evolutek/carte-alim/V5/Carte Alim V5-Power Tree.png

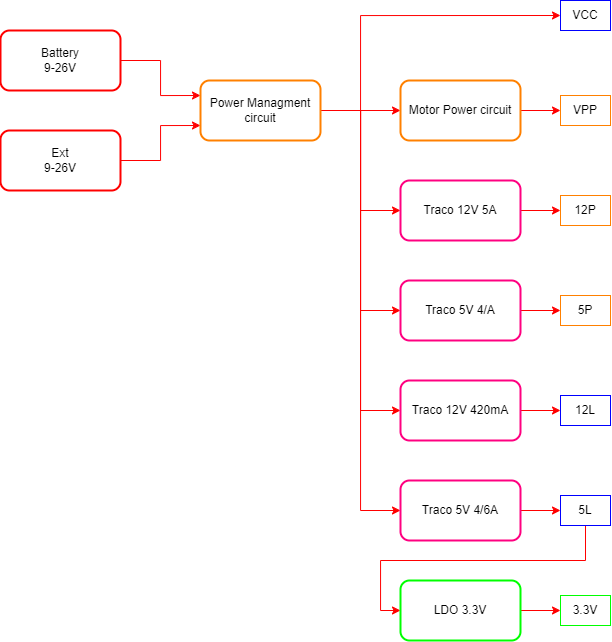
V5/Carte Alim V5-Power Tree.png
