evolutek/carte-alim/V5/Mapping STM32.png

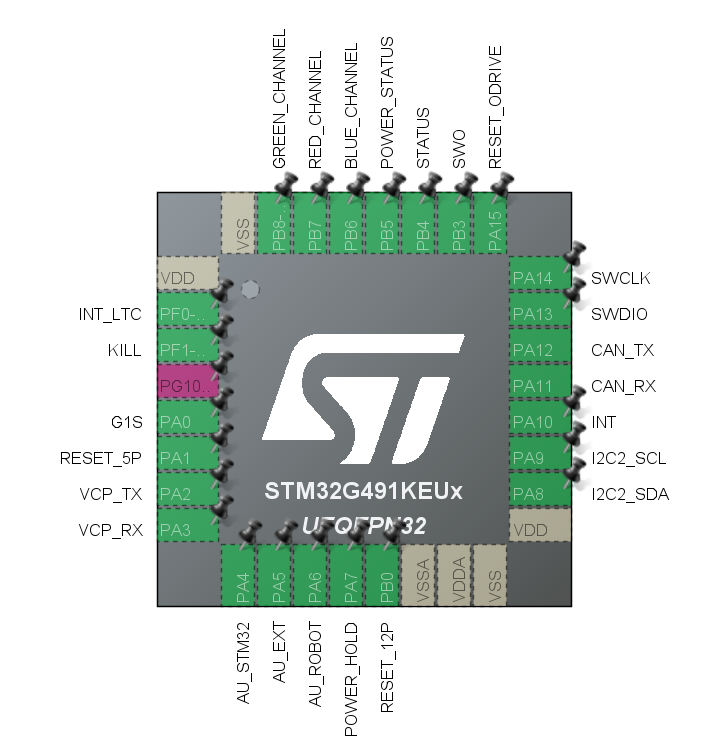
V5/Mapping STM32.png
