evolutek/carte-alim/Carte Dock LP-E10/Output/carte-dock-lp-e10.step

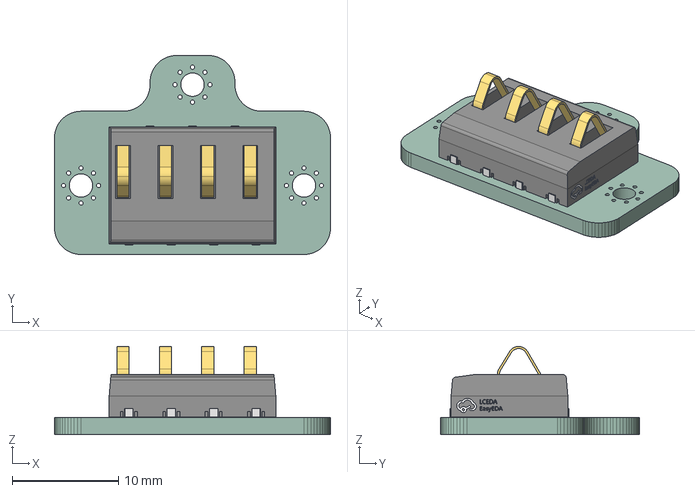
[picture p3: CAD file, 2025-04-11]
Carte Dock LP-E10/Output/carte-dock-lp-e10.step
26.0 x 18.8 x 8.30 mm
carte-dock-lp-e10 PCB
