evolutek/carte-alim/Carte Rack Batterie Vertical V1/Output/Carte Rack Batterie Vertical V1.step

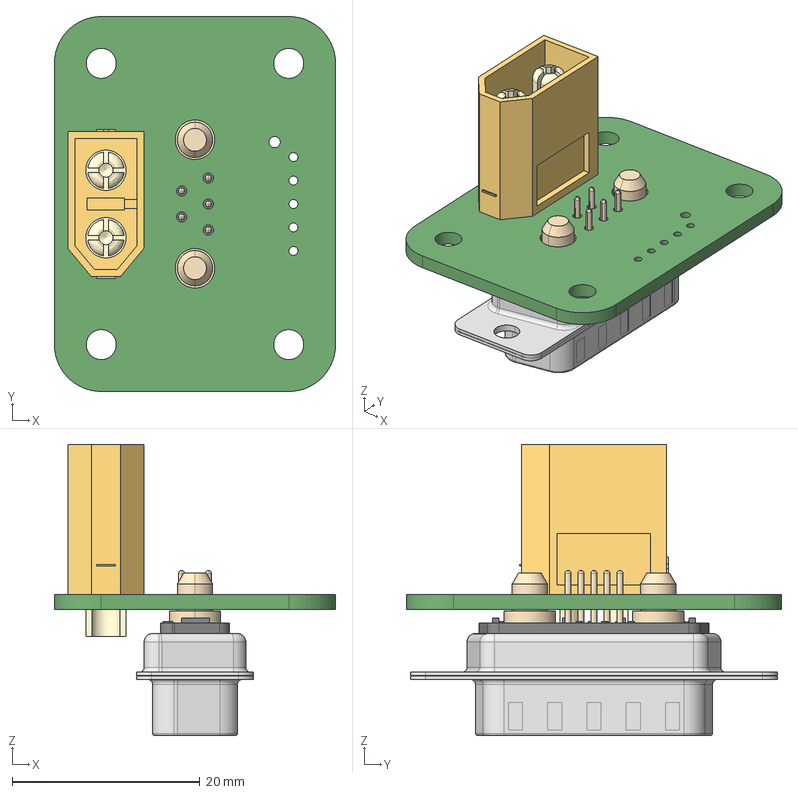
[picture p4: CAD file, 2021-10-24]
Carte Rack Batterie Vertical V1/Output/Carte Rack Batterie Vertical V1.step
30.0 x 40.0 x 31.1 mm
