evolutek/carte-alim/Hub puissance V1.0/Hub puissance V1.0.step

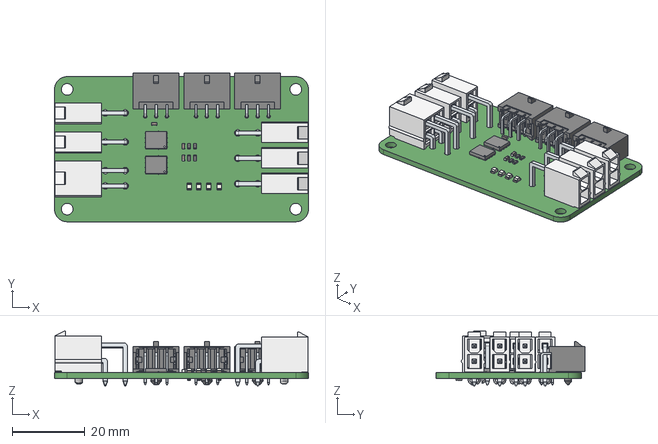
[picture p5: CAD file, 2021-01-19]
Hub puissance V1.0/Hub puissance V1.0.step
70.0 x 41.0 x 15.2 mm
