evolutek/carte-alim/Micro carte alim V1/Output/Schematics.pdf

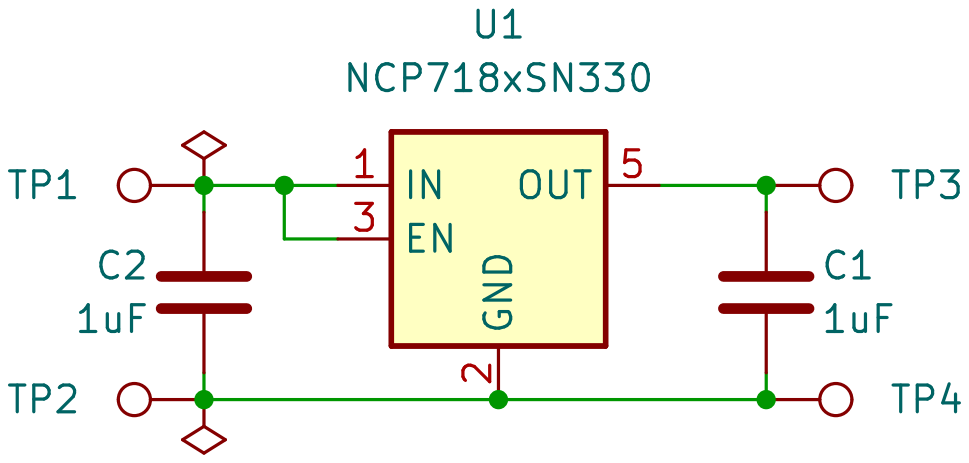
[picture p6: page 1]
