evolutek/carte-alim/Mini carte AU V1/Output/Schematics.pdf

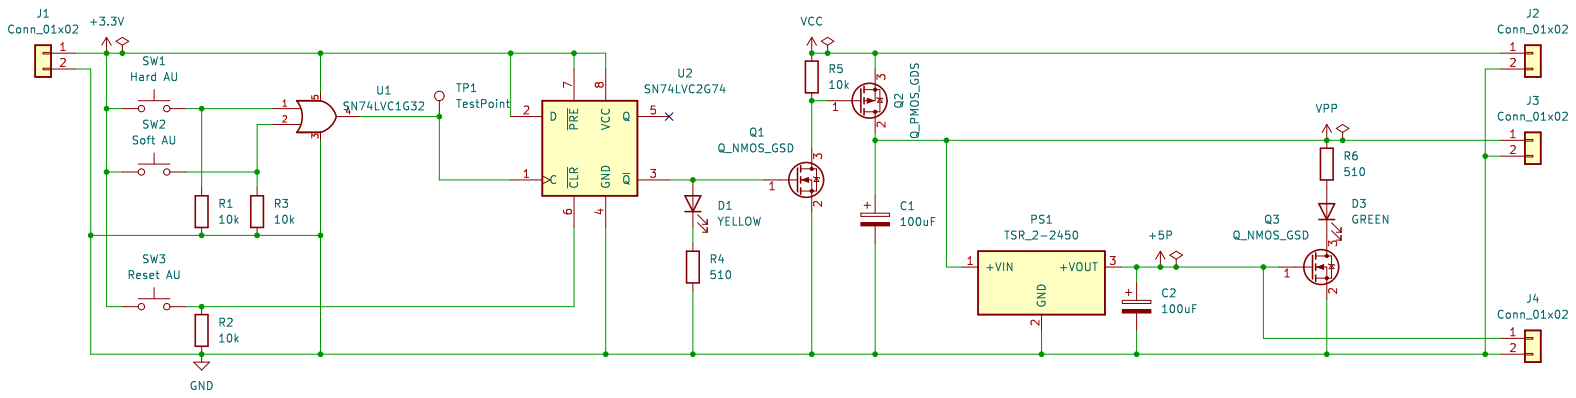
[picture p7: page 1]
