evolutek/carte-alim/Carte Dock LP-E10/Output/Schematics.pdf

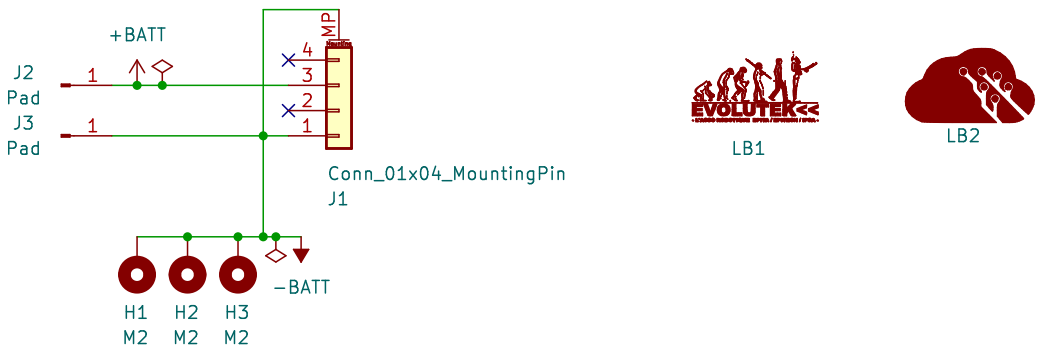
[picture p8: page 1]
