evolutek/carte-alim/PCB V2/Output/Schematics.pdf

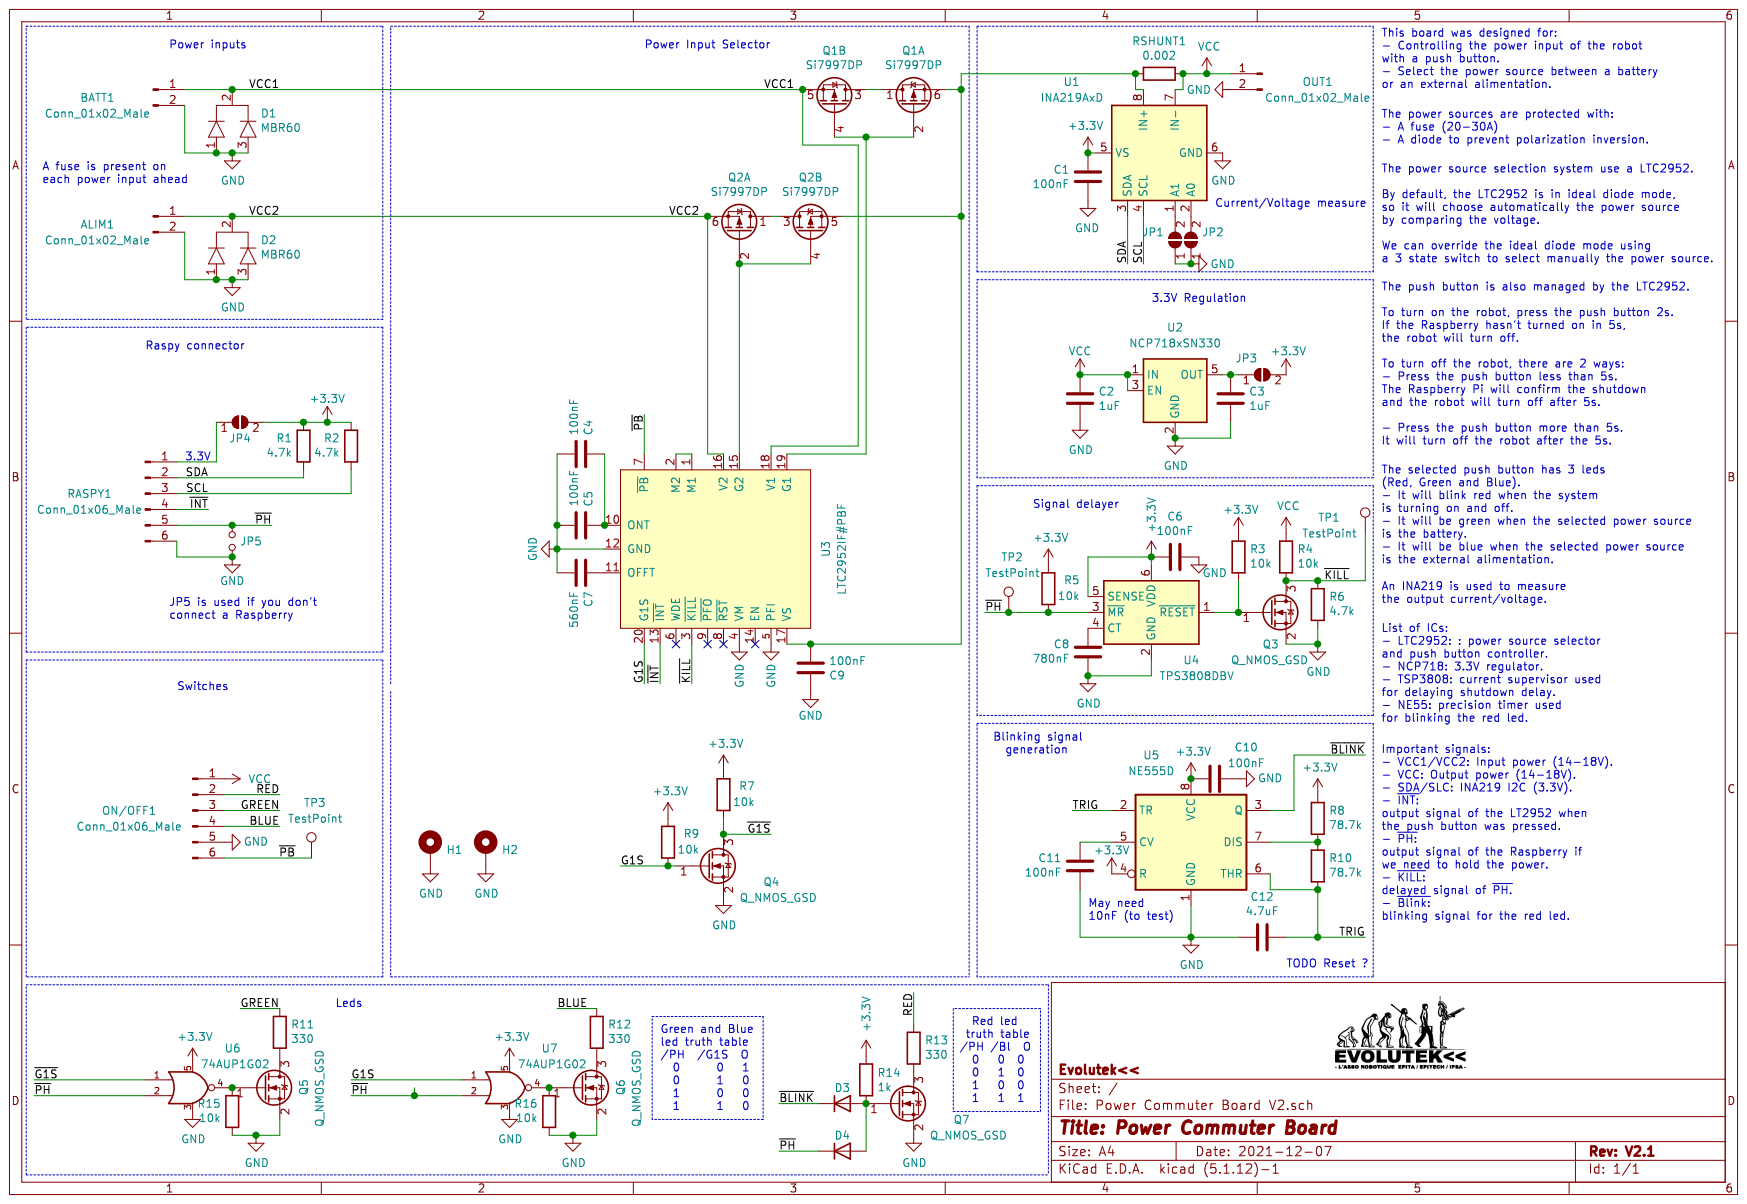
[picture p9: page 1]
