evolutek/carte-alim/Carte Rack Batterie Vertical V1/Output/Schematics.pdf

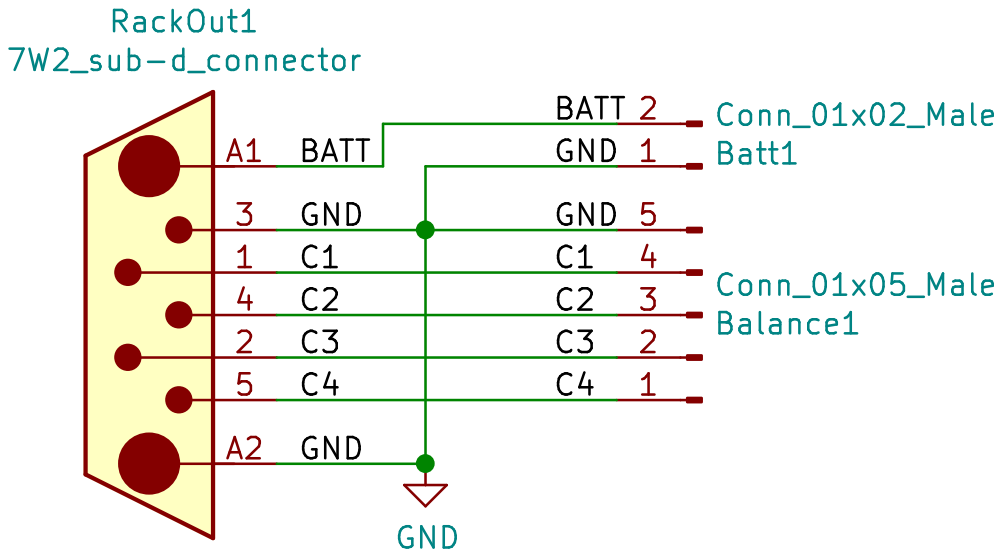
[picture p10: page 1]
