evolutek/carte-alim/Carte Rack Batterie Horizontal V1/Output/Schematics.pdf

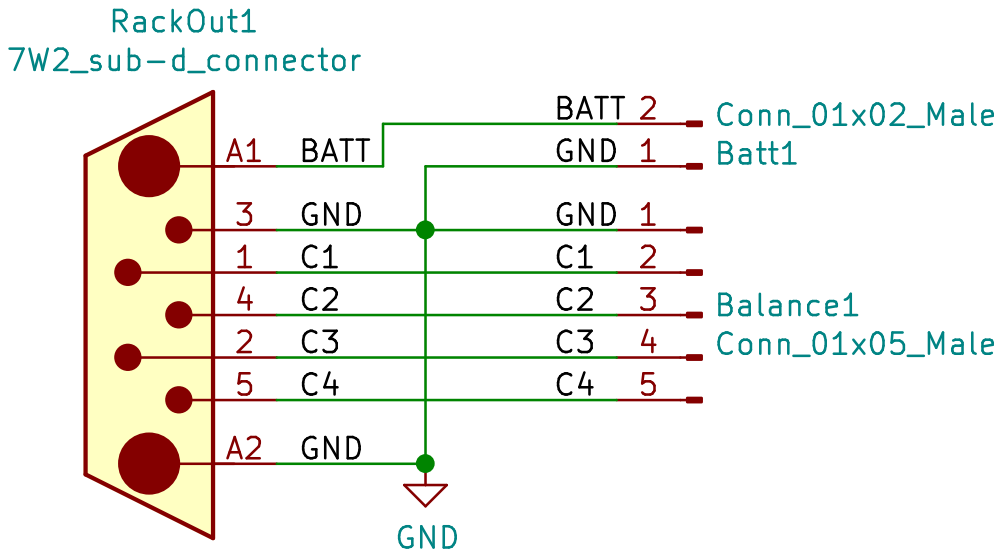
[picture p11: page 1]
