evolutek/carte-alim/Mini carte AU V1/Output/Board-Front.pdf

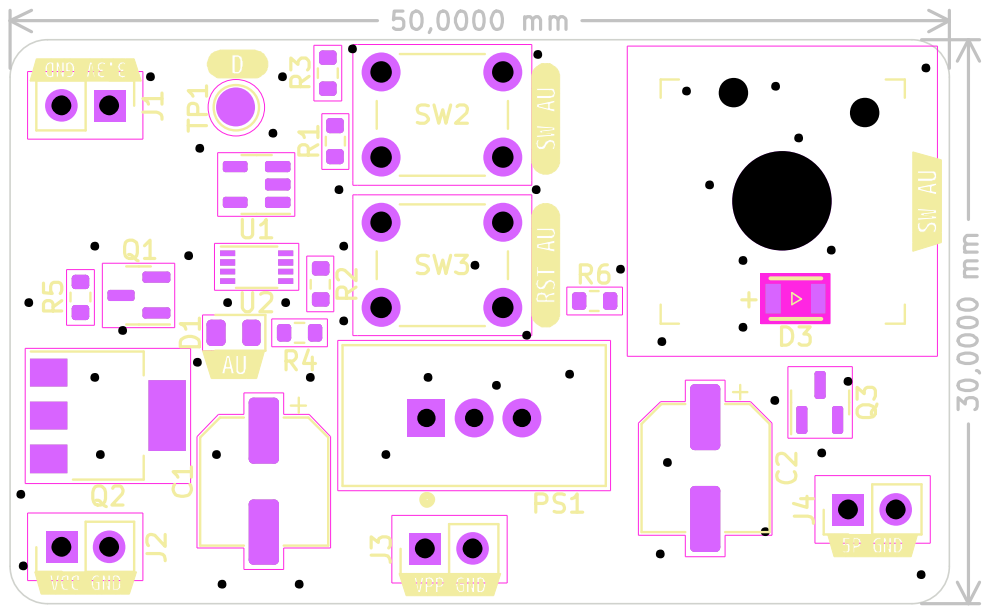
[picture p12: page 1]
