evolutek/carte-alim/Carte Dock LP-E10/Output/Board-Back.pdf

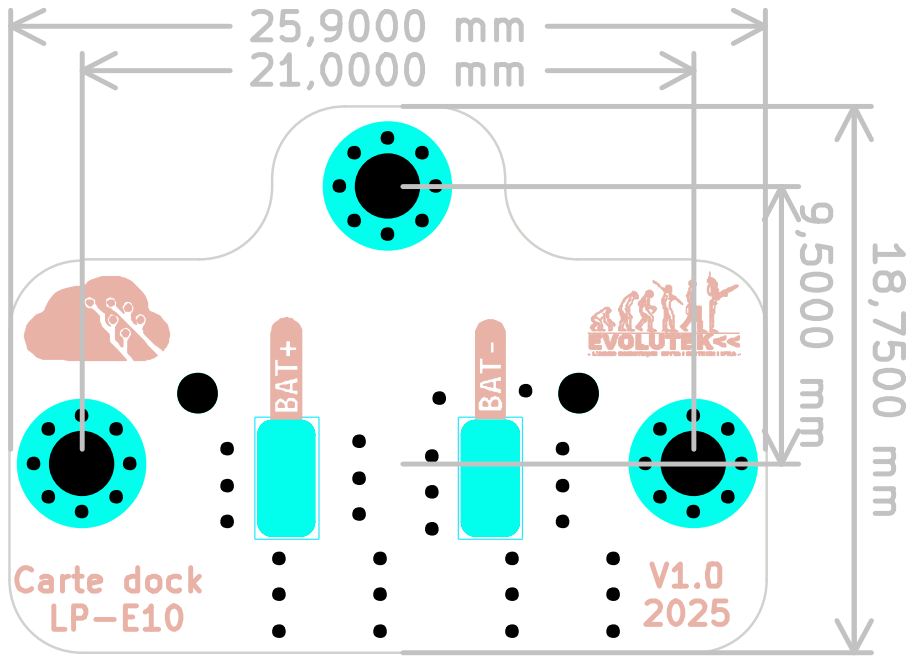
[picture p13: page 1]
