evolutek/carte-alim/Carte Dock LP-E10/Output/Board-Front.pdf

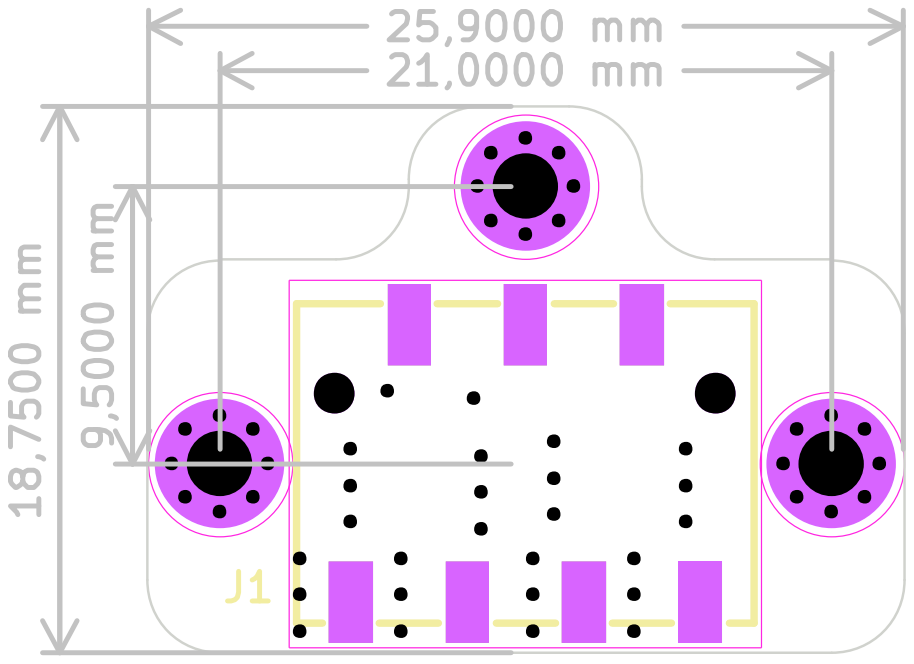
[picture p14: page 1]
