evolutek/carte-alim/PCB V1/Schematics.pdf

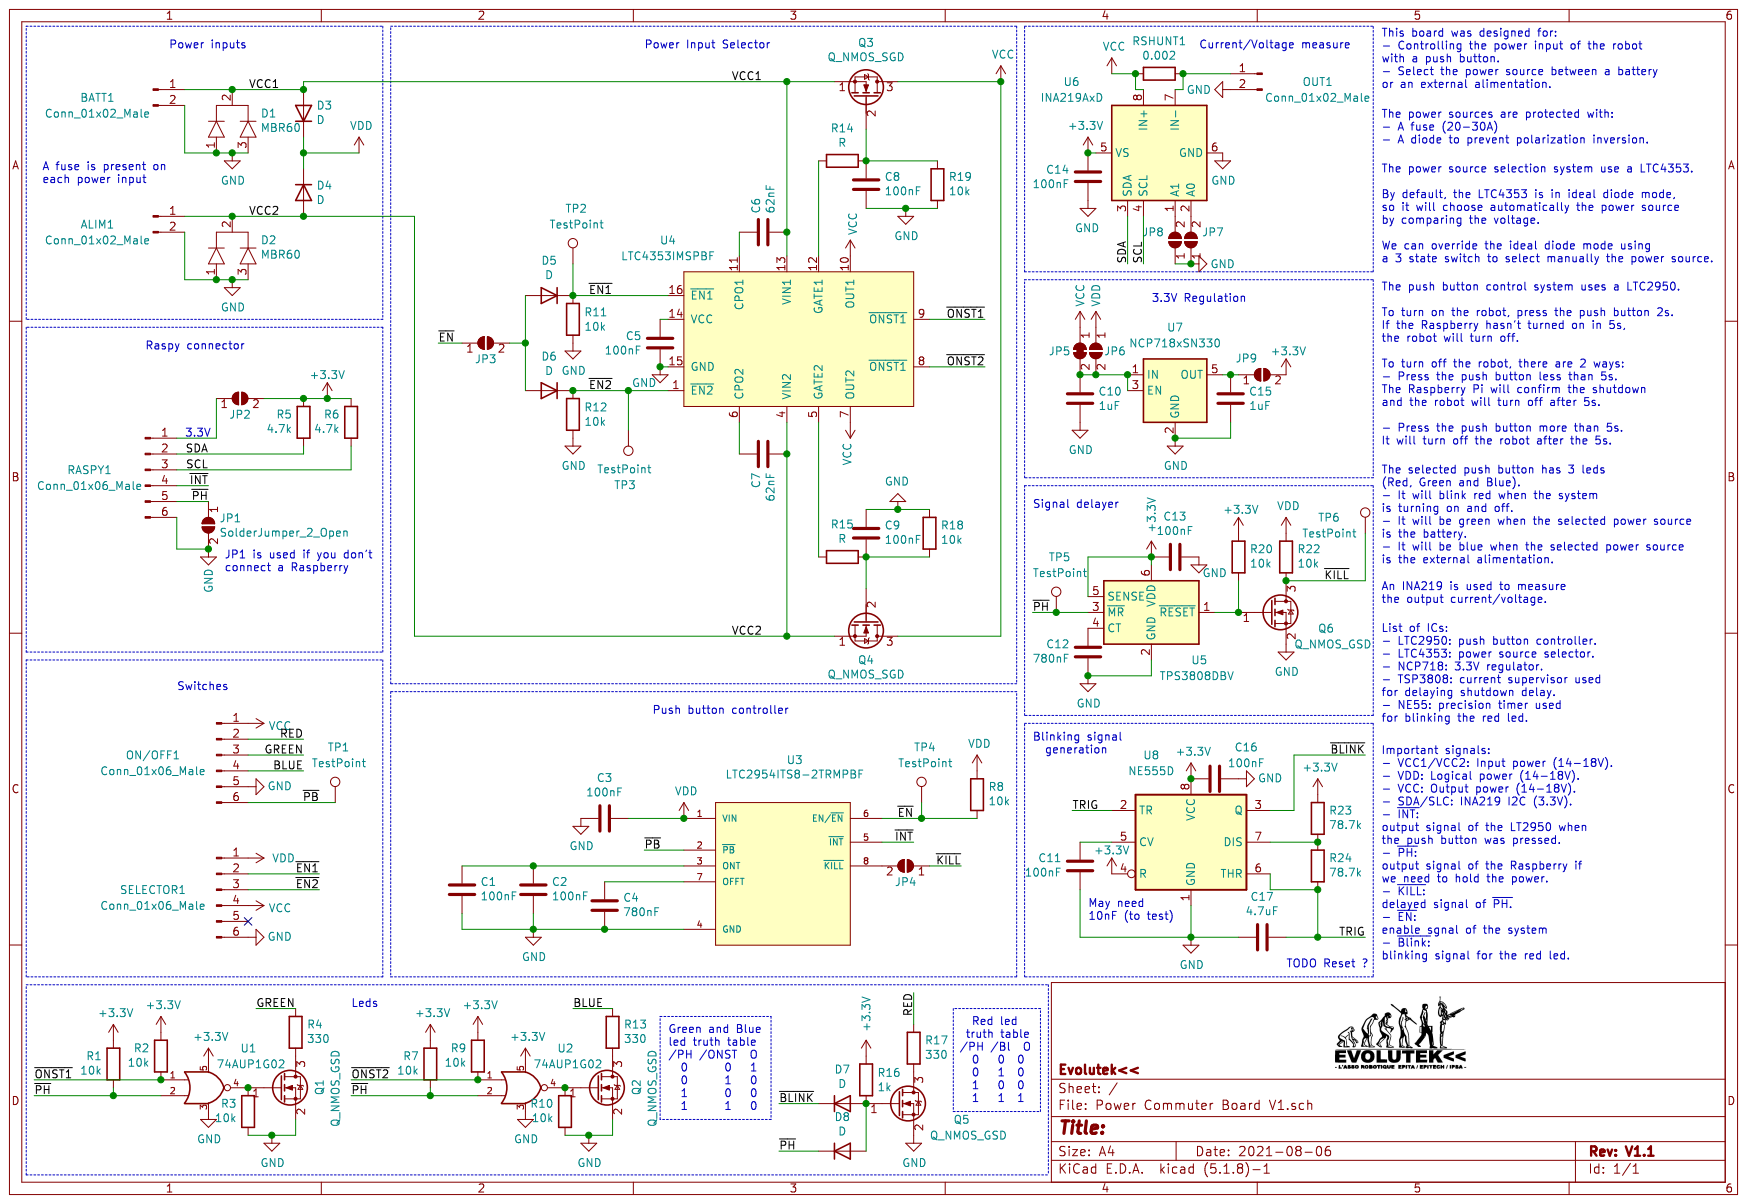
[picture p15: page 1]
