evolutek/carte-alim/Hub puissance V1/Schematics.pdf

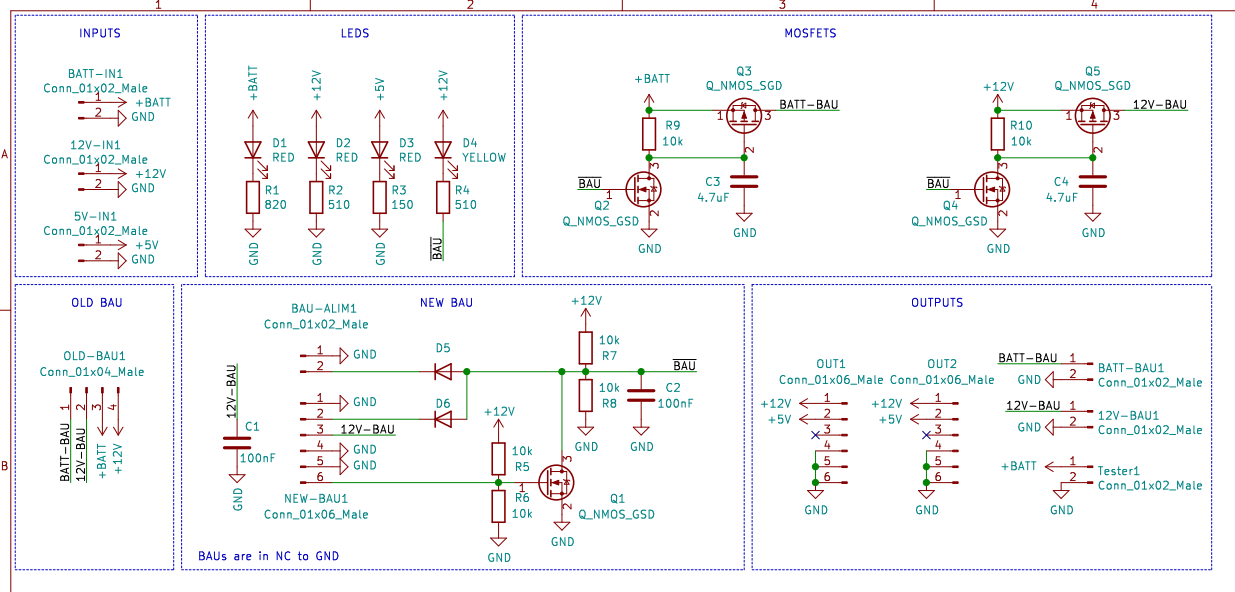
[picture p16: page 1]
