evolutek/carte-alim/USB C montage panneau/Output/Board-Back.pdf

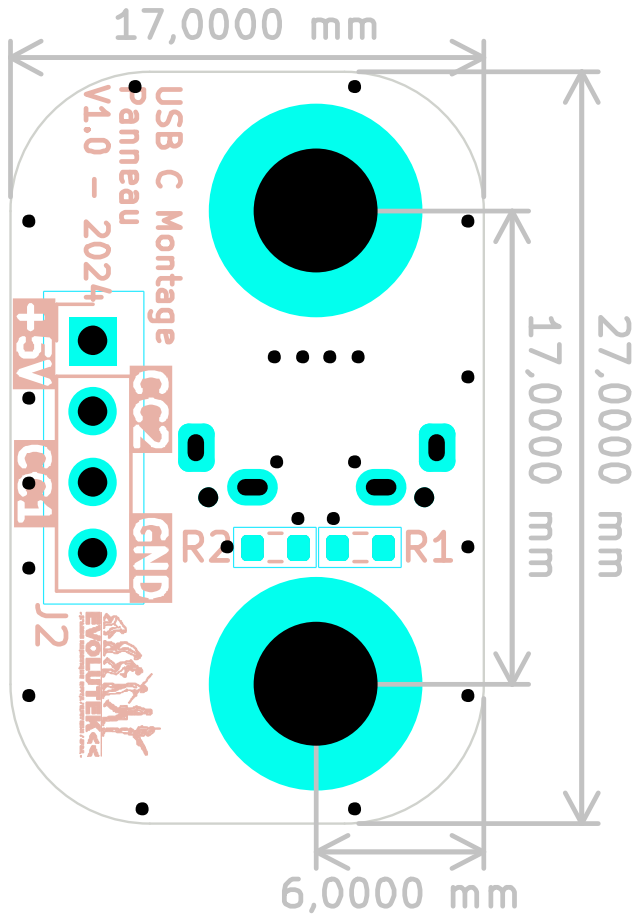
[picture p24: page 1]
