evolutek/carte-alim/USB C montage panneau/Output/Board-Front.pdf

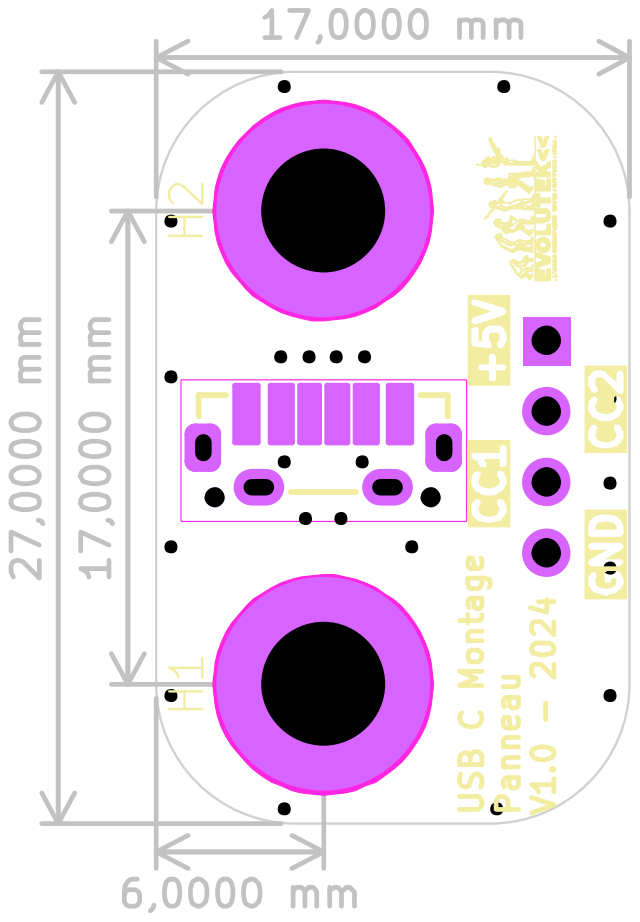
[picture p25: page 1]
