evolutek/carte-alim/USB C montage panneau/Output/Schematics.pdf

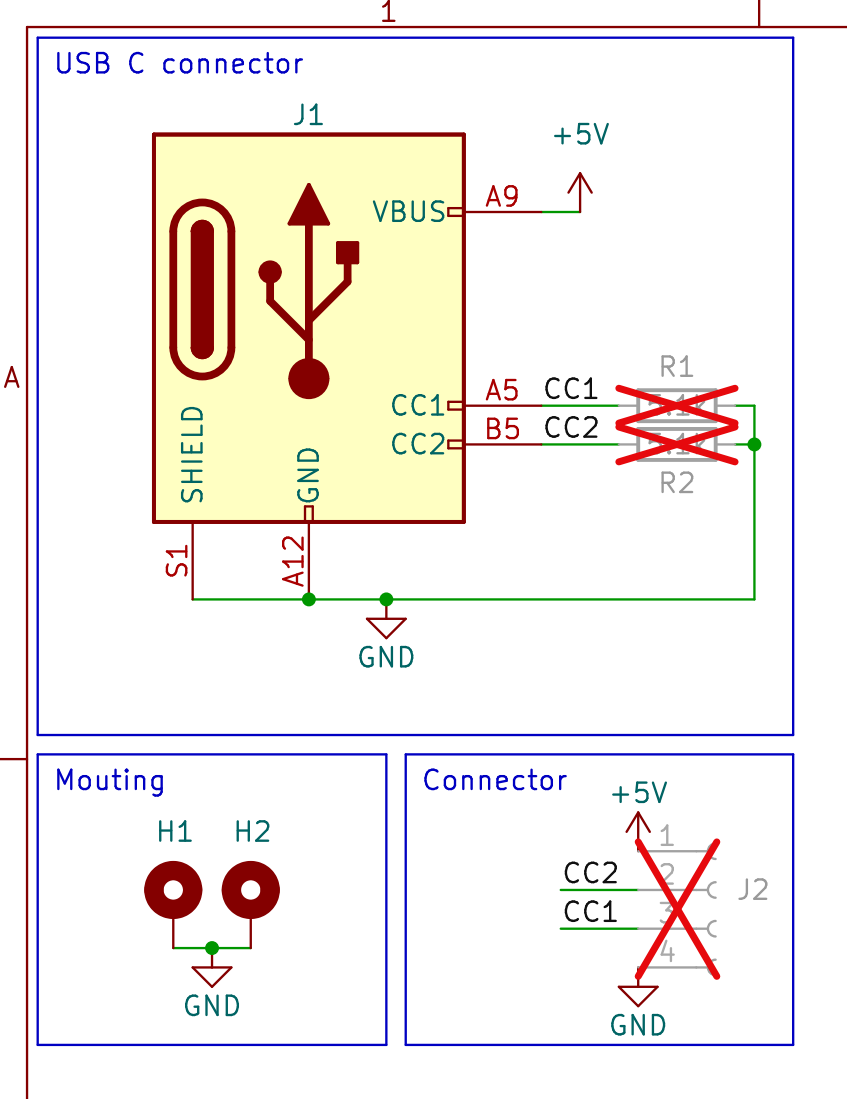
[picture p26: page 1]
