evolutek/carte-alim/Mini carte alim V2/Output/Schematics.pdf

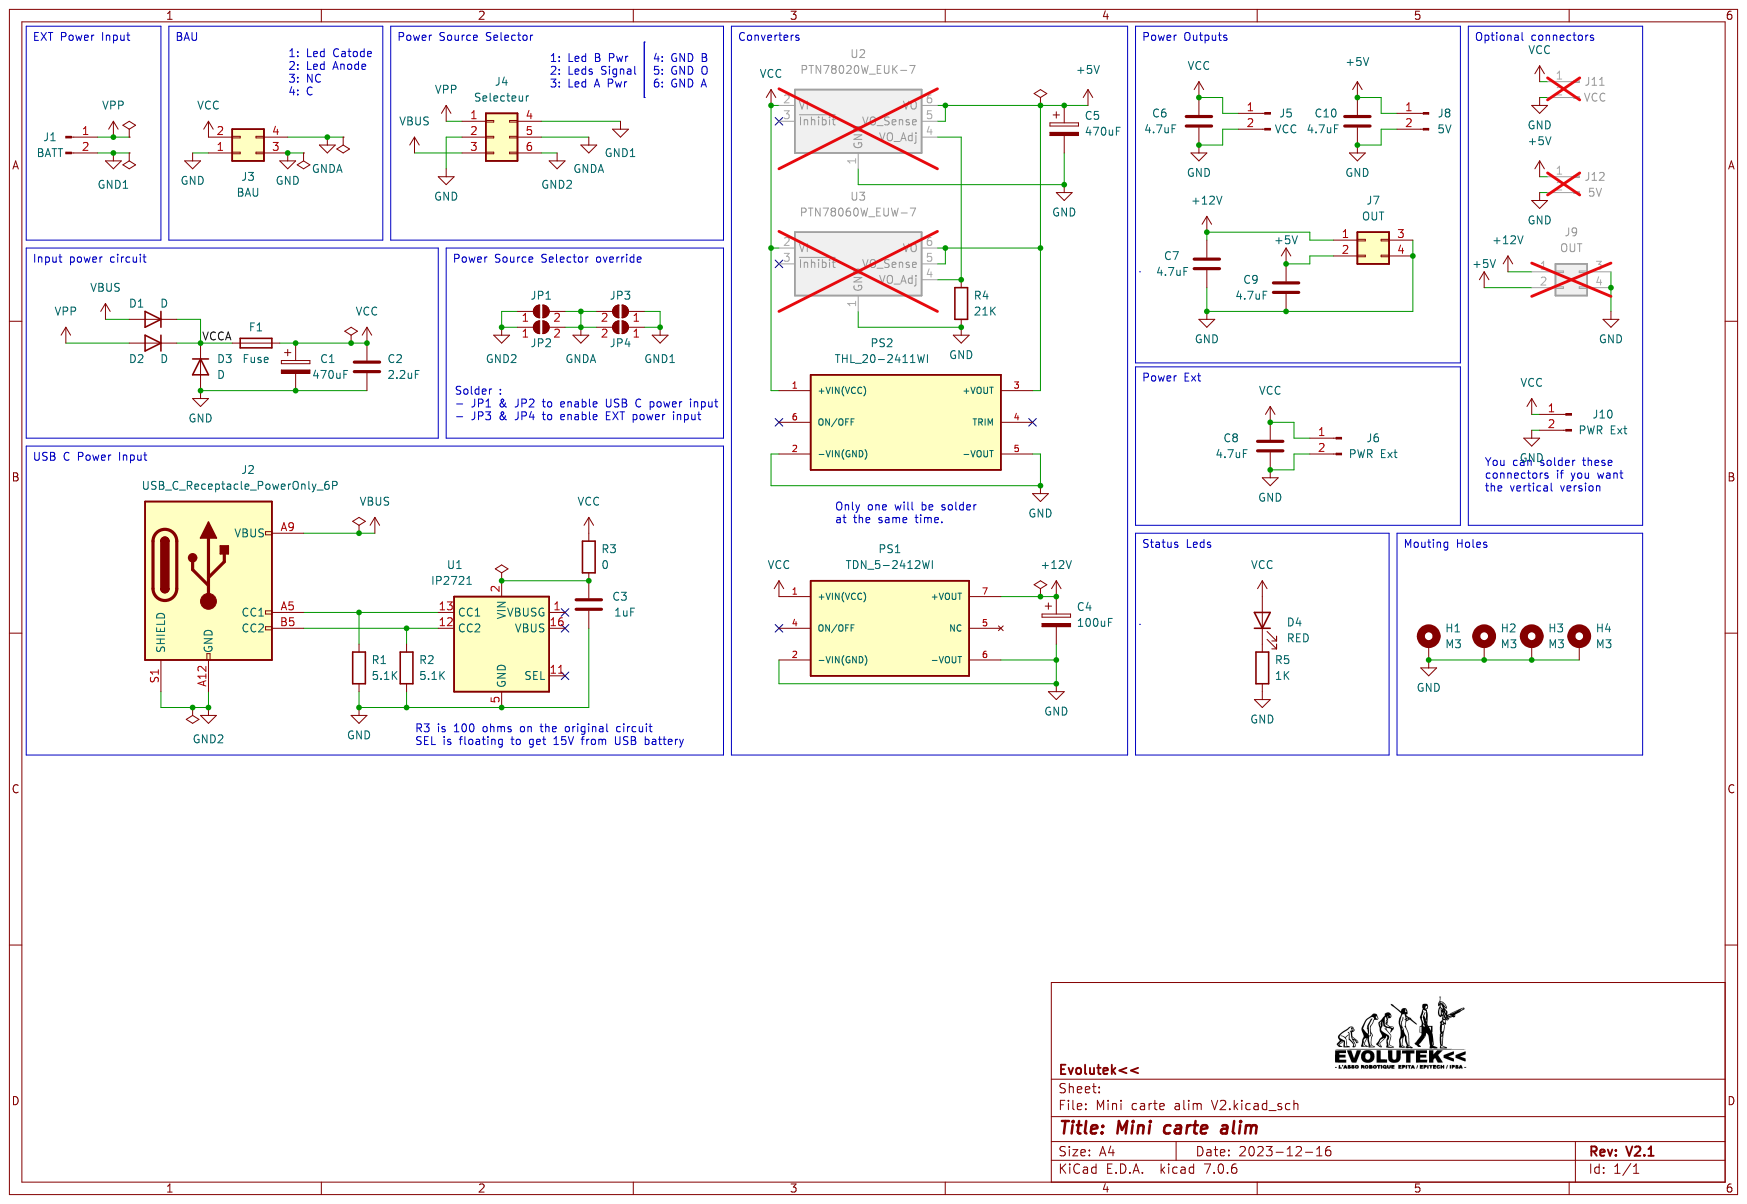
[picture p27: page 1]
