evolutek/carte-alim/Mini carte alim V1/Output/Schematics.pdf

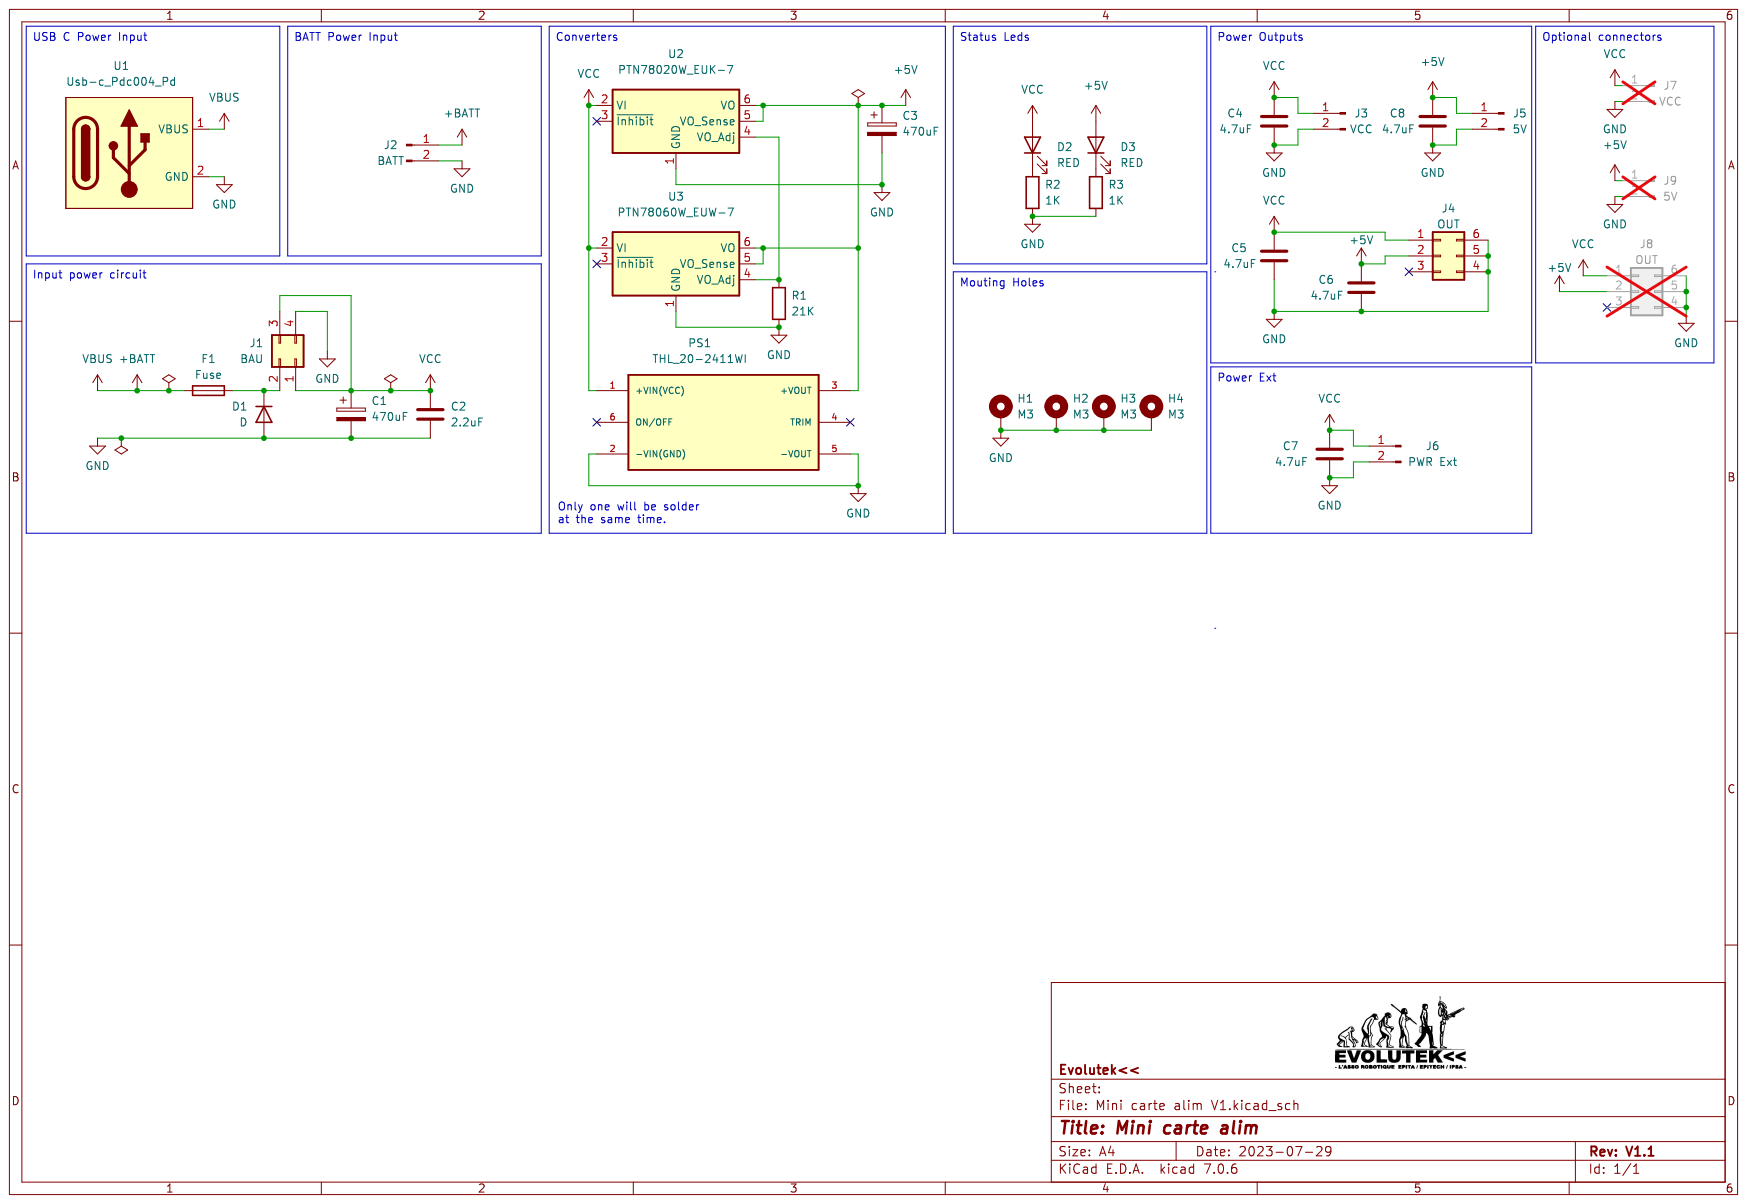
[picture p28: page 1]
