evolutek/carte-alim/Carte Boitier BAU/Output/Schematics.pdf

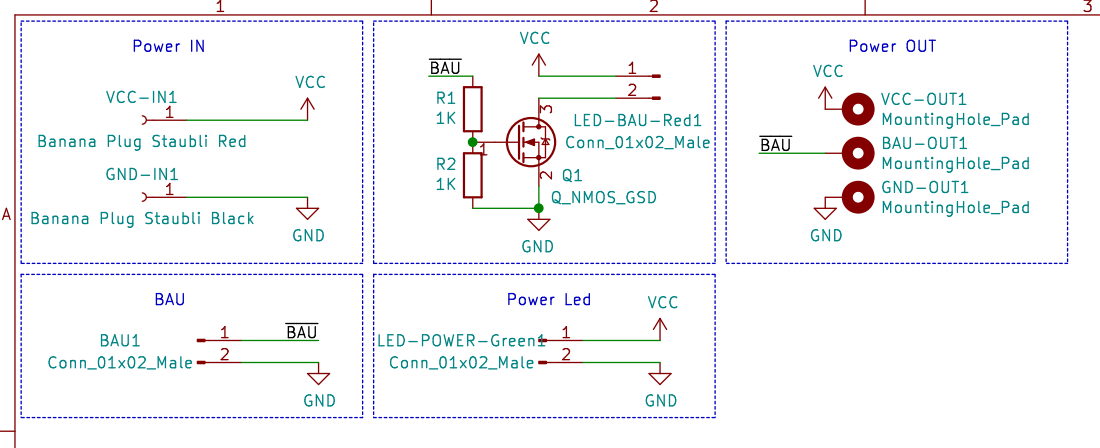
[picture p29: page 1]
