evolutek/carte-alim/V4/Output/Schematics.pdf

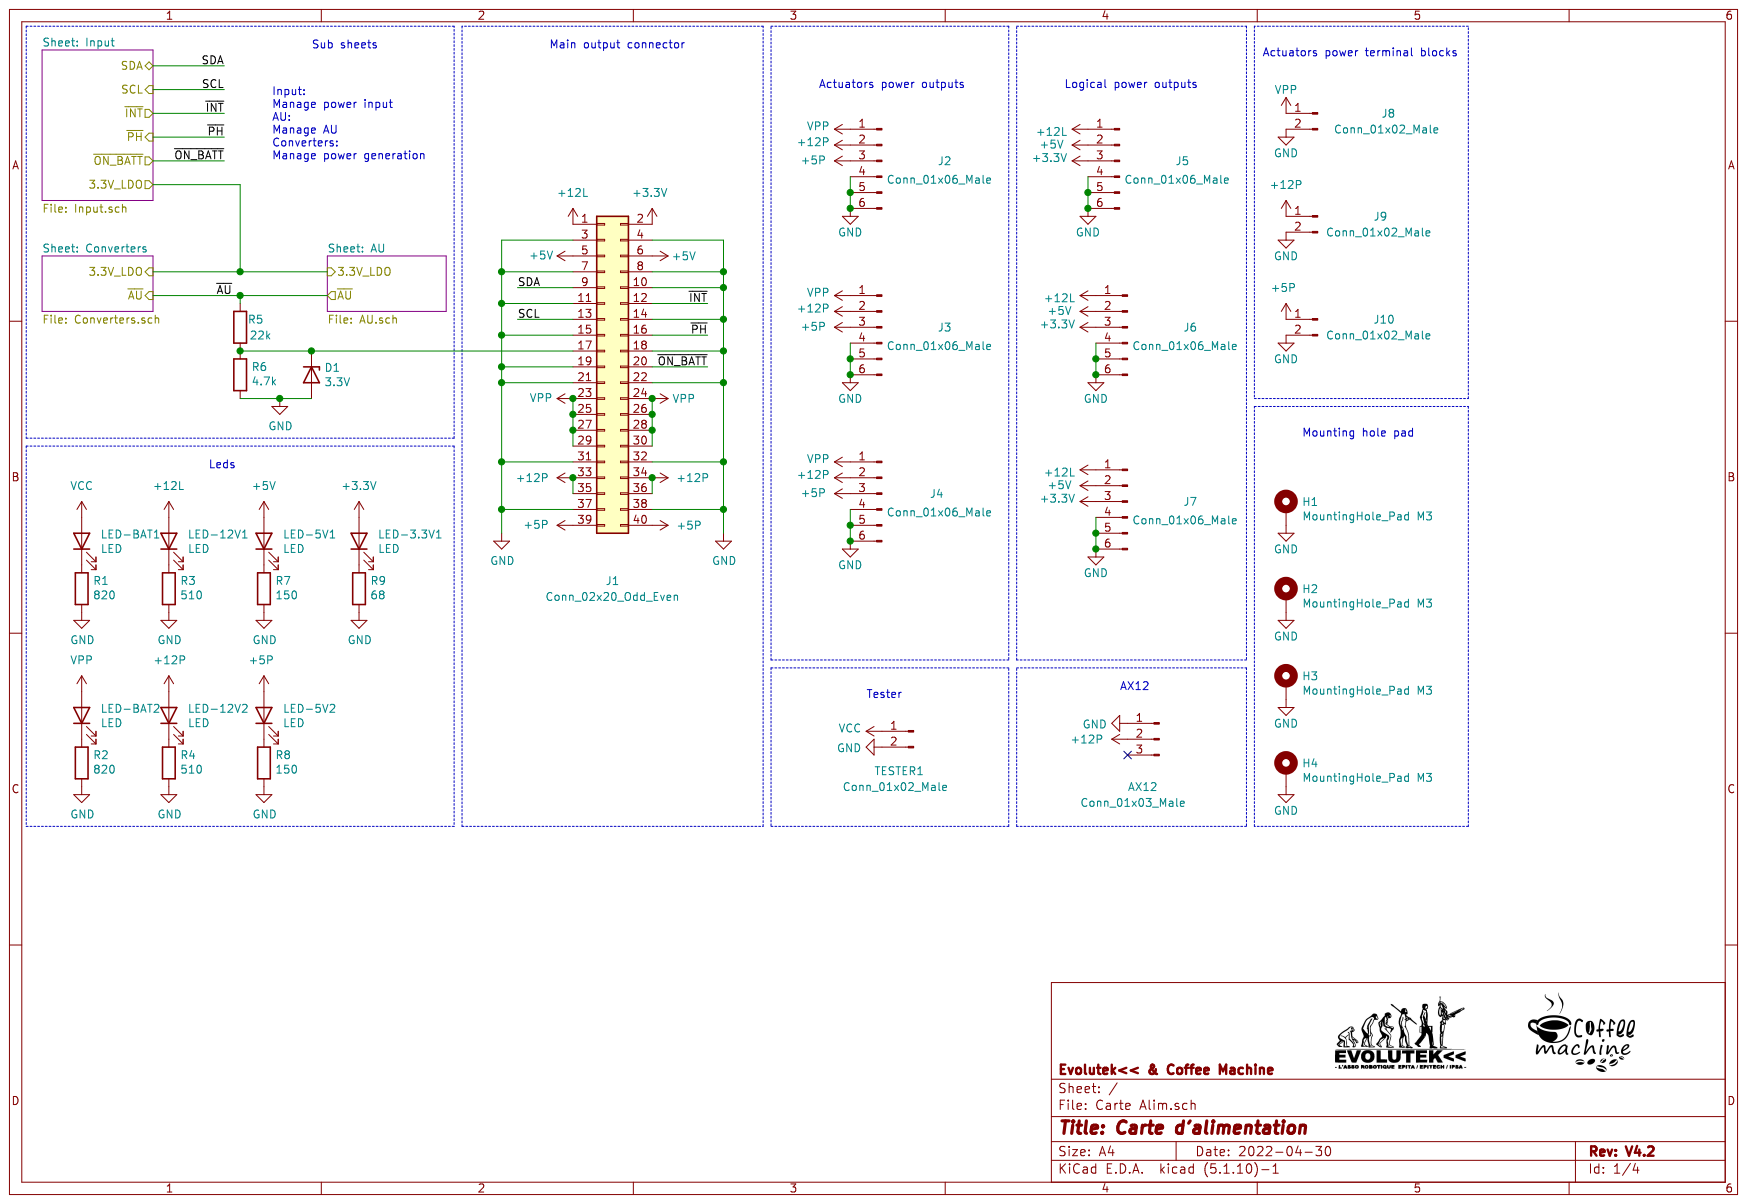
[picture p30: page 1]

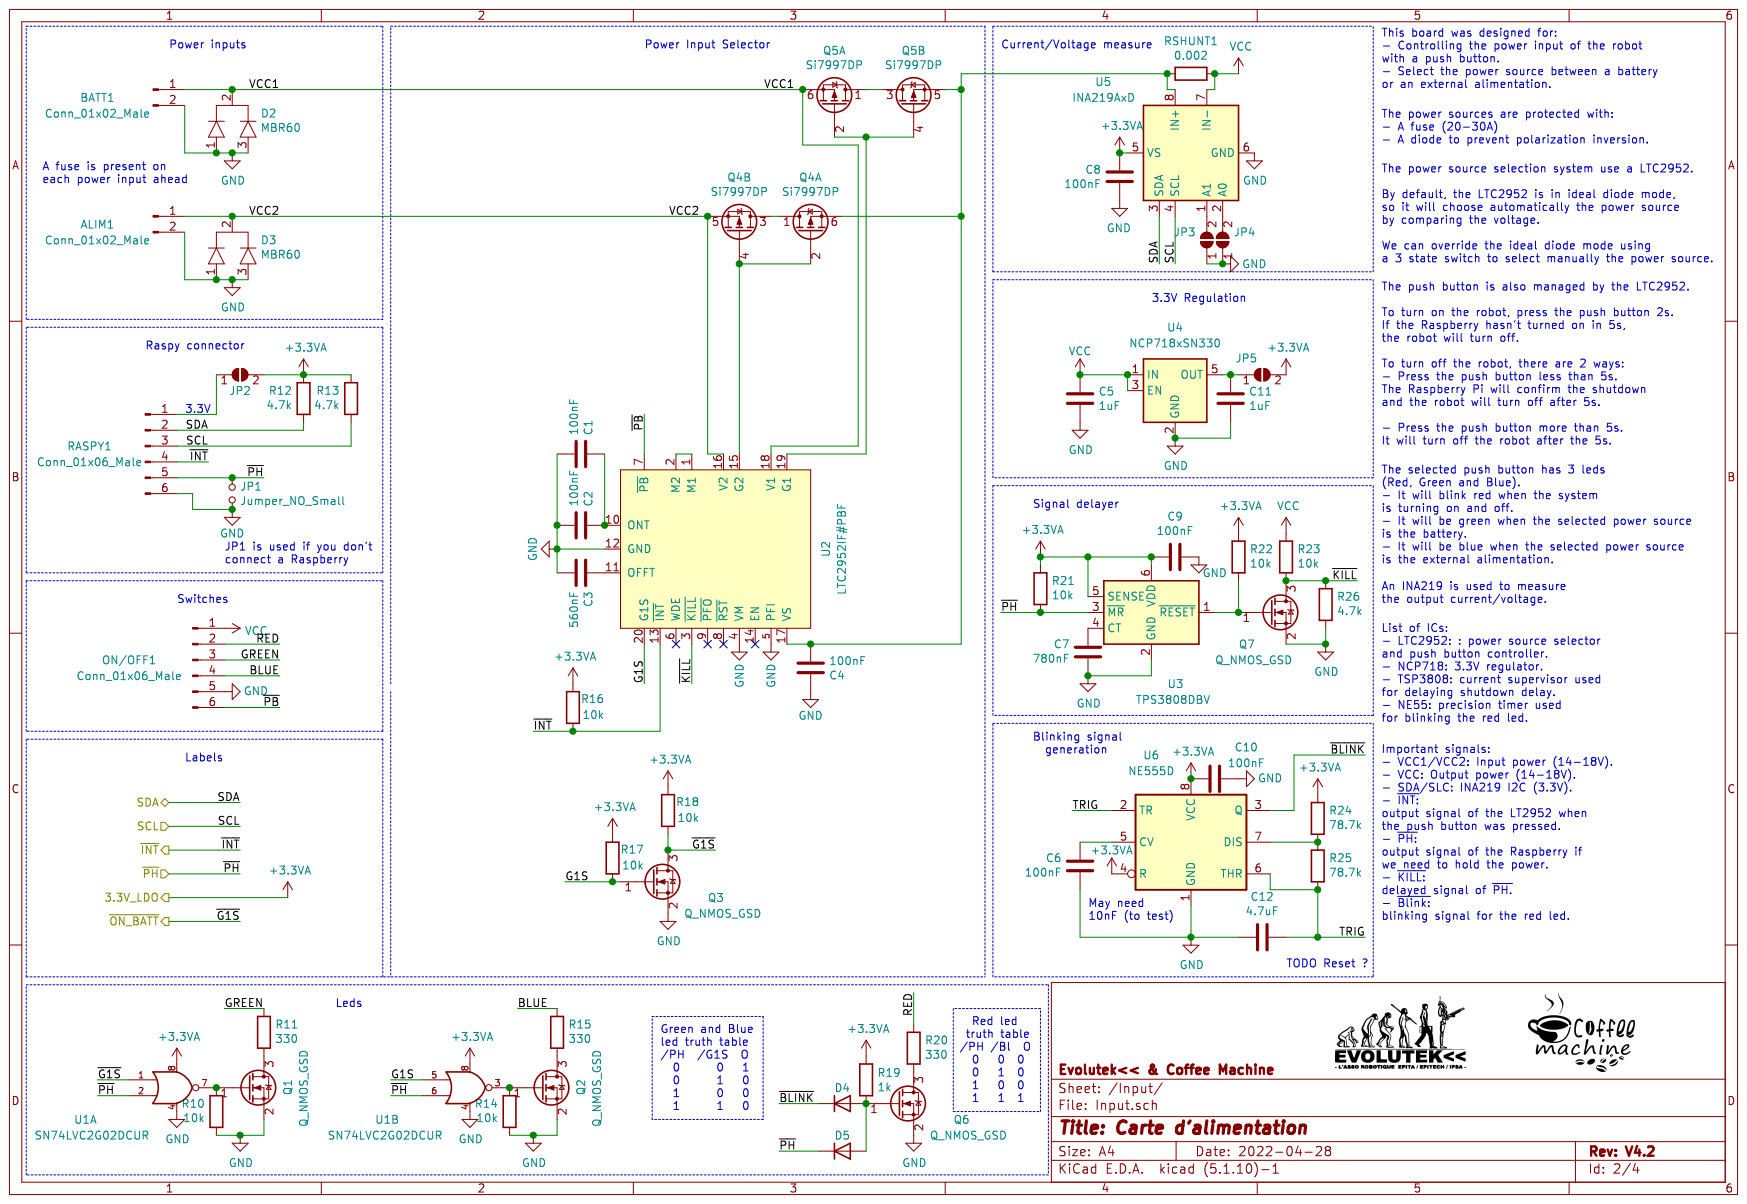
[picture p31: page 2]

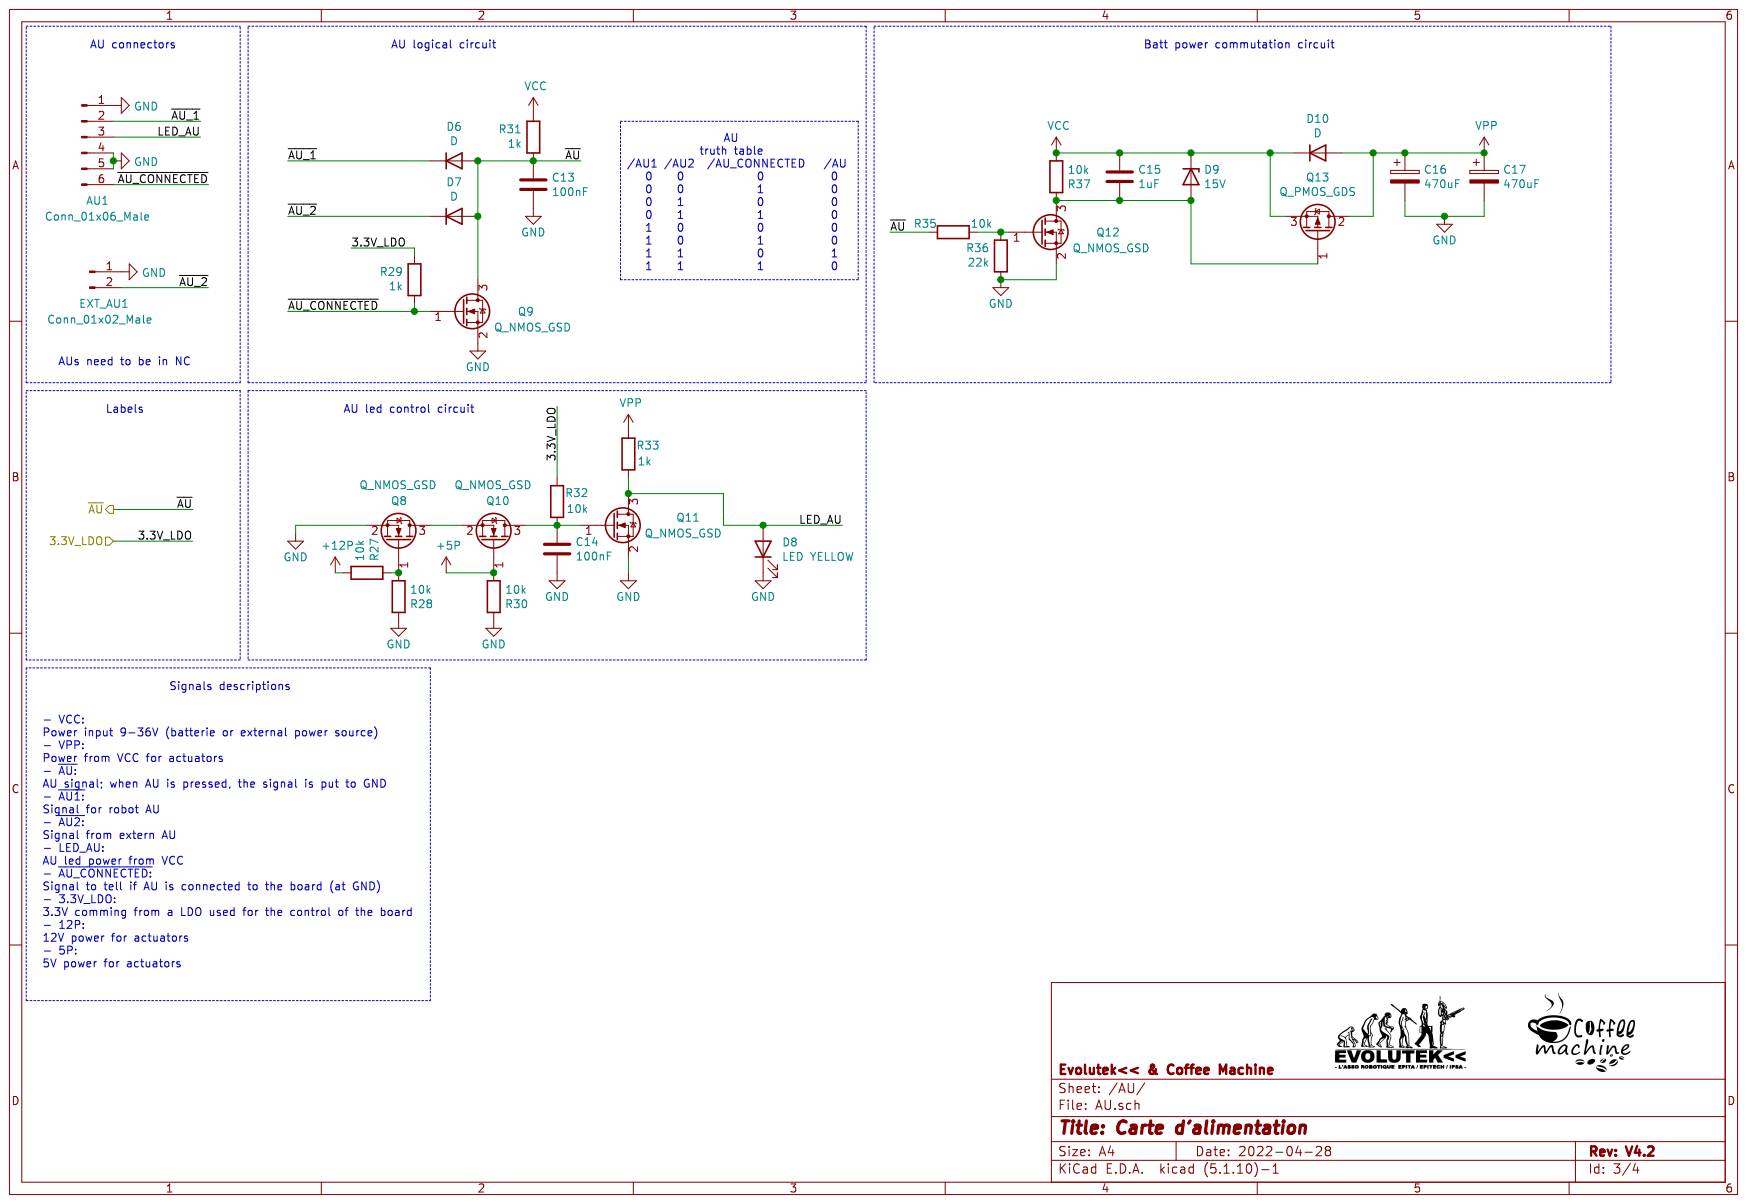
[picture p32: page 3]

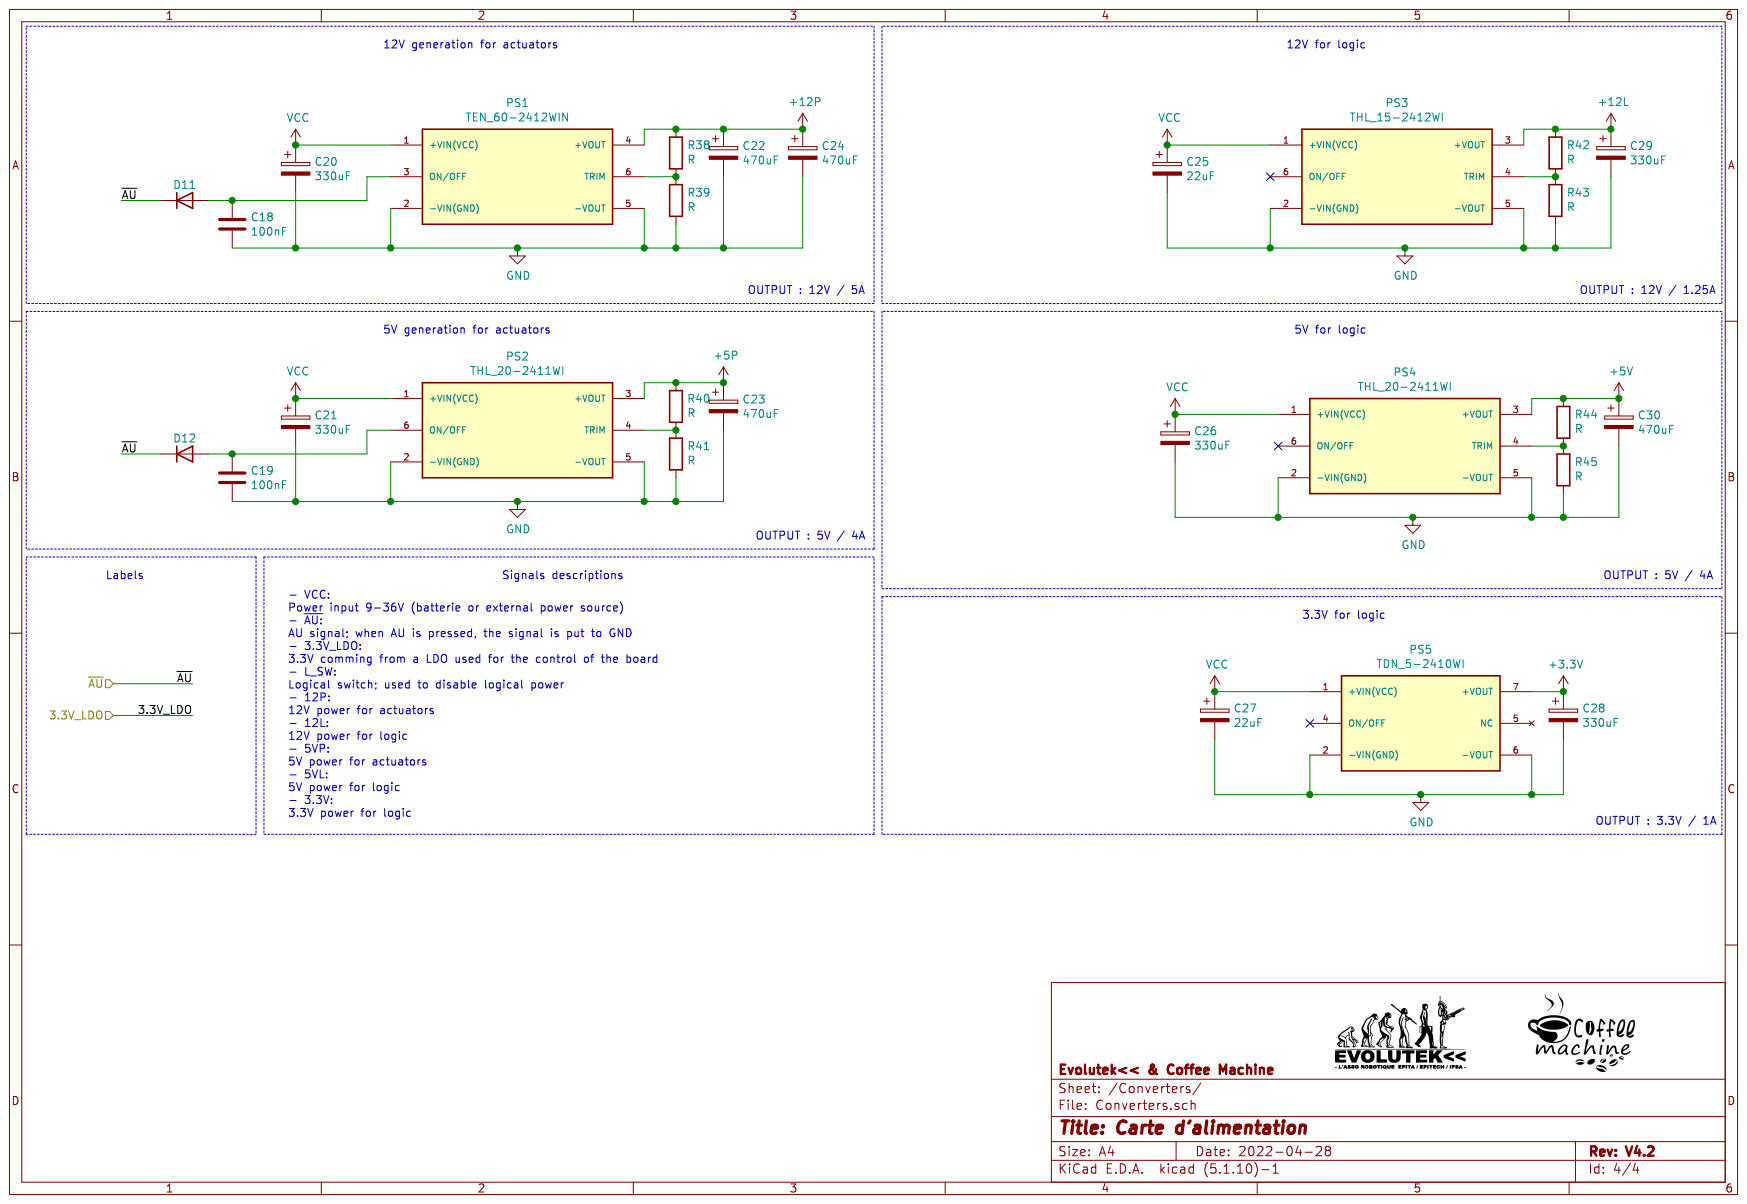
[picture p33: page 4]
