evolutek/carte-alim/V3/EvoPowerMain.pdf

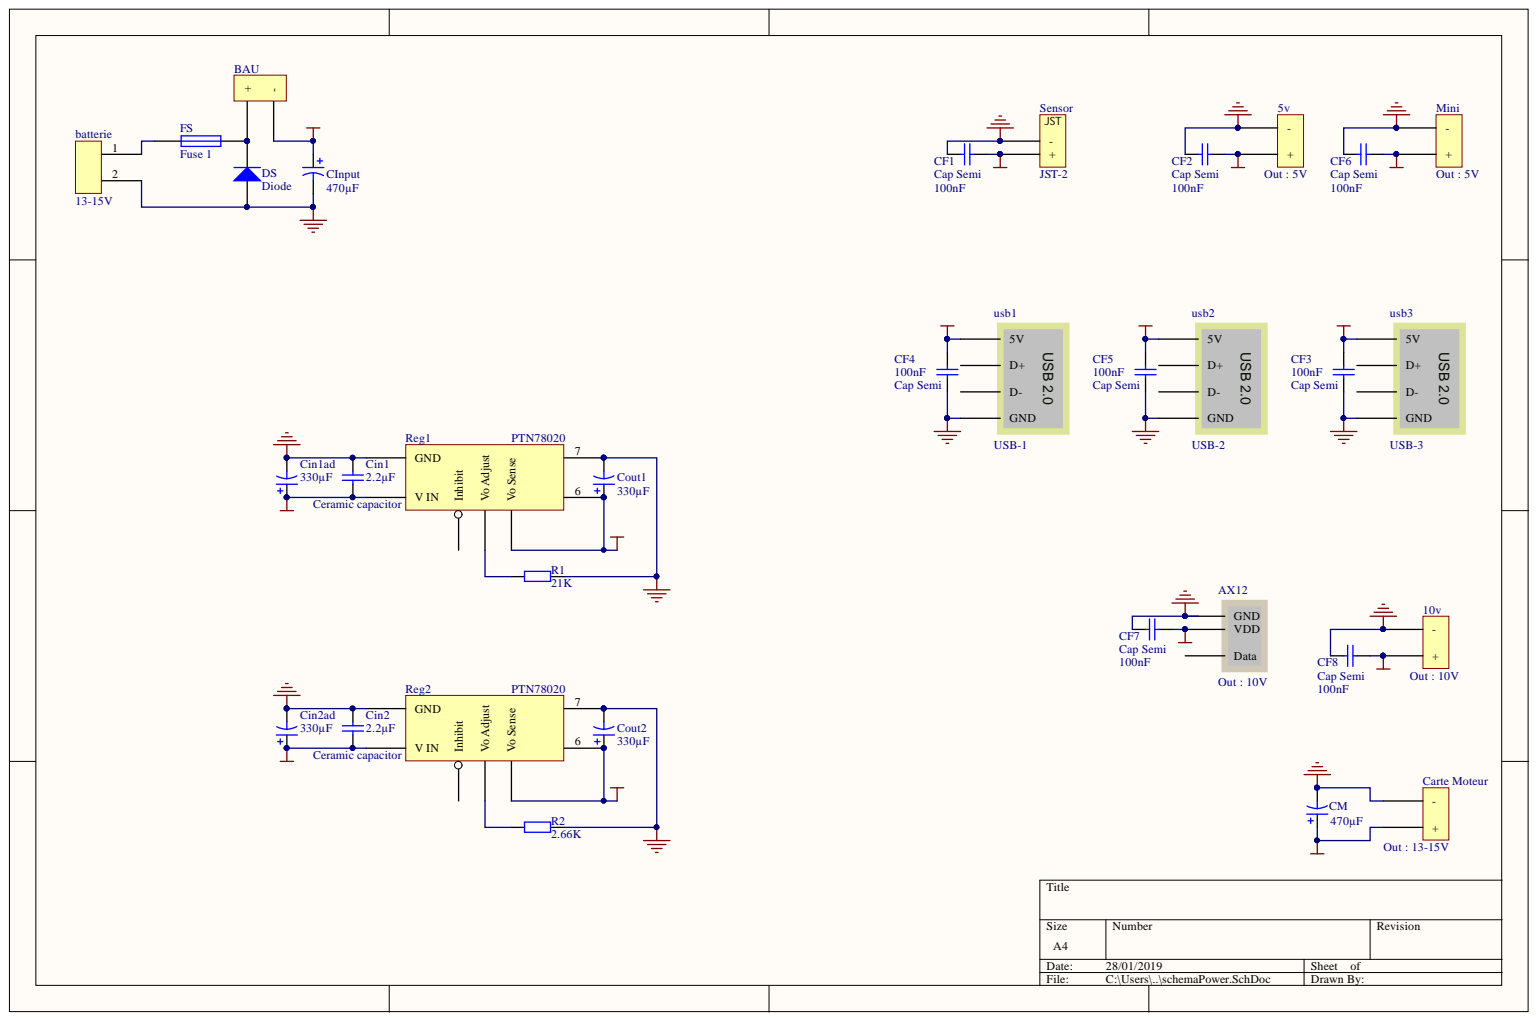
[picture p34: page 1]

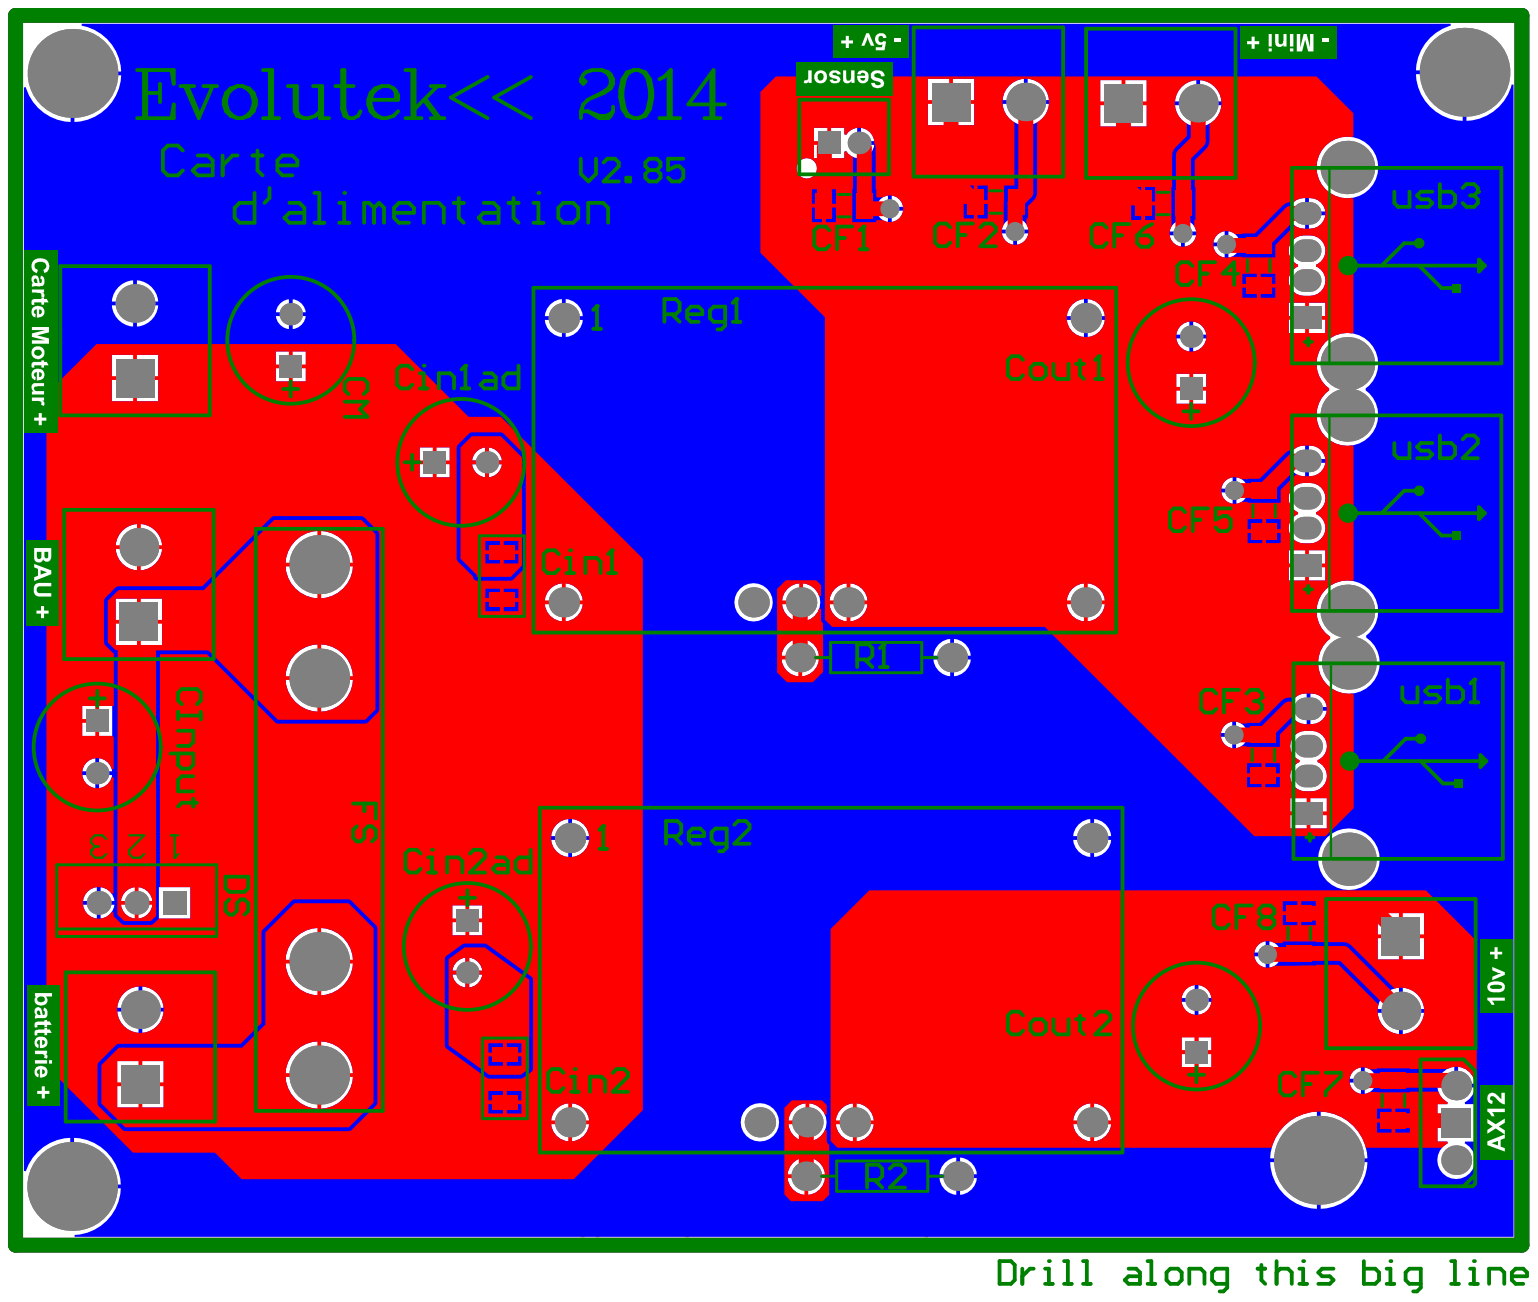
[picture p35: page 2]
