evolutek/carte-alim/V3/schemaPower.pdf

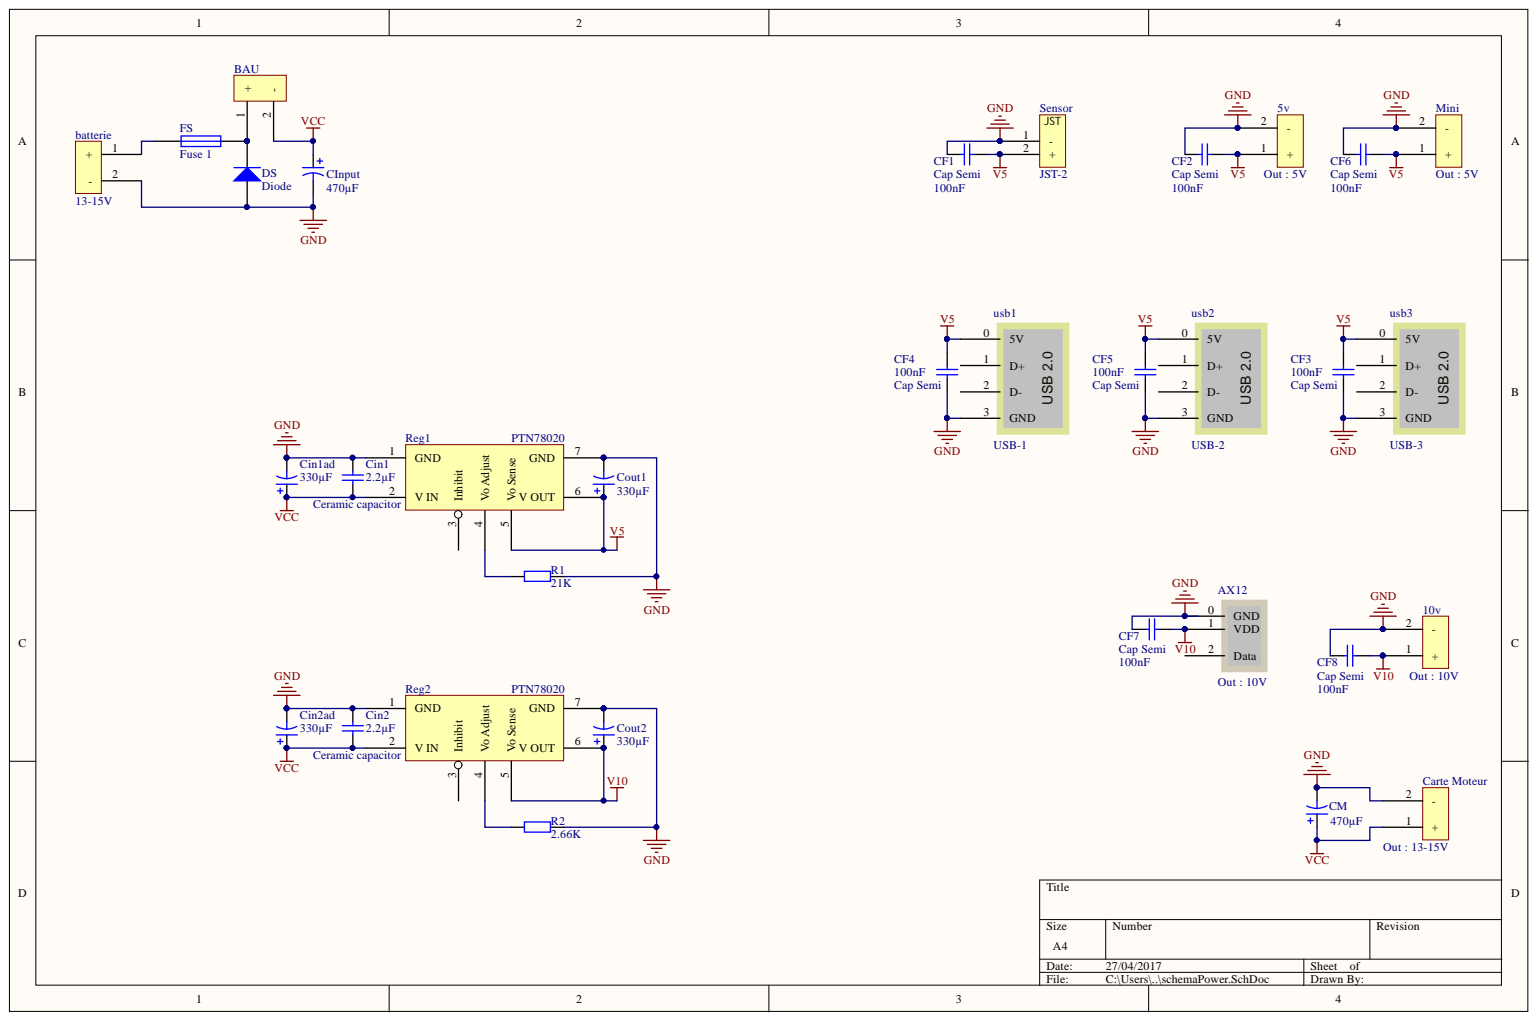
[picture p36: page 1]
