evolutek/carte-alim/V5/Output-Evolutek/Board-Back.pdf

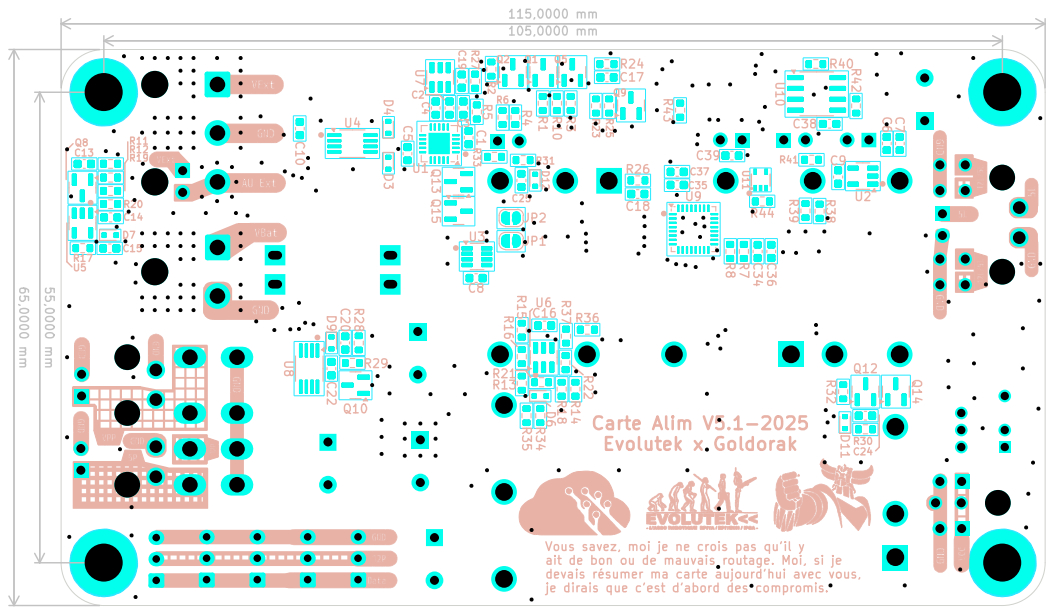
[picture p37: page 1]
