evolutek/carte-alim/V5/Output-Evolutek/Board-Front.pdf

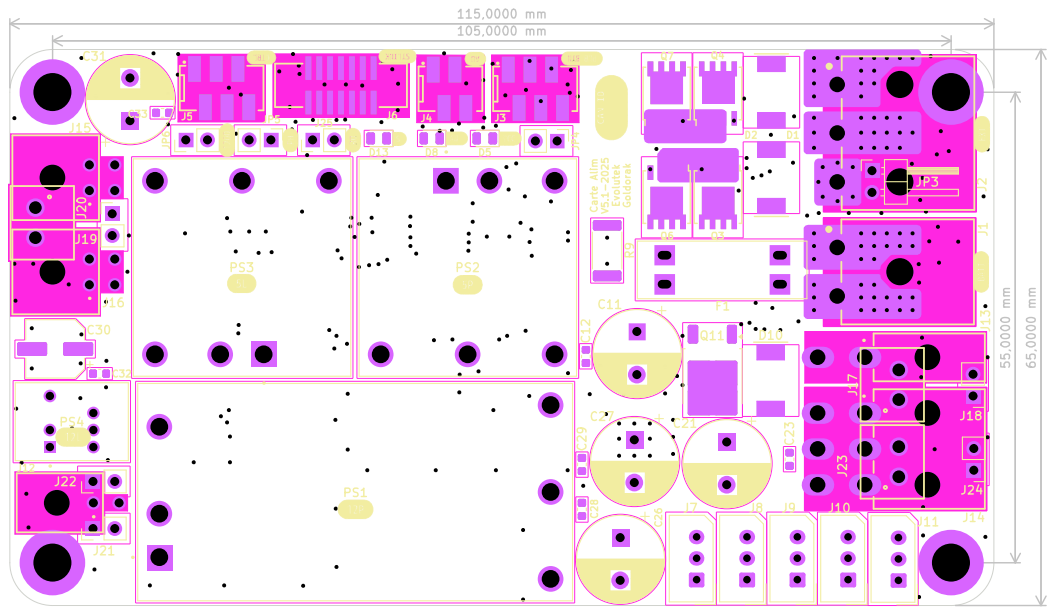
[picture p38: page 1]
