evolutek/carte-alim/Mini carte alim V2/Output/Board-Back.pdf

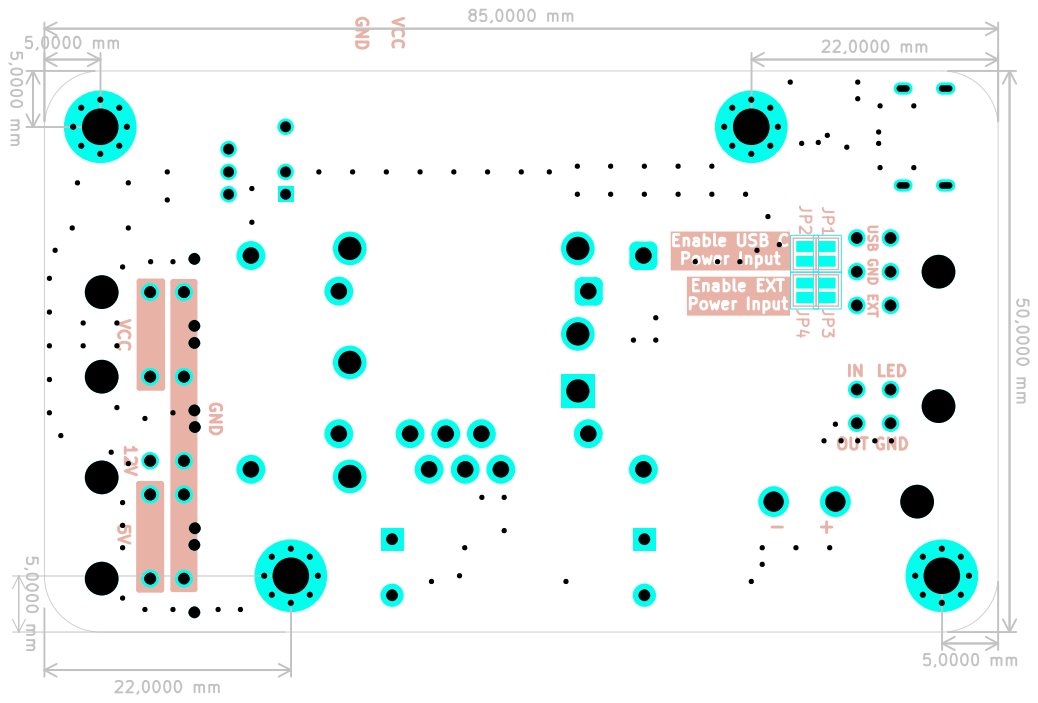
[picture p39: page 1]
