evolutek/carte-alim/Mini carte alim V2/Output/Board-Front.pdf

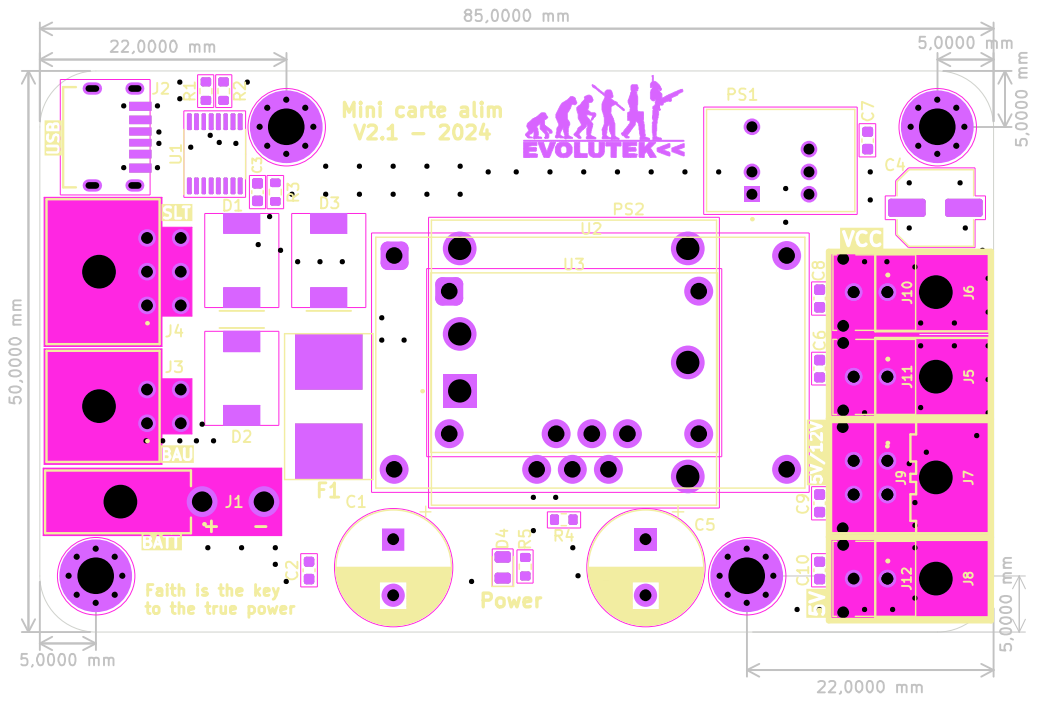
[picture p40: page 1]
