evolutek/carte-alim/Mini carte alim V1/Output/Board-Back.pdf

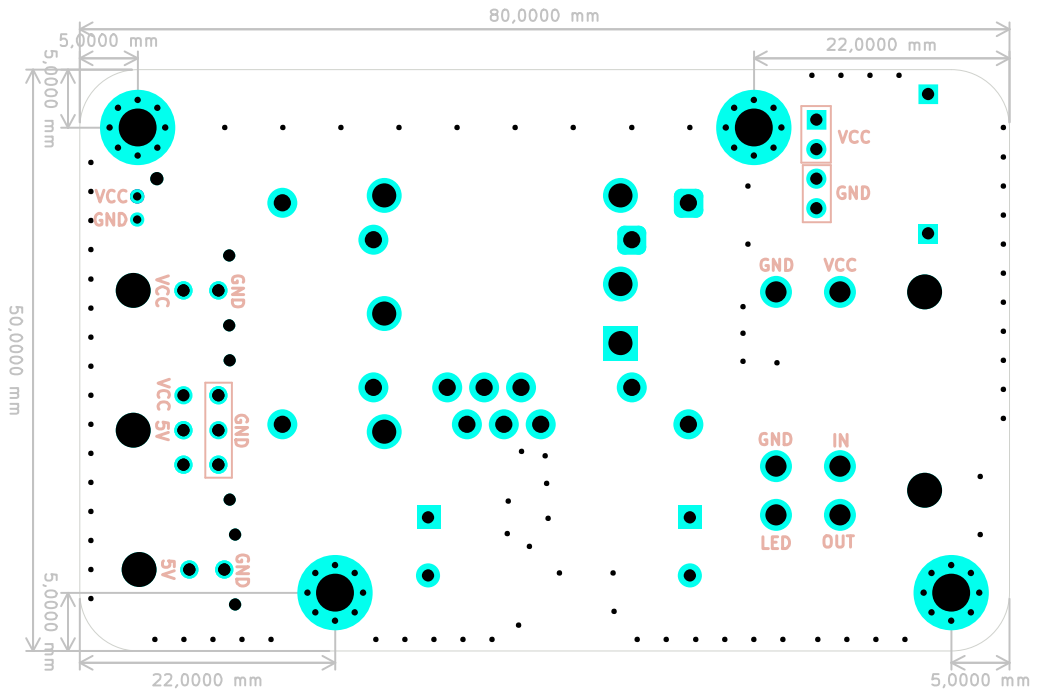
[picture p41: page 1]
