evolutek/carte-alim/Mini carte alim V1/Output/Board-Front.pdf

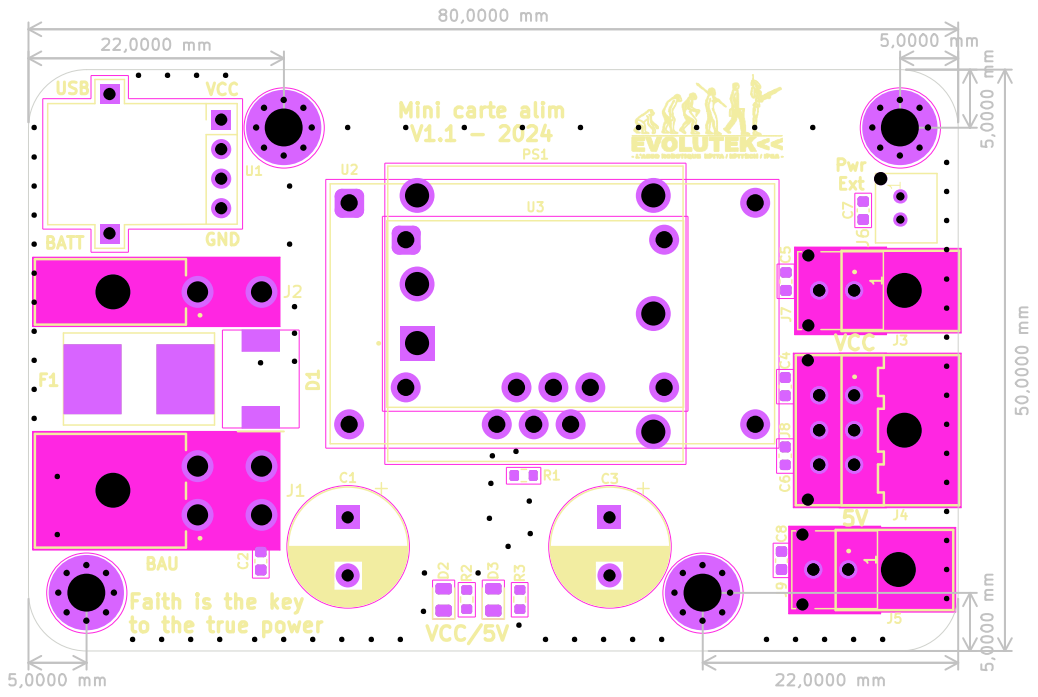
[picture p42: page 1]
