evolutek/carte-alim/Carte Boitier BAU/Output/Board-Back.pdf

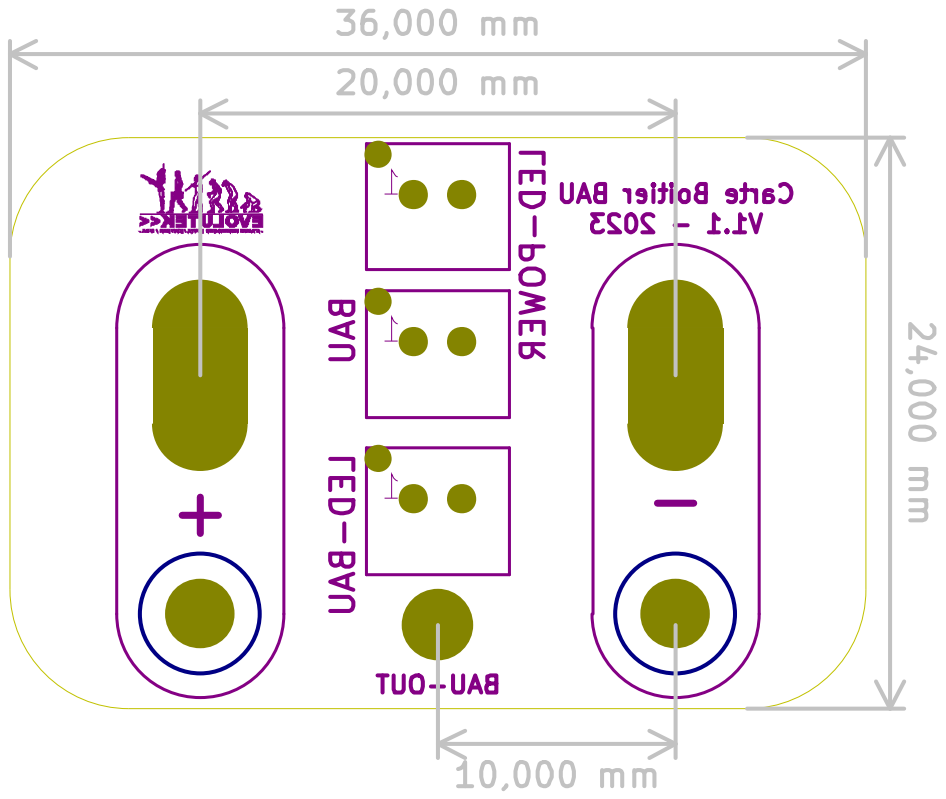
[picture p43: page 1]
