evolutek/carte-alim/Carte Boitier BAU/Output/Board-Front.pdf

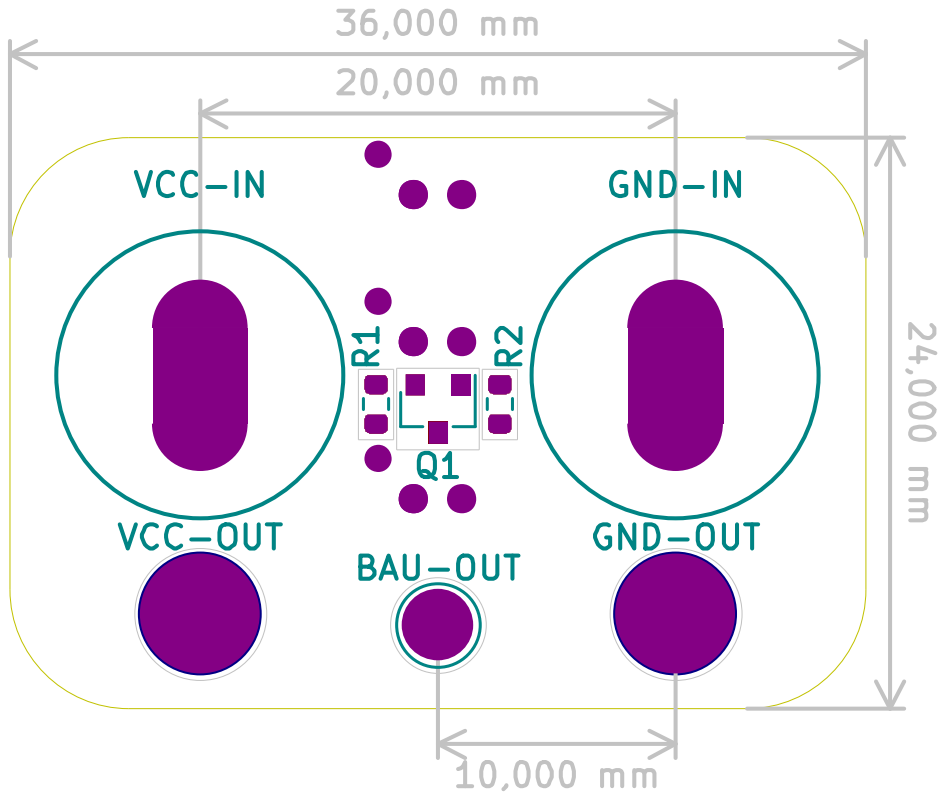
[picture p44: page 1]
