evolutek/carte-alim/V4/Output/Board-Back.pdf

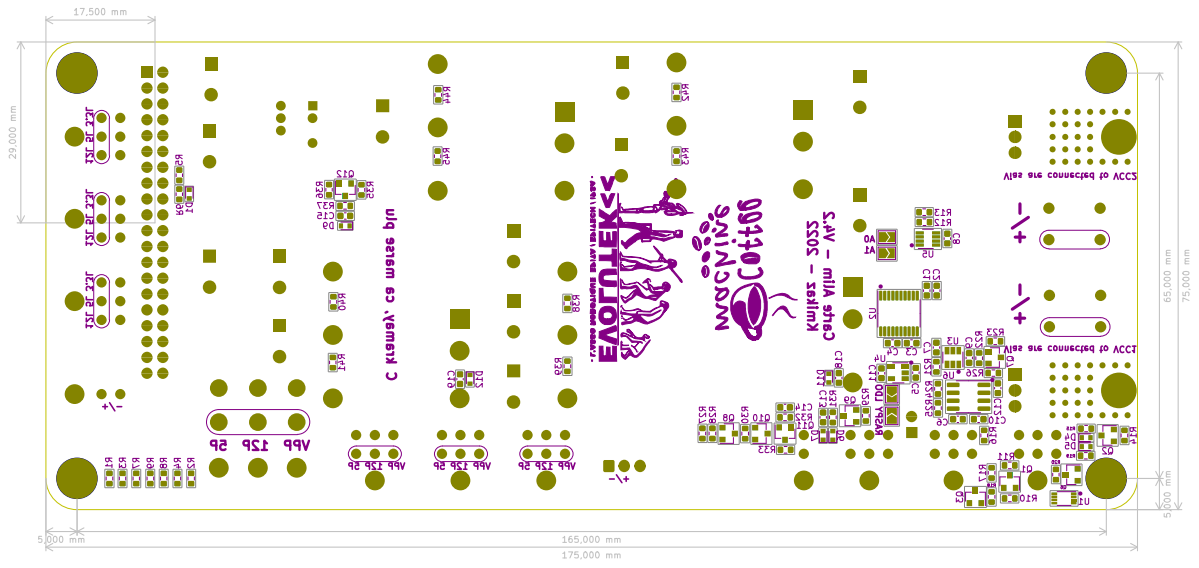
[picture p45: page 1]
