evolutek/carte-alim/V4/Output/Board-Front.pdf

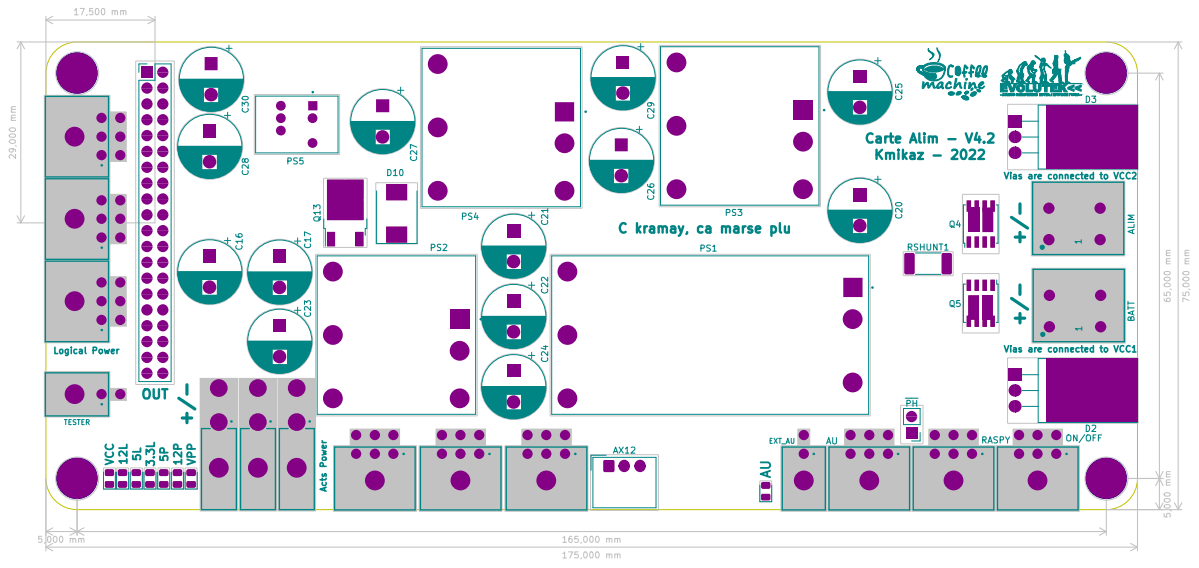
[picture p46: page 1]
