evolutek/carte-alim/(list of files, drawings)

Other design files:
V3/Board.PcbDoc
V3/EvoFootprints.PcbLib
V3/EvoPowerMain.PrjPCB
V3/EvoSchematic.SchLib
V3/RegPowerFootprint.PcbLib
V3/schemaPower.SchDoc
