evolutek/carte-alim/Micro carte alim V1/Micro Carte Alim V1.kicad_pcb

## KiCad design Micro carte alim V1/Micro Carte Alim V1.kicad_pcb (2025-05-21)

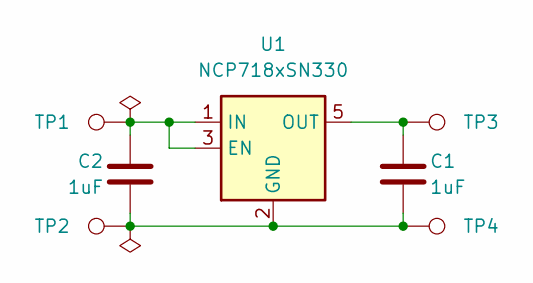
[picture p47: schematic Micro Carte Alim V1.kicad_sch, Micro Carte ALim]

Parts:
C1, C2: 1uF; C_0603_1608Metric
TP1, TP2, TP3, TP4: TestPoint; TestPoint_Keystone_5019_Minature
U1: NCP718xSN330; SOT-23-5

Connections:
unnamed: C2.1, TP1.1, U1.1 (IN), U1.3 (EN)
unnamed: C1.2, C2.2, TP2.1, TP4.1, U1.2 (GND)
unnamed: C1.1, TP3.1, U1.5 (OUT)

Board: 2 copper layers, 7 parts (4 on the bottom side), 3 nets, no tracks yet.
