evolutek/carte-alim/Mini carte AU V1/min-carte-au.kicad_pcb

## KiCad design Mini carte AU V1/min-carte-au.kicad_pcb (2025-04-14)

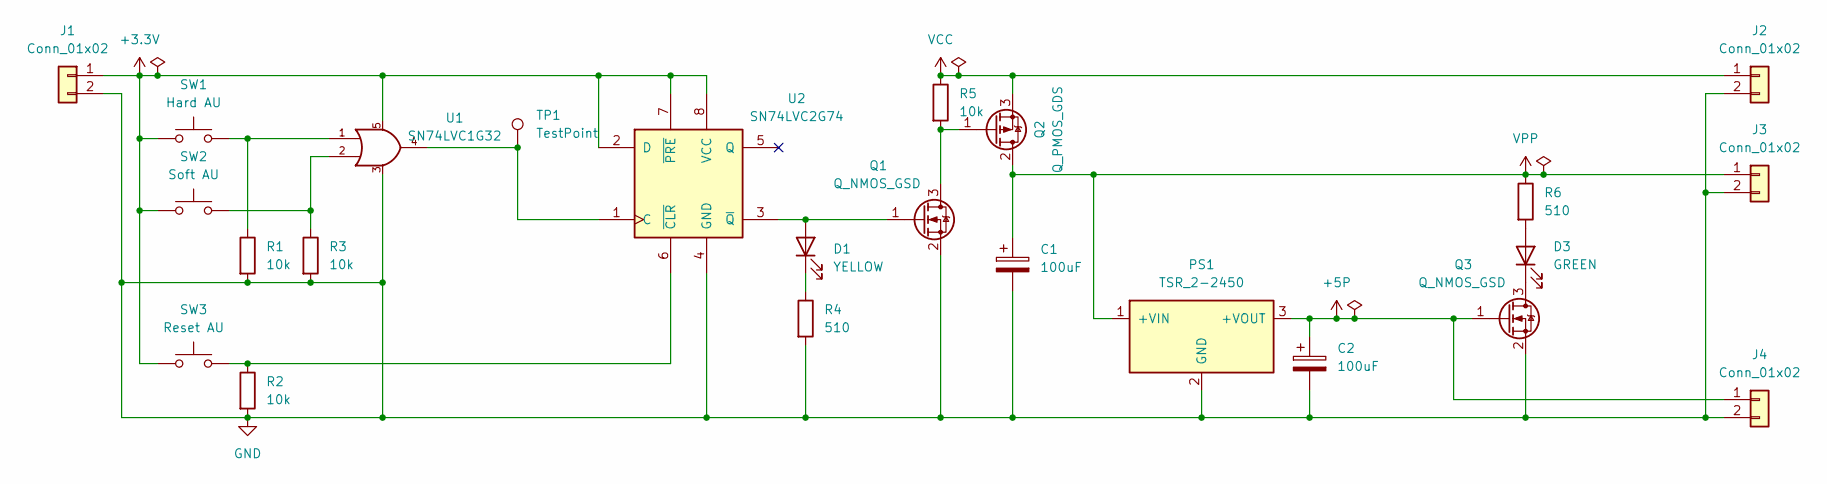
[picture p48: schematic min-carte-au.kicad_sch, Mini Carte AU]

Parts:
C1, C2: 100uF; CP_Elec_6.3x7.7
D1: YELLOW; LED_0805_2012Metric
D3: GREEN; WL-SMTW_3020
J1, J2, J3, J4: Conn_01x02; PinHeader_1x02_P2.54mm_Vertical
PS1: TSR_2-2450
Q1, Q3: Q_NMOS_GSD; SOT-23
Q2: Q_PMOS_GDS; SOT-223-3_TabPin2
R1, R2, R3, R5: 10k; R_0603_1608Metric
R4, R6: 510; R_0603_1608Metric
SW1: Hard AU; SW_Gateron_LowProfile_THT
SW2: Soft AU; SW_PUSH_6mm
SW3: Reset AU; SW_PUSH_6mm
TP1: TestPoint; TestPoint_Pad_D2.0mm
U1: SN74LVC1G32; SOT-23-5
U2: SN74LVC2G74; VSSOP-8_2.3x2mm_P0.5mm

Connections:
+3.3V: J1.1, SW1.1, SW2.1, SW3.1, U1.5 (VCC), U2.2 (D), U2.7 (~PRE), U2.8 (VCC)
+5P: C2.1, J4.1, PS1.3 (+VOUT), Q3.1 (G)
GND: C1.2, C2.2, J1.2, J2.2, J3.2, J4.2, PS1.2 (GND), Q1.2 (S), Q3.2 (S), R1.2, R2.2, R3.2, R4.2, U1.3 (GND), U2.4 (GND)
unnamed: D1.2 (A), Q1.1 (G), U2.3 (~Q)
unnamed: D1.1 (K), R4.1
unnamed: D3.2 (A), R6.2
unnamed: D3.1 (K), Q3.3 (D)
unnamed: Q1.3 (D), Q2.1 (G), R5.2
unnamed: R1.1, SW1.2, U1.1 (A)
unnamed: R3.1, SW2.2, U1.2 (B)
unnamed: TP1.1, U1.4 (S), U2.1 (C)
unnamed: R2.1, SW3.2, U2.6 (~CLR)
VCC: J2.1, Q2.3 (S), R5.1
VPP: C1.1, J3.1, PS1.1 (+VIN), Q2.2 (D), R6.1

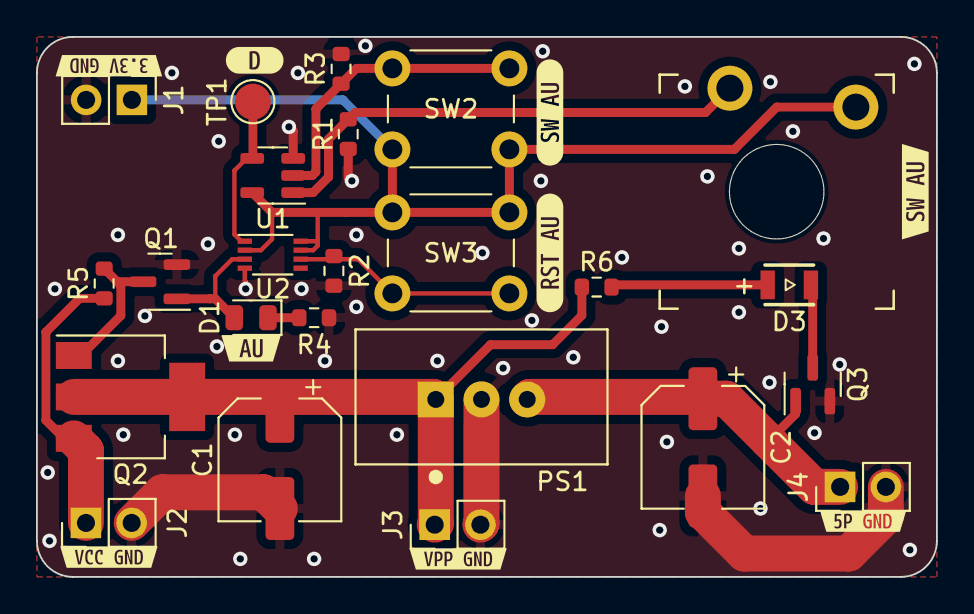
[picture p49: board min-carte-au.kicad_pcb from above]

Board: 2 copper layers, 50.0 x 30.0 mm, 33 parts (0 on the bottom side), 14 nets.

Other parts of the board:
kibuzzard-67BF20D4: G***; kibuzzard-67BF20D4
kibuzzard-67BF20EF: G***; kibuzzard-67BF20EF
kibuzzard-67BF21E9: G***; kibuzzard-67BF21E9
kibuzzard-67BF210C: G***; kibuzzard-67BF210C
kibuzzard-67BF216A: G***; kibuzzard-67BF216A
kibuzzard-67BF225B: G***; kibuzzard-67BF225B
kibuzzard-67BF2193: G***; kibuzzard-67BF2193
kibuzzard-67C03801: G***; kibuzzard-67C03801
kibuzzard-67FD2C7C: G***; kibuzzard-67FD2C7C
