evolutek/carte-alim/Carte Dock LP-E10/carte-dock-lp-e10.kicad_pcb

## KiCad design Carte Dock LP-E10/carte-dock-lp-e10.kicad_pcb (2025-04-11)

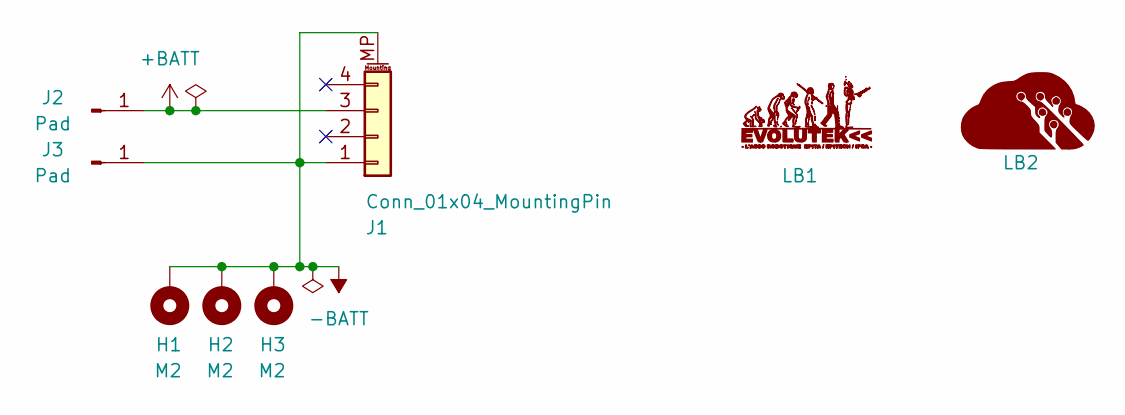
[picture p50: schematic carte-dock-lp-e10.kicad_sch, Carte dock LP-E10]

Parts:
H1, H2, H3: M2; MountingHole_2.2mm_M2_Pad_Via
J1: Conn_01x04_MountingPin; 18K314305
J2, J3: Pad; Pad 4x2mm
LB1: LOGO; logo-evo-micro
LB2: LOGO; Logo Aisler Micro

Connections:
+BATT: J1.3, J2.1
-BATT: H1.1, H2.1, H3.1, J1.1, J1.MP (MountPin), J3.1

Board: 2 copper layers, 10 parts (6 on the bottom side), 2 nets, no tracks yet.

Other parts of the board:
kibuzzard-67C63C0E: G***; kibuzzard-67C63C0E
kibuzzard-67C63C1C: G***; kibuzzard-67C63C1C
