evolutek/carte-alim/V5/Carte Alim.kicad_pcb

## KiCad design V5/Carte Alim.kicad_pcb (2025-04-11)

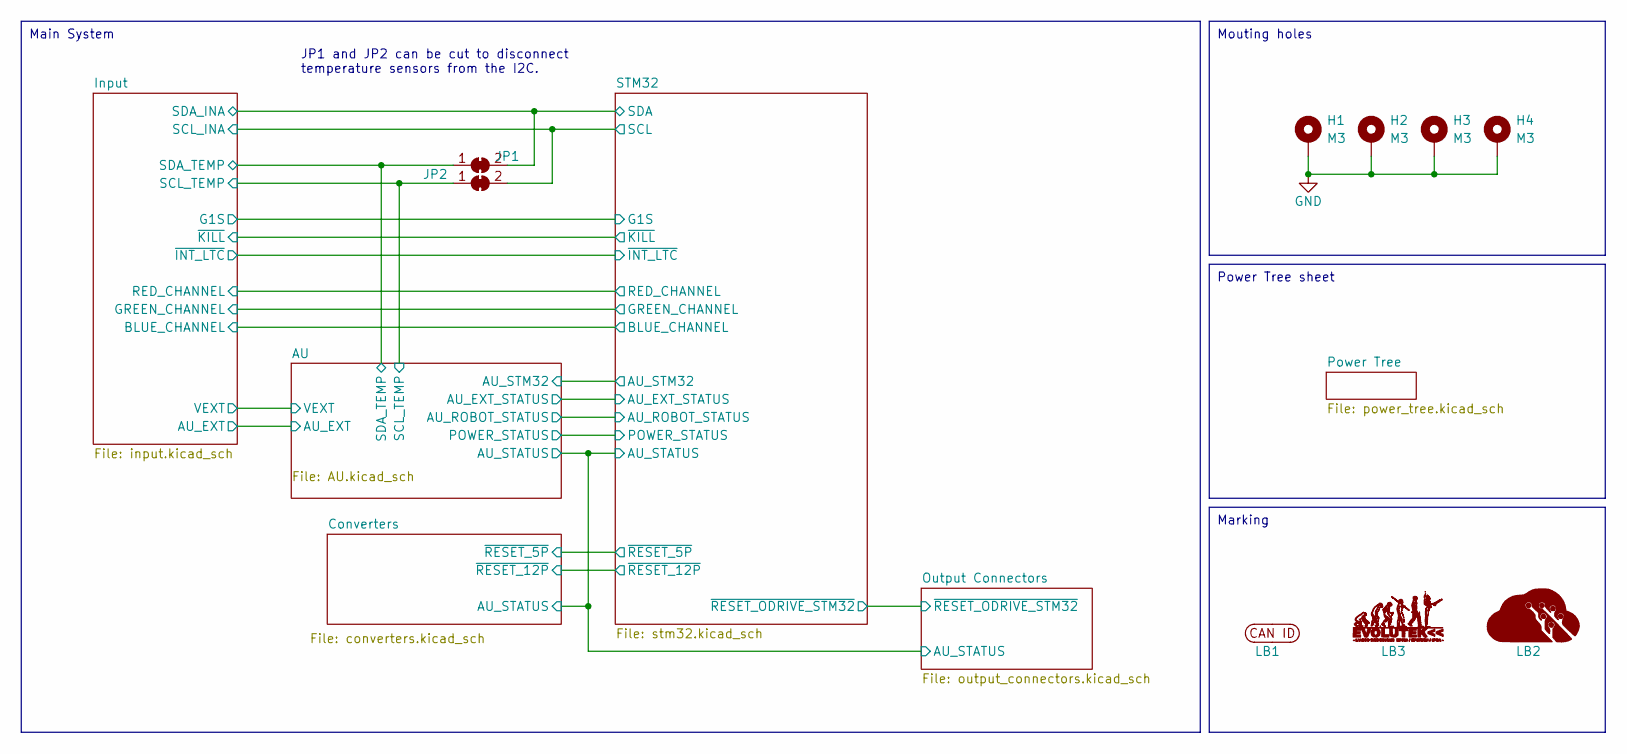
[picture p51: schematic Carte Alim.kicad_sch]

Parts:
H1, H2, H3, H4: M3; WA-SMSI_9774110360
JP1, JP2: SolderJumper_2_Bridged; SolderJumper-2_P1.3mm_Bridged_RoundedPad1.0x1.5mm
LB1: CAN ID Label 2
LB2: LOGO; Logo Aisler Min
LB3: LOGO; logo-evo-min

Connections:
/AU/SCL_TEMP: JP2.1 (A); also elsewhere on the board
/AU/SDA_TEMP: JP1.1 (A); also elsewhere on the board
/Input/SCL_INA: JP2.2 (B); also elsewhere on the board
/Input/SDA_INA: JP1.2 (B); also elsewhere on the board
GND: H1.1, H2.1, H3.1, H4.1; also elsewhere on the board

Notes on the sheet:
Power Tree sheet
Marking
Mouting holes
Main System
JP1 and JP2 can be cut to disconnect temperature sensors from the I2C.

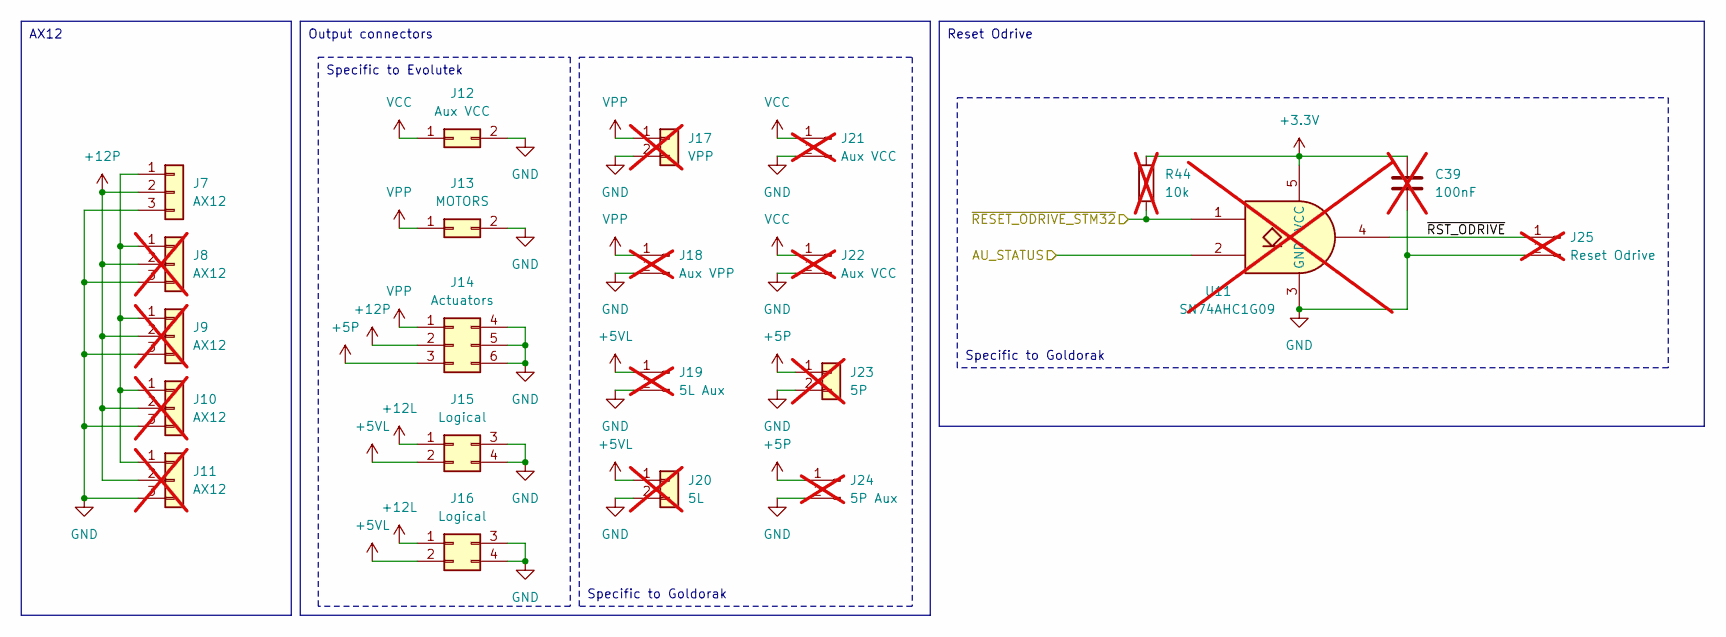
[picture p52: schematic output_connectors.kicad_sch, Carte Alim]

Parts:
C39: 100nF; C_0603_1608Metric; not fitted
J7: AX12; 22-03-5035
J8, J9, J10, J11: AX12; 22-03-5035; not fitted
J12: Aux VCC; 66200221022
J13: MOTORS; 649002227222-with-larger-pads
J14: Actuators; 649006227222-with-larger-pads
J15, J16: Logical; 66200421022
J17: VPP; 691321100002; not fitted
J18: Aux VPP; PinHeader_1x02_P2.54mm_Vertical; not fitted
J19: 5L Aux; PinHeader_1x02_P2.54mm_Vertical; not fitted
J20: 5L; 691321100002; not fitted
J21, J22: Aux VCC; PinHeader_1x02_P2.54mm_Vertical; not fitted
J23: 5P; 691321100002; not fitted
J24: 5P Aux; PinHeader_1x02_P2.54mm_Vertical; not fitted
J25: Reset Odrive; PinHeader_1x02_P2.54mm_Vertical; not fitted
R44: 10k; R_0603_1608Metric; not fitted
U11: SN74AHC1G09; SC70-5; not fitted

Connections:
+3.3V: C39.1, R44.1, U11.5 (VCC); also elsewhere on the board
+5P: J14.3, J23.1, J24.1; also elsewhere on the board
+5VL: J15.2, J16.2, J19.1, J20.1; also elsewhere on the board
+12L: J15.1, J16.1; also elsewhere on the board
+12P: J7.2, J8.2, J9.2, J10.2, J11.2, J14.2; also elsewhere on the board
/AU/AU_STATUS: U11.2; also elsewhere on the board
/Output Connectors/~RESET_ODRIVE_STM32: R44.2, U11.1; also elsewhere on the board
/Output Connectors/~RST_ODRIVE: J25.1, U11.4
GND: C39.2, J7.3, J8.3, J9.3, J10.3, J11.3, J12.2, J13.2, J14.4, J14.5, J14.6, J15.3, J15.4, J16.3, J16.4, J17.2, J18.2, J19.2, J20.2, J21.2, J22.2, J23.2, J24.2, J25.2, U11.3 (GND); also elsewhere on the board
unnamed: J7.1, J8.1, J9.1, J10.1, J11.1
VCC: J12.1, J21.1, J22.1; also elsewhere on the board
VPP: J13.1, J14.1, J17.1, J18.1; also elsewhere on the board

Notes on the sheet:
AX12
Specific to Evolutek
Output connectors
Specific to Goldorak
Reset Odrive

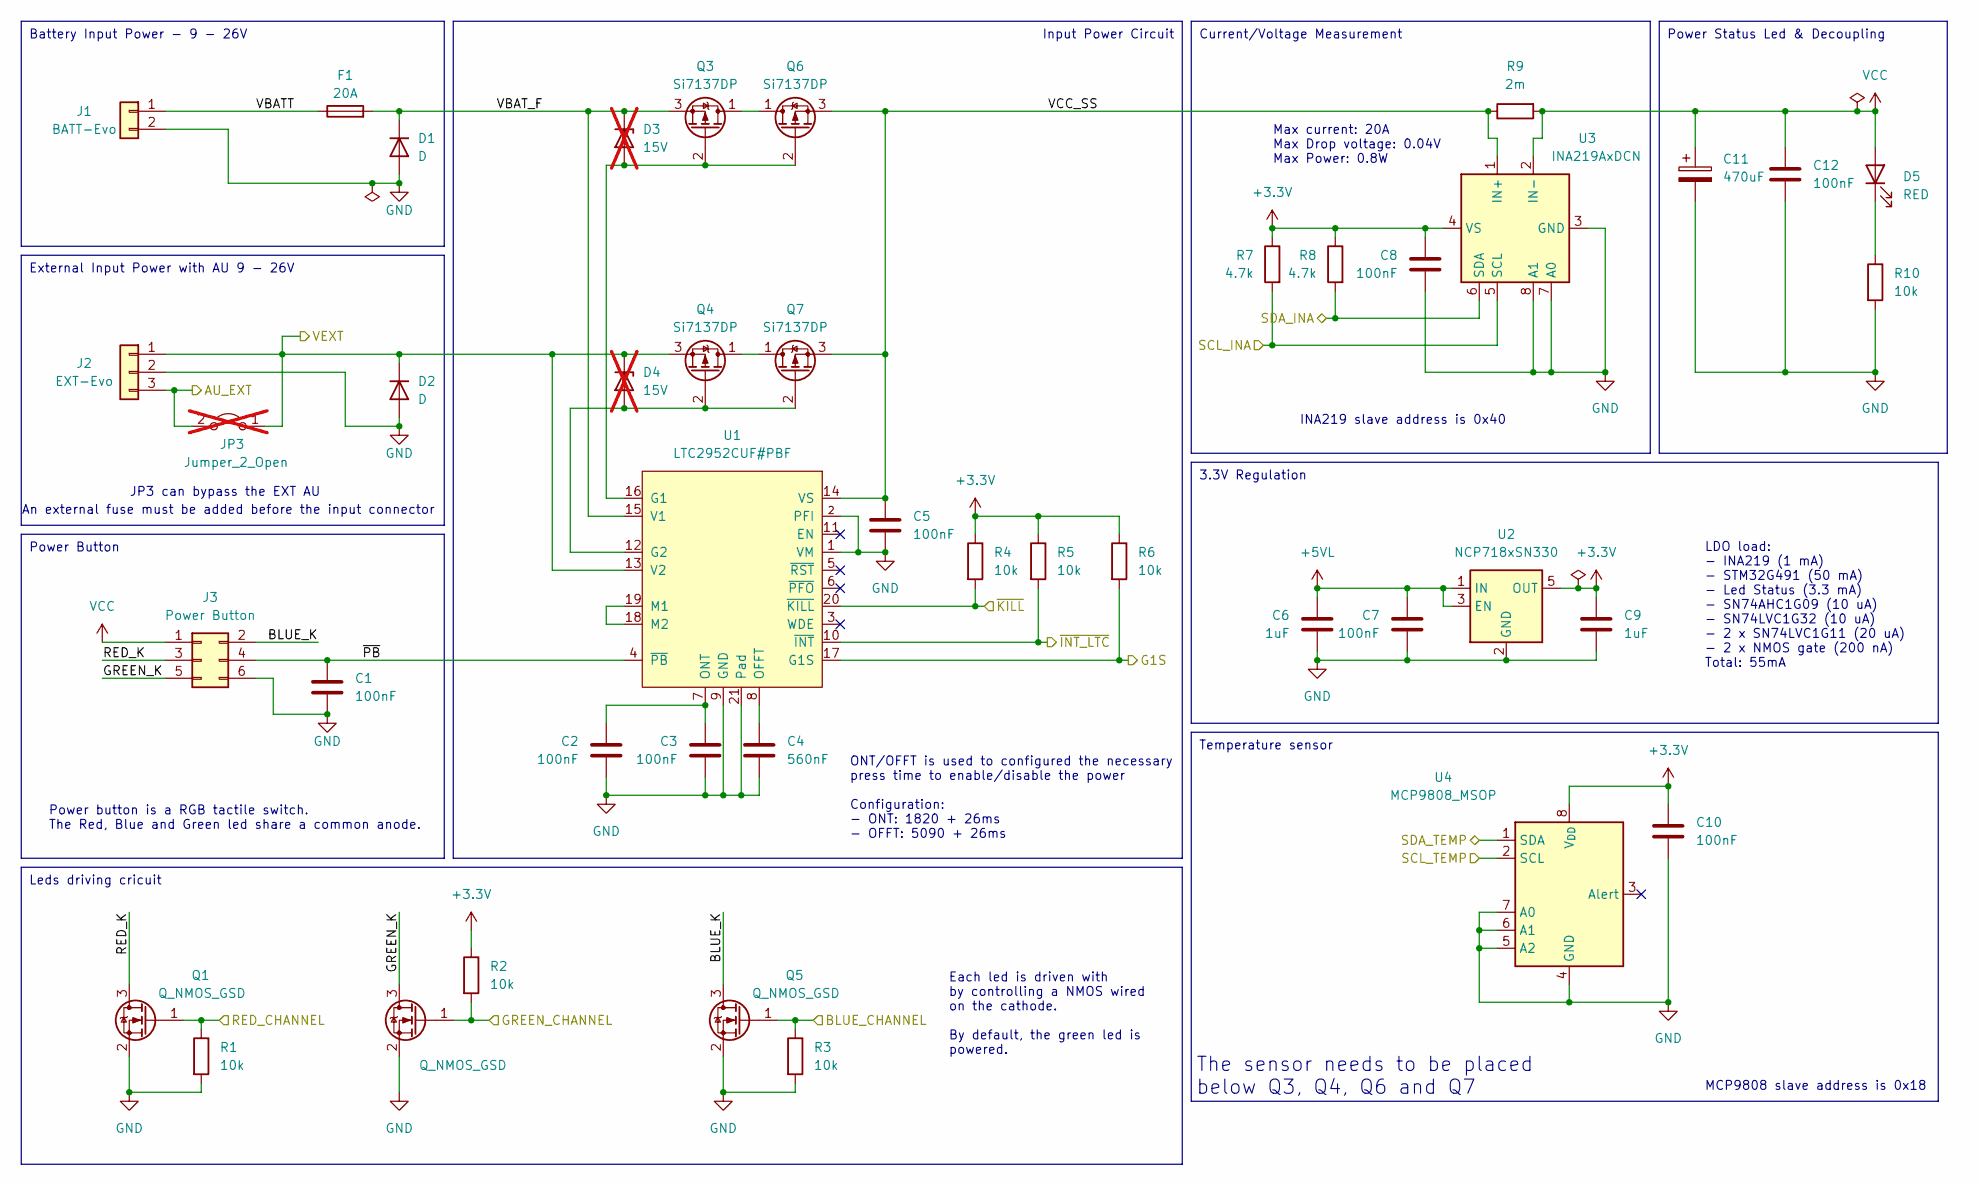
[picture p53: schematic input.kicad_sch, Carte Alim]

Parts:
C1, C2, C3, C5, C7, C8, C10, C12: 100nF; C_0603_1608Metric
C4: 560nF; C_0603_1608Metric
C6, C9: 1uF; C_0603_1608Metric
C11: 470uF; CP_Radial_D10.0mm_P5.00mm
D1, D2: D; DO-214AB
D3, D4: 15V; D_SOD-523; not fitted
D5: RED; LED_0805_2012Metric
F1: 20A; FUSE_3557-2
J1: BATT-Evo; 657002140101
J2: EXT-Evo; 657003140101
J3: Power Button; 690367280676
JP3: Jumper_2_Open; PinHeader_1x02_P2.54mm_Horizontal; not fitted
Q1, Q2, Q5: Q_NMOS_GSD; SOT-23
Q3, Q4, Q6, Q7: Si7137DP; PowerPak-SO8_5.15x6.15mm_Pitch1.27mm
R1, R2, R3, R4, R5, R6, R10: 10k; R_0603_1608Metric
R7, R8: 4.7k; R_0603_1608Metric
R9: 2m; R_2512_6332Metric
U1: LTC2952CUF#PBF; QFN-20-1EP_4x4mm_P0.5mm_EP2.5x2.5mm
U2: NCP718xSN330; SOT-23-5
U3: INA219AxDCN; SOT-23-8
U4: MCP9808_MSOP; MSOP-8_3x3mm_P0.65mm

Connections:
+3.3V: C8.1, C9.1, C10.1, R2.1, R4.1, R5.1, R6.1, R7.1, R8.1, U2.5 (OUT), U3.4 (VS), U4.8 (V_{DD}); also elsewhere on the board
+5VL: C6.1, C7.1, U2.1 (IN), U2.3 (EN); also elsewhere on the board
/AU/AU_EXT: J2.3, JP3.2 (B); also elsewhere on the board
/AU/SCL_TEMP: U4.2 (SCL); also elsewhere on the board
/AU/SDA_TEMP: U4.1 (SDA); also elsewhere on the board
/AU/VEXT: D2.1 (K), D4.1 (K), J2.1, JP3.1 (A), Q4.3 (S), U1.13 (V2); also elsewhere on the board
/Input/BLUE_CHANNEL: Q5.1 (G), R3.1; also elsewhere on the board
/Input/BLUE_K: J3.2, Q5.3 (D)
/Input/G1S: R6.2, U1.17 (G1S); also elsewhere on the board
/Input/GREEN_CHANNEL: Q2.1 (G), R2.2; also elsewhere on the board
/Input/GREEN_K: J3.5, Q2.3 (D)
/Input/RED_CHANNEL: Q1.1 (G), R1.1; also elsewhere on the board
/Input/RED_K: J3.3, Q1.3 (D)
/Input/SCL_INA: R7.2, U3.5 (SCL); also elsewhere on the board
/Input/SDA_INA: R8.2, U3.6 (SDA); also elsewhere on the board
/Input/VBATT: F1.1, J1.1
/Input/VBAT_F: D1.1 (K), D3.1 (K), F1.2, Q3.3 (S), U1.15 (V1)
/Input/VCC_SS: C5.1, Q6.3 (S), Q7.3 (S), R9.1, U1.14 (VS), U3.1 (IN+)
/Input/~INT_LTC: R5.2, U1.10 (~INT); also elsewhere on the board
/Input/~KILL: R4.2, U1.20 (~KILL); also elsewhere on the board
/Input/~PB: C1.1, J3.4, U1.4 (~PB)
GND: C1.2, C2.2, C3.2, C4.2, C5.2, C6.2, C7.2, C8.2, C9.2, C10.2, C11.2, C12.2, D1.2 (A), D2.2 (A), J1.2, J2.2, J3.6, Q1.2 (S), Q2.2 (S), Q5.2 (S), R1.2, R3.2, R10.2, U1.1 (VM), U1.2 (PFI), U1.9 (GND), U1.21 (Pad), U2.2 (GND), U3.3 (GND), U3.7 (A0), U3.8 (A1), U4.4 (GND), U4.5 (A2), U4.6 (A1), U4.7 (A0); also elsewhere on the board
unnamed: D3.2 (A), Q3.2 (G), Q6.2 (G), U1.16 (G1)
unnamed: D4.2 (A), Q4.2 (G), Q7.2 (G), U1.12 (G2)
unnamed: D5.1 (K), R10.1
unnamed: Q3.1 (D), Q6.1 (D)
unnamed: Q4.1 (D), Q7.1 (D)
unnamed: U1.18 (M2), U1.19 (M1)
unnamed: C4.1, U1.8 (OFFT)
unnamed: C2.1, C3.1, U1.7 (ONT)
VCC: C11.1, C12.1, D5.2 (A), J3.1, R9.2, U3.2 (IN-); also elsewhere on the board

Notes on the sheet:
Temperature sensor
Power Button
Current/Voltage Measurement
External Input Power with AU 9 - 26V
Input Power Circuit
3.3V Regulation
Power Status Led & Decoupling
Battery Input Power - 9 - 26V
Leds driving cricuit
An external fuse must be added before the input connector
INA219 slave address is 0x40
The sensor needs to be placed below Q3, Q4, Q6 and Q7
Each led is driven with by controlling a NMOS wired on the cathode. By default, the green led is powered.
JP3 can bypass the EXT AU
ONT/OFFT is used to configured the necessary press time to enable/disable the power Configuration: - ONT: 1820 + 26ms - OFFT: 5090 + 26ms
Power button is a RGB tactile switch. The Red, Blue and Green led share a common anode.
MCP9808 slave address is 0x18
Max current: 20A Max Drop voltage: 0.04V Max Power: 0.8W
LDO load: - INA219 (1 mA) - STM32G491 (50 mA) - Led Status (3.3 mA) - SN74AHC1G09 (10 uA) - SN74LVC1G32 (10 uA) - 2 x SN74LVC1G11 (20 uA) - 2 x NMOS gate (200 nA) Total: 55mA

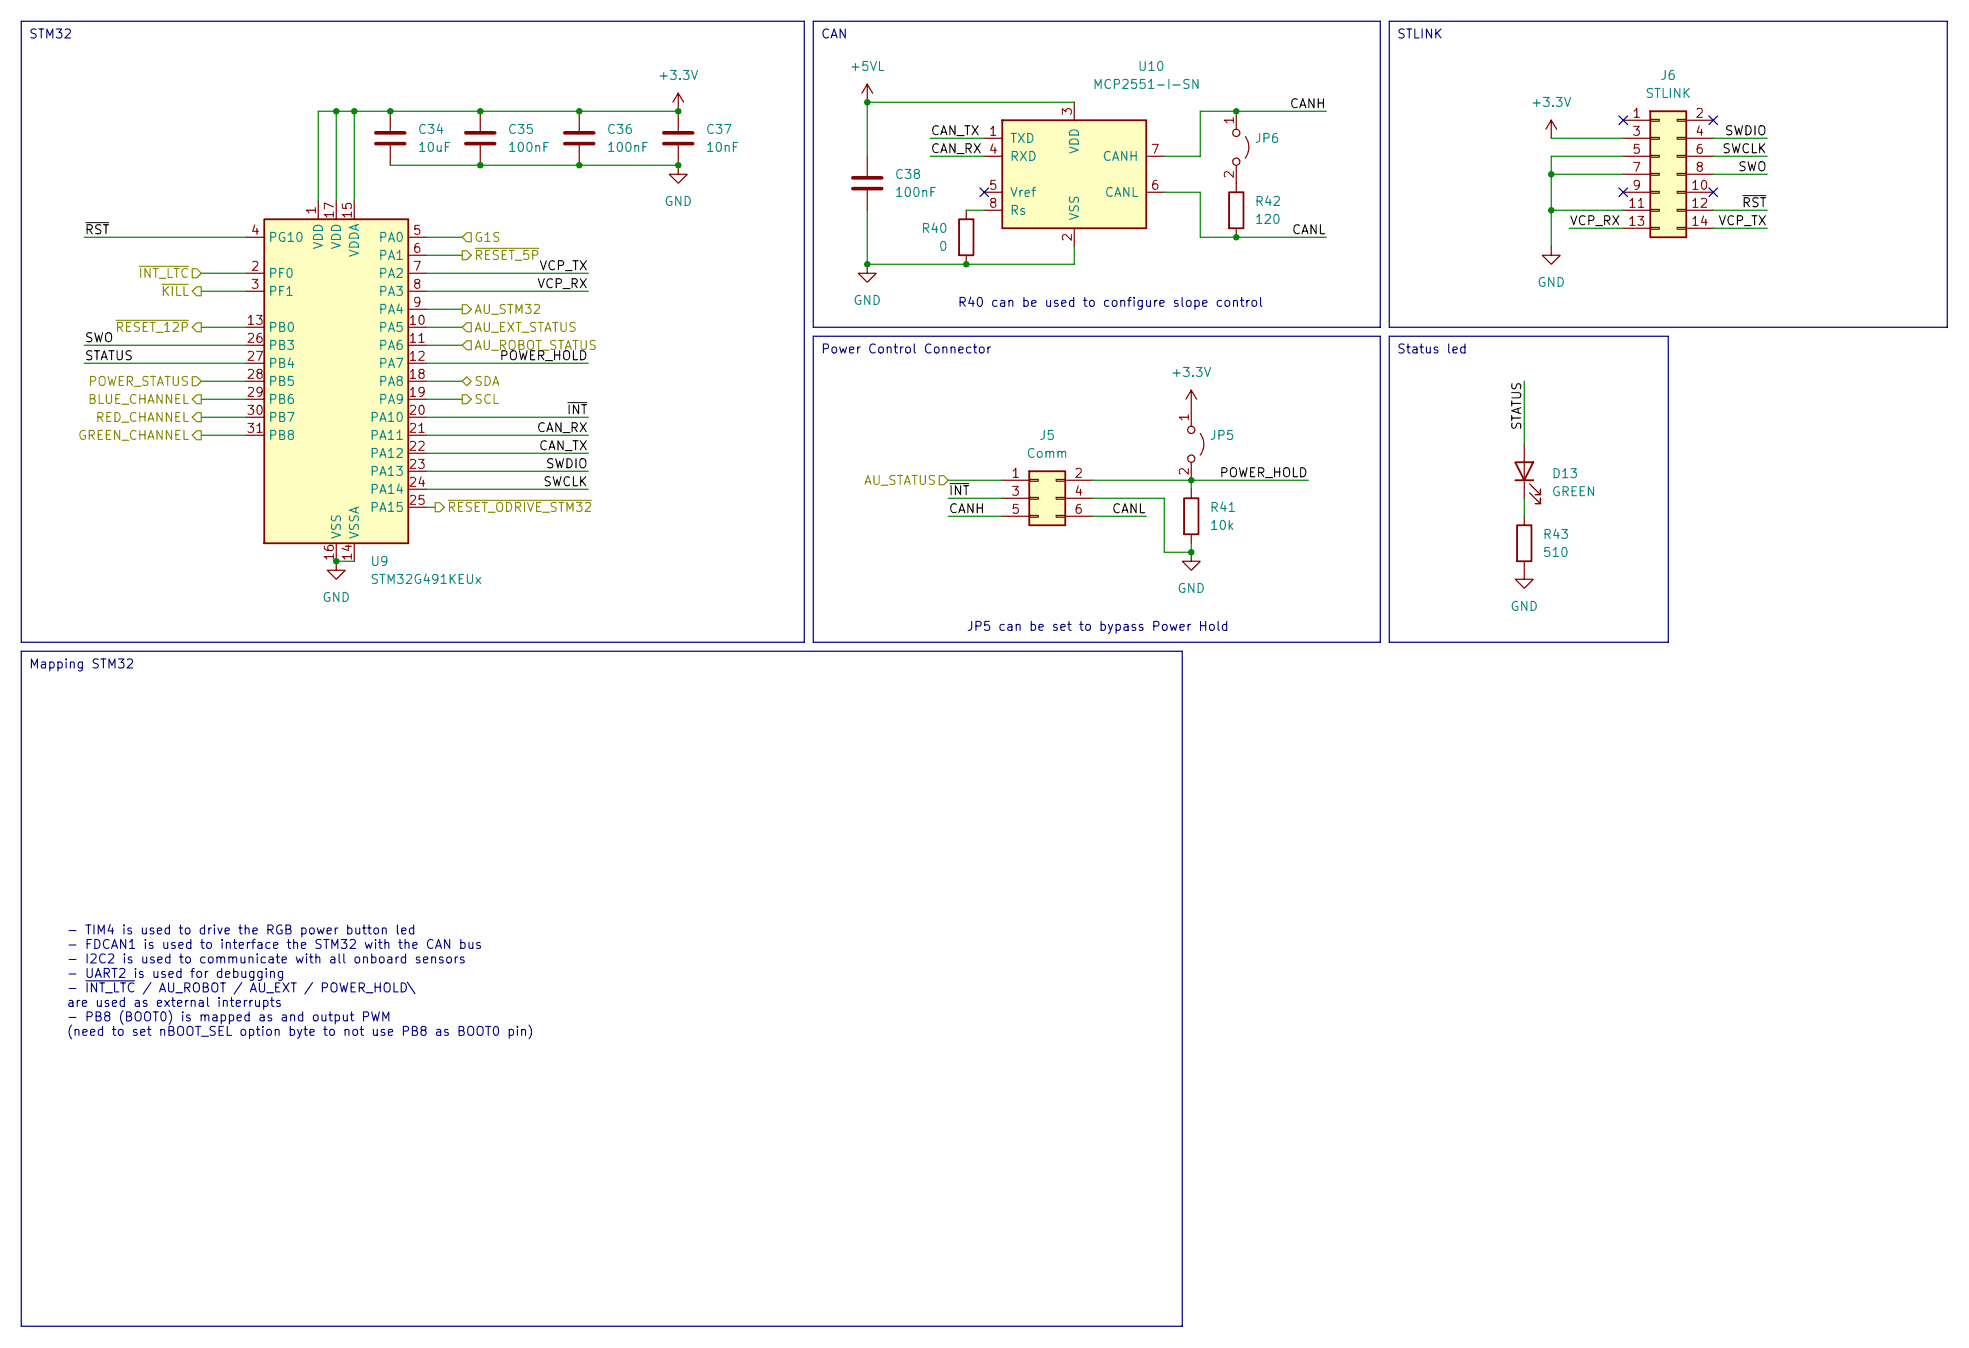
[picture p54: schematic stm32.kicad_sch, Carte Alim]

Parts:
C34: 10uF; C_0603_1608Metric
C35, C36, C38: 100nF; C_0603_1608Metric
C37: 10nF; C_0603_1608Metric
D13: GREEN; LED_0805_2012Metric
J5: Comm; 690367280676
J6: STLINK; 62701420621
JP5, JP6: Jumper_2_Open; PinHeader_1x02_P2.54mm_Vertical
R40: 0; R_0603_1608Metric
R41: 10k; R_0603_1608Metric
R42: 120; R_0603_1608Metric
R43: 510; R_0603_1608Metric
U9: STM32G491KEUx; QFN-32-1EP_5x5mm_P0.5mm_EP3.45x3.45mm-Without thermal pad
U10: MCP2551-I-SN; SOIC-8_3.9x4.9mm_P1.27mm

Connections:
+3.3V: C34.1, C35.1, C36.1, C37.1, J6.3, JP5.1 (A), U9.1 (VDD), U9.15 (VDDA), U9.17 (VDD); also elsewhere on the board
+5VL: C38.1, U10.3 (VDD); also elsewhere on the board
/AU/AU_EXT_STATUS: U9.10 (PA5); also elsewhere on the board
/AU/AU_ROBOT: U9.11 (PA6); also elsewhere on the board
/AU/AU_STATUS: J5.1; also elsewhere on the board
/AU/AU_STM32: U9.9 (PA4); also elsewhere on the board
/AU/POWER_STATUS: U9.28 (PB5); also elsewhere on the board
/Converters/~RESET_5P: U9.6 (PA1); also elsewhere on the board
/Converters/~RESET_12P: U9.13 (PB0); also elsewhere on the board
/Input/BLUE_CHANNEL: U9.29 (PB6); also elsewhere on the board
/Input/G1S: U9.5 (PA0); also elsewhere on the board
/Input/GREEN_CHANNEL: U9.31 (PB8); also elsewhere on the board
/Input/RED_CHANNEL: U9.30 (PB7); also elsewhere on the board
/Input/SCL_INA: U9.19 (PA9); also elsewhere on the board
/Input/SDA_INA: U9.18 (PA8); also elsewhere on the board
/Input/~INT_LTC: U9.2 (PF0); also elsewhere on the board
/Input/~KILL: U9.3 (PF1); also elsewhere on the board
/Output Connectors/~RESET_ODRIVE_STM32: U9.25 (PA15); also elsewhere on the board
/STM32/CANH: J5.5, JP6.1 (A), U10.7 (CANH)
/STM32/CANL: J5.6, R42.2, U10.6 (CANL)
/STM32/CAN_RX: U9.21 (PA11), U10.4 (RXD)
/STM32/CAN_TX: U9.22 (PA12), U10.1 (TXD)
/STM32/POWER_HOLD: J5.2, JP5.2 (B), R41.1, U9.12 (PA7)
/STM32/STATUS: D13.2 (A), U9.27 (PB4)
/STM32/SWCLK: J6.6, U9.24 (PA14)
/STM32/SWDIO: J6.4, U9.23 (PA13)
/STM32/SWO: J6.8, U9.26 (PB3)
/STM32/VCP_RX: J6.13, U9.8 (PA3)
/STM32/VCP_TX: J6.14, U9.7 (PA2)
/STM32/~INT: J5.3, U9.20 (PA10)
/STM32/~RST: J6.12, U9.4 (PG10)
GND: C34.2, C35.2, C36.2, C37.2, C38.2, J5.4, J6.5, J6.7, J6.11, R40.2, R41.2, R43.2, U9.14 (VSSA), U9.16 (VSS), U9.32 (VSS), U10.2 (VSS); also elsewhere on the board
unnamed: D13.1 (K), R43.1
unnamed: JP6.2 (B), R42.1
unnamed: R40.1, U10.8 (Rs)

Notes on the sheet:
Mapping STM32
STLINK
Status led
STM32
Power Control Connector
CAN
R40 can be used to configure slope control
- TIM4 is used to drive the RGB power button led - FDCAN1 is used to interface the STM32 with the CAN bus - I2C2 is used to communicate with all onboard sensors - UART2 is used for debugging - ~{INT_LTC} / AU_ROBOT / AU_EXT / POWER_HOLD\ are used as external interrupts - PB8 (BOOT0) is mapped as an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
JP5 can be set to bypass Power Hold

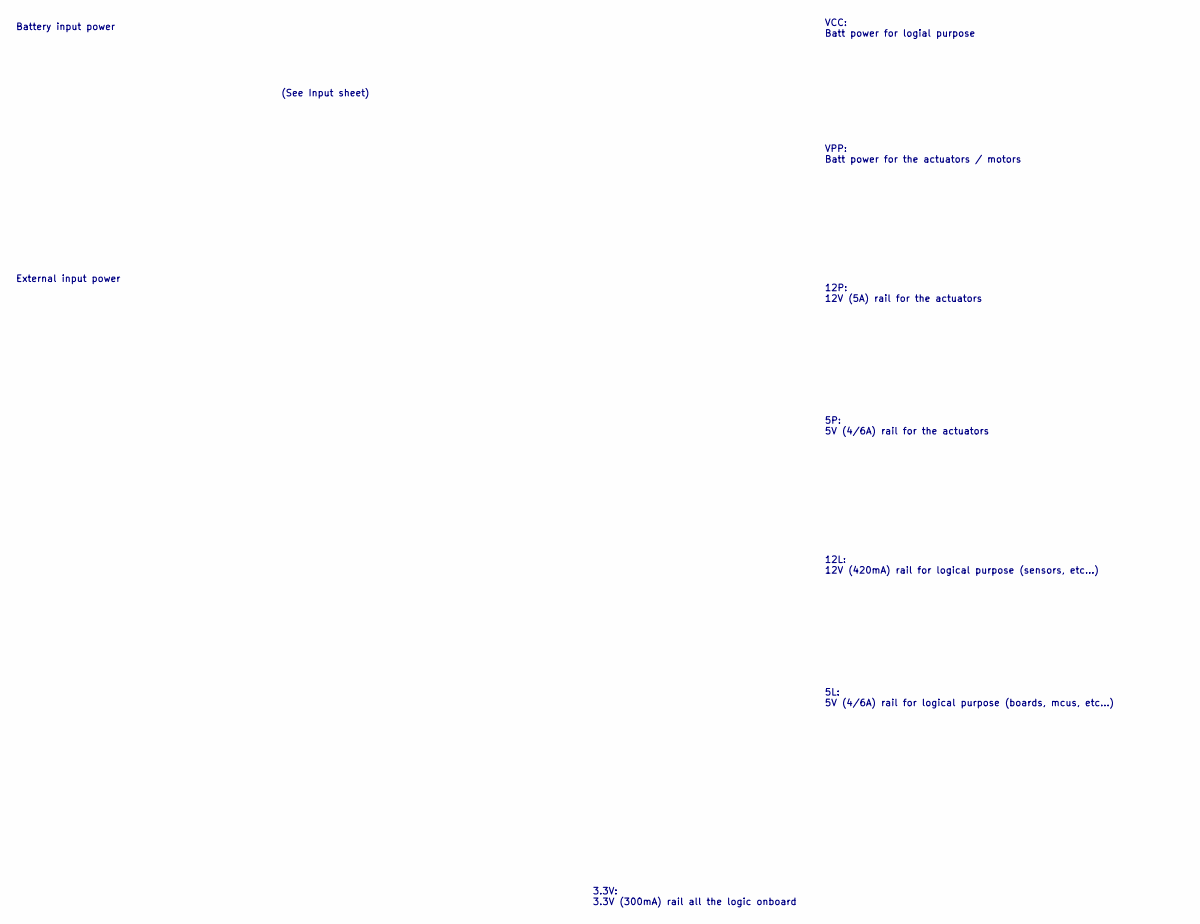
[picture p55: schematic power_tree.kicad_sch, Carte Alim]

Notes on the sheet:
12P: 12V (5A) rail for the actuators
VCC: Batt power for logial purpose
(See Input sheet)
Battery input power
External input power
VPP: Batt power for the actuators / motors
5L: 5V (4/6A) rail for logical purpose (boards, mcus, etc...)
12L: 12V (420mA) rail for logical purpose (sensors, etc...)
5P: 5V (4/6A) rail for the actuators
3.3V: 3.3V (300mA) rail all the logic onboard

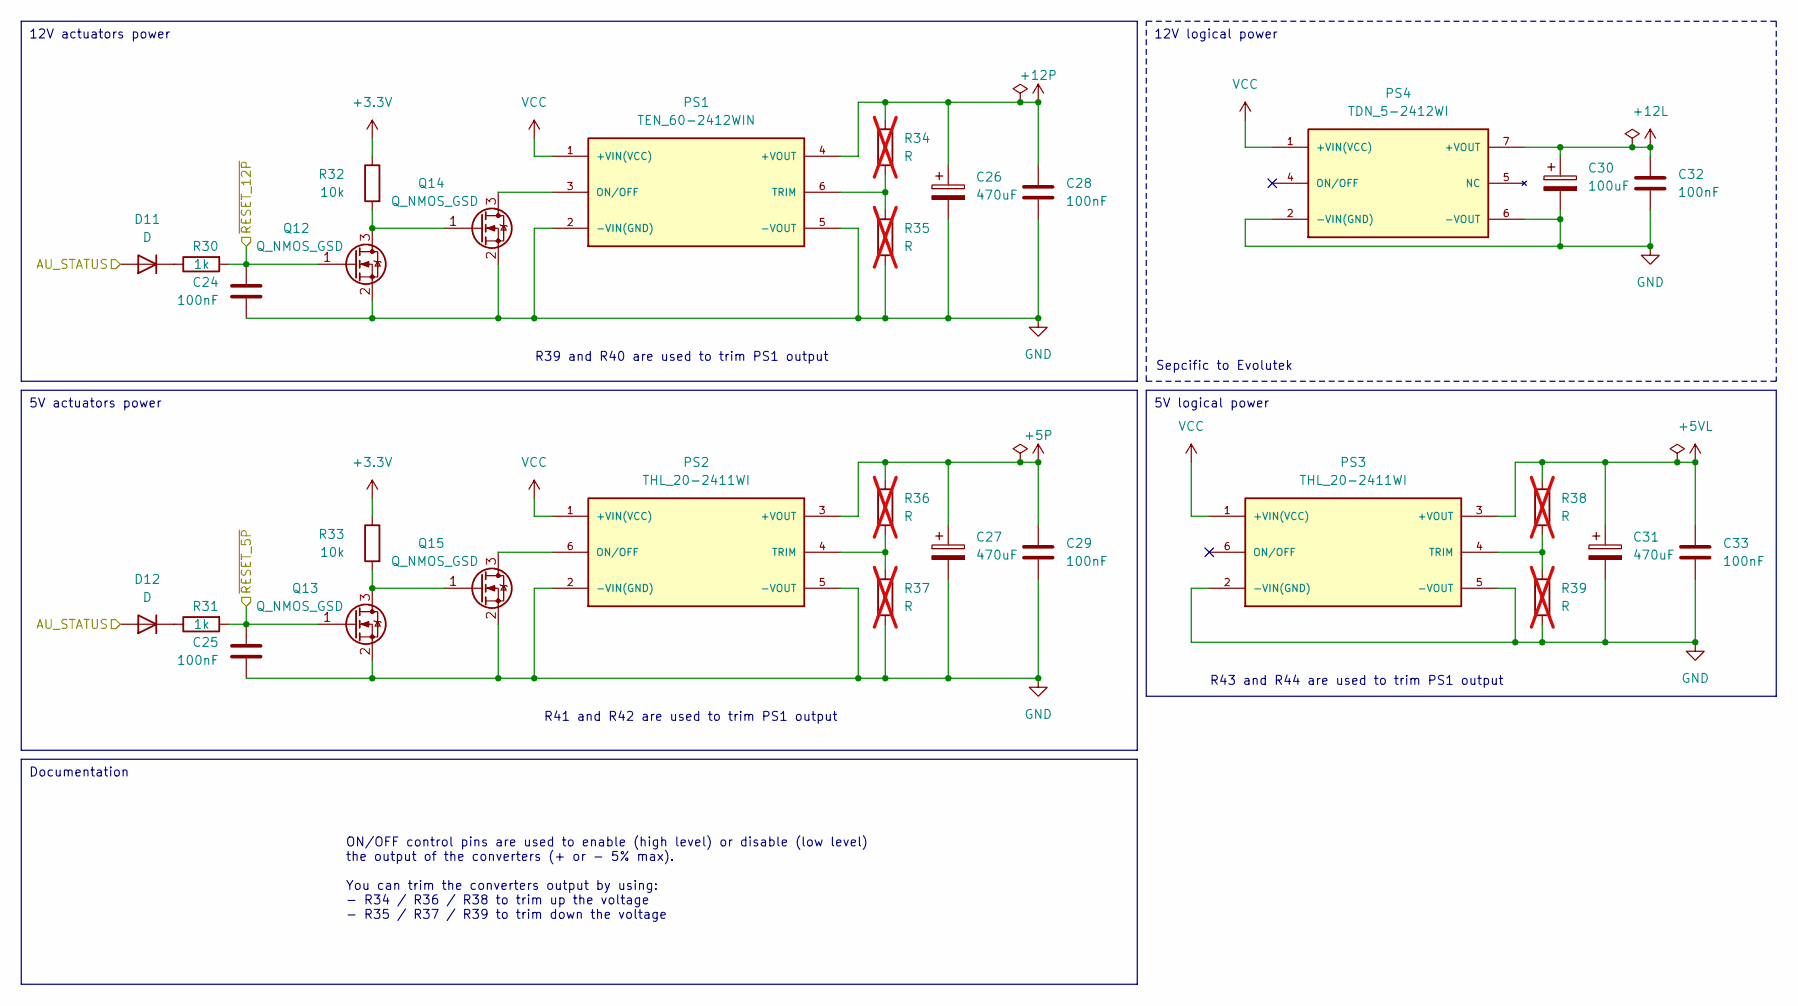
[picture p56: schematic converters.kicad_sch, Carte Alim]

Parts:
C24, C25, C28, C29, C32, C33: 100nF; C_0603_1608Metric
C26, C27, C31: 470uF; CP_Radial_D10.0mm_P5.00mm
C30: 100uF; CP_Elec_6.3x7.7
D11, D12: D; D_SOD-523
PS1: TEN_60-2412WIN; TRACO_CONV_TEN; PARTREV January 27, 2021
PS2, PS3: THL_20-2411WI; TRACO_CONV_THL; PARTREV Jan 18, 2021
PS4: TDN_5-2412WI; TRACO_CONV_TDN; PARTREV May 18, 2020
Q12, Q13, Q14, Q15: Q_NMOS_GSD; SOT-23
R30, R31: 1k; R_0603_1608Metric
R32, R33: 10k; R_0603_1608Metric
R34, R35, R36, R37, R38, R39: R; R_0603_1608Metric; not fitted

Connections:
+3.3V: R32.1, R33.1; also elsewhere on the board
+5P: C27.1, C29.1, PS2.3 (+VOUT), R36.1; also elsewhere on the board
+5VL: C31.1, C33.1, PS3.3 (+VOUT), R38.1; also elsewhere on the board
+12L: C30.1, C32.1, PS4.7 (+VOUT); also elsewhere on the board
+12P: C26.1, C28.1, PS1.4 (+VOUT), R34.1; also elsewhere on the board
/AU/AU_STATUS: D11.2 (A), D12.2 (A); also elsewhere on the board
/Converters/~RESET_5P: C25.1, Q13.1 (G), R31.2; also elsewhere on the board
/Converters/~RESET_12P: C24.1, Q12.1 (G), R30.2; also elsewhere on the board
GND: C24.2, C25.2, C26.2, C27.2, C28.2, C29.2, C30.2, C31.2, C32.2, C33.2, PS1.2 (-VIN(GND)), PS1.5 (-VOUT), PS2.2 (-VIN(GND)), PS2.5 (-VOUT), PS3.2 (-VIN(GND)), PS3.5 (-VOUT), PS4.2 (-VIN(GND)), PS4.6 (-VOUT), Q12.2 (S), Q13.2 (S), Q14.2 (S), Q15.2 (S), R35.2, R37.2, R39.2; also elsewhere on the board
unnamed: D11.1 (K), R30.1
unnamed: D12.1 (K), R31.1
unnamed: PS1.3 (ON/OFF), Q14.3 (D)
unnamed: PS1.6 (TRIM), R34.2, R35.1
unnamed: PS2.6 (ON/OFF), Q15.3 (D)
unnamed: PS2.4 (TRIM), R36.2, R37.1
unnamed: PS3.4 (TRIM), R38.2, R39.1
unnamed: Q12.3 (D), Q14.1 (G), R32.2
unnamed: Q13.3 (D), Q15.1 (G), R33.2
VCC: PS1.1 (+VIN(VCC)), PS2.1 (+VIN(VCC)), PS3.1 (+VIN(VCC)), PS4.1 (+VIN(VCC)); also elsewhere on the board

Notes on the sheet:
Documentation
12V actuators power
5V actuators power
5V logical power
12V logical power
ON/OFF control pins are used to enable (high level) or disable (low level) the output of the converters (+ or - 5% max). You can trim the converters output by using: - R34 / R36 / R38 to trim up the voltage - R35 / R37 / R39 to trim down the voltage
R43 and R44 are used to trim PS1 output
Sepcific to Evolutek
R41 and R42 are used to trim PS1 output
R39 and R40 are used to trim PS1 output
