evolutek/carte-alim/V5/Carte Alim.kicad_pcb

## KiCad design V5/Carte Alim.kicad_pcb (continued)

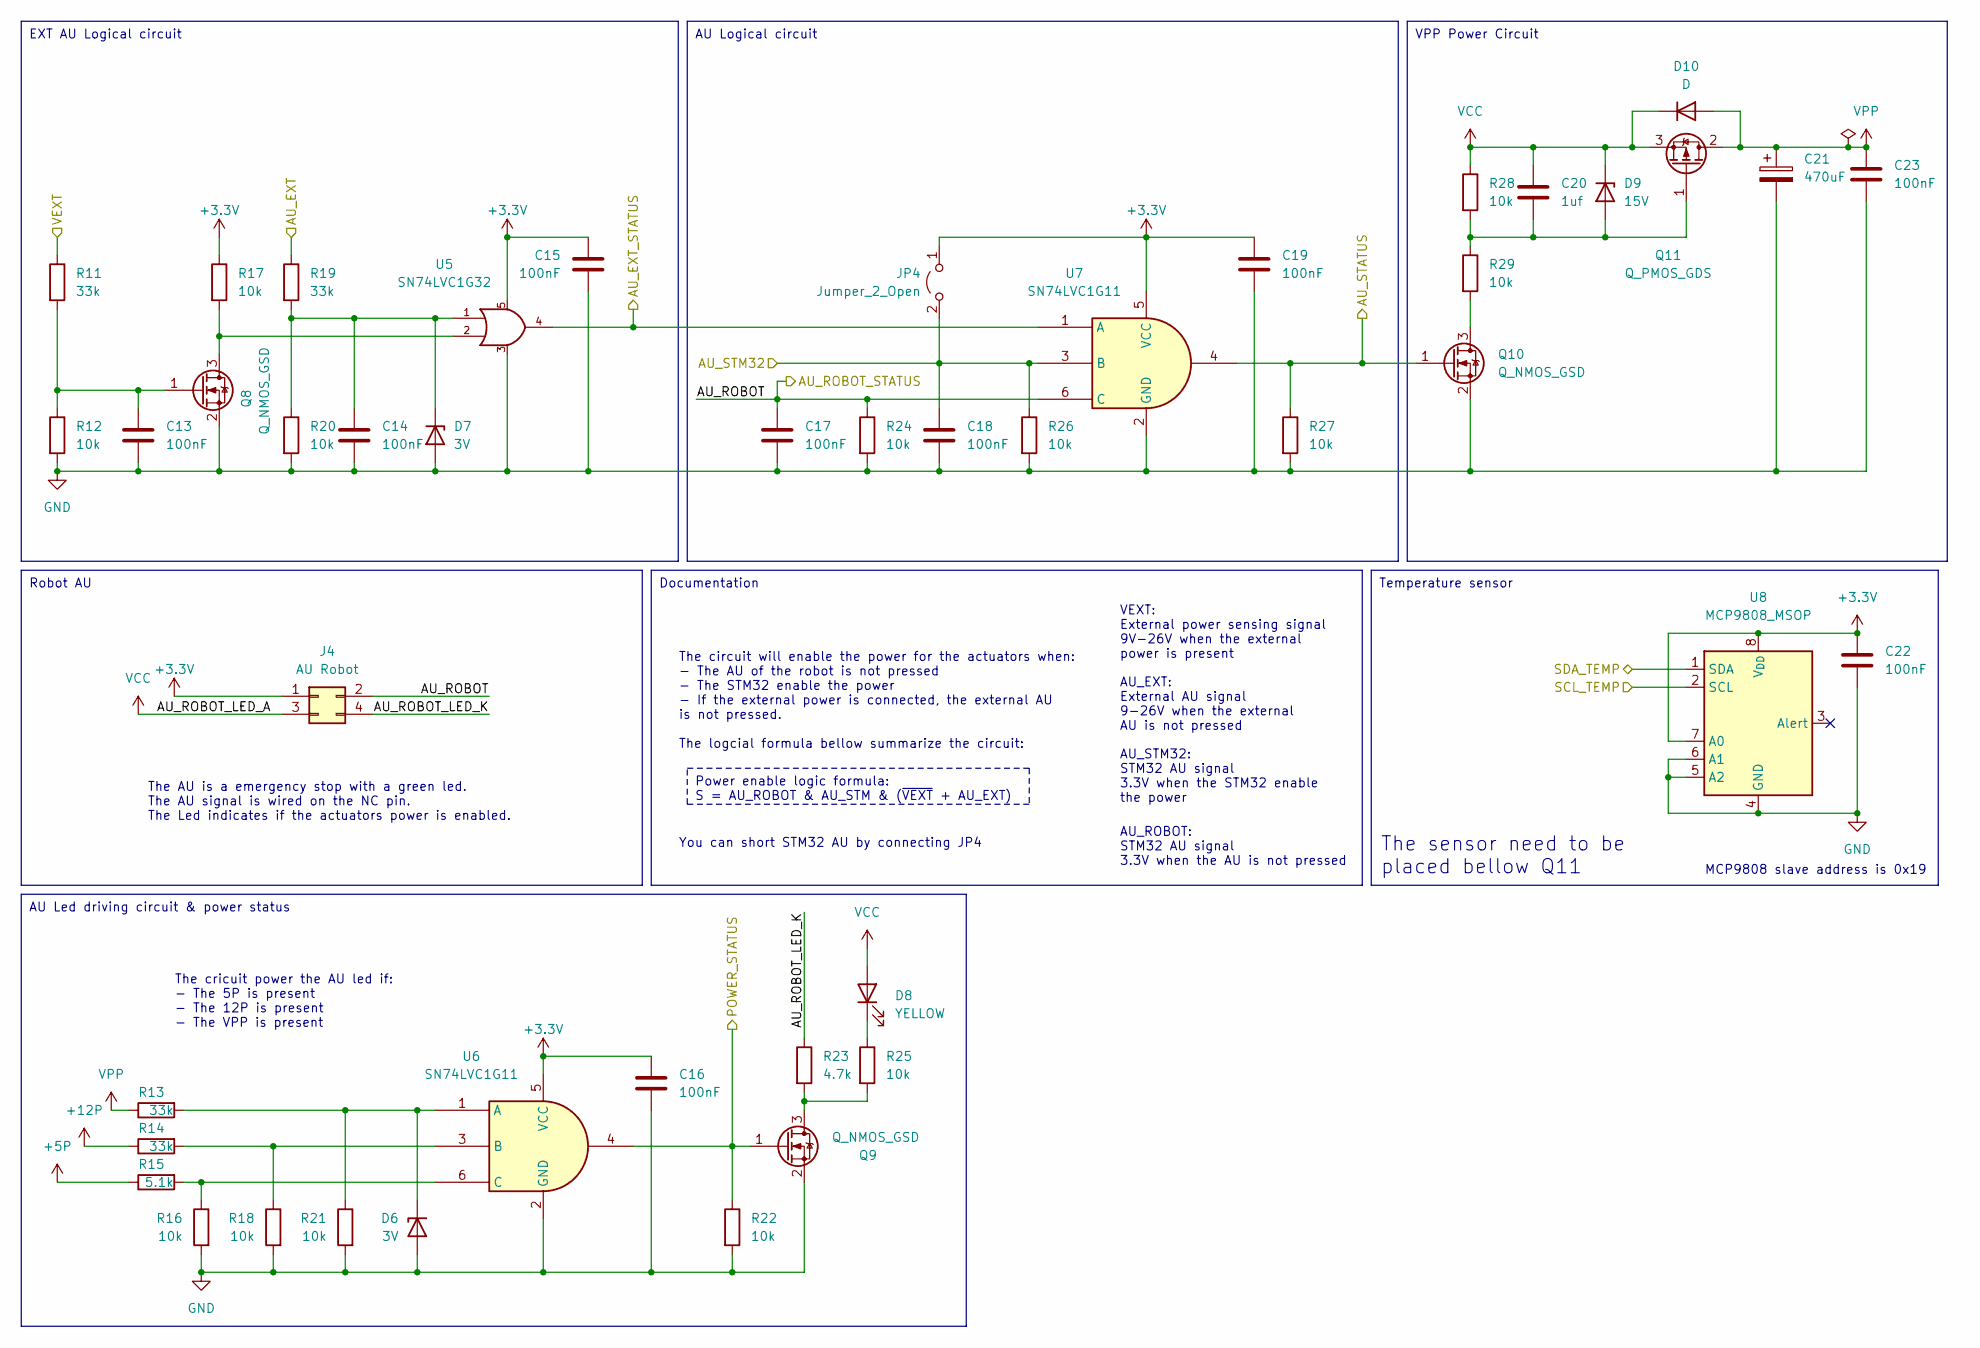
[picture p57: schematic AU.kicad_sch, Carte Alim]

Parts:
C13, C14, C15, C16, C17, C18, C19, C22, C23: 100nF; C_0603_1608Metric
C20: 1uf; C_0603_1608Metric
C21: 470uF; CP_Radial_D10.0mm_P5.00mm
D6, D7: 3V; D_SOD-523
D8: YELLOW; LED_0805_2012Metric
D9: 15V; D_SOD-523
D10: D; DO-214AB
J4: AU Robot; 690367280476
JP4: Jumper_2_Open; PinHeader_1x02_P2.54mm_Vertical
Q8, Q9, Q10: Q_NMOS_GSD; SOT-23
Q11: Q_PMOS_GDS; TO-252-2
R11, R13, R14, R19: 33k; R_0603_1608Metric
R12, R16, R17, R18, R20, R21, R22, R24, R25, R26, R27, R28, R29: 10k; R_0603_1608Metric
R15: 5.1k; R_0603_1608Metric
R23: 4.7k; R_0603_1608Metric
U5: SN74LVC1G32; SOT-23-5
U6, U7: SN74LVC1G11; SOT-23-6
U8: MCP9808_MSOP; MSOP-8_3x3mm_P0.65mm

Connections:
+3.3V: C15.1, C16.1, C19.1, C22.1, J4.1, JP4.1 (A), R17.1, U5.5 (VCC), U6.5 (VCC), U7.5 (VCC), U8.7 (A0), U8.8 (V_{DD}); also elsewhere on the board
+5P: R15.1; also elsewhere on the board
+12P: R14.1; also elsewhere on the board
/AU/AU_EXT: R19.1; also elsewhere on the board
/AU/AU_EXT_STATUS: U5.4 (S), U7.1 (A); also elsewhere on the board
/AU/AU_ROBOT: C17.1, J4.2, R24.1, U7.6 (C); also elsewhere on the board
/AU/AU_ROBOT_LED_K: J4.4, R23.1
/AU/AU_STATUS: Q10.1 (G), R27.1, U7.4; also elsewhere on the board
/AU/AU_STM32: C18.1, JP4.2 (B), R26.1, U7.3 (B); also elsewhere on the board
/AU/POWER_STATUS: Q9.1 (G), R22.1, U6.4; also elsewhere on the board
/AU/SCL_TEMP: U8.2 (SCL); also elsewhere on the board
/AU/SDA_TEMP: U8.1 (SDA); also elsewhere on the board
/AU/VEXT: R11.1; also elsewhere on the board
GND: C13.2, C14.2, C15.2, C16.2, C17.2, C18.2, C19.2, C21.2, C22.2, C23.2, D6.2 (A), D7.2 (A), Q8.2 (S), Q9.2 (S), Q10.2 (S), R12.2, R16.2, R18.2, R20.2, R21.2, R22.2, R24.2, R26.2, R27.2, U5.3 (GND), U6.2 (GND), U7.2 (GND), U8.4 (GND), U8.5 (A2), U8.6 (A1); also elsewhere on the board
unnamed: D6.1 (K), R13.2, R21.1, U6.1 (A)
unnamed: C14.1, D7.1 (K), R19.2, R20.1, U5.1 (A)
unnamed: D8.1 (K), R25.1
unnamed: C20.2, D9.2 (A), Q11.1 (G), R28.2, R29.1
unnamed: Q8.3 (D), R17.2, U5.2 (B)
unnamed: C13.1, Q8.1 (G), R11.2, R12.1
unnamed: Q9.3 (D), R23.2, R25.2
unnamed: Q10.3 (D), R29.2
unnamed: R14.2, R18.1, U6.3 (B)
unnamed: R15.2, R16.1, U6.6 (C)
VCC: C20.1, D8.2 (A), D9.1 (K), D10.1 (K), J4.3, Q11.3 (S), R28.1; also elsewhere on the board
VPP: C21.1, C23.1, D10.2 (A), Q11.2 (D), R13.1; also elsewhere on the board

Notes on the sheet:
AU Led driving circuit & power status
Temperature sensor
AU Logical circuit
Documentation
Power enable logic formula: S = AU_ROBOT & AU_STM & (~{VEXT} + AU_EXT)
Robot AU
VPP Power Circuit
EXT AU Logical circuit
MCP9808 slave address is 0x19
AU_EXT: External AU signal 9-26V when the external AU is not pressed
You can short STM32 AU by connecting JP4
The cricuit power the AU led if: - The 5P is present - The 12P is present - The VPP is present
The sensor need to be placed bellow Q11
The AU is a emergency stop with a green led. The AU signal is wired on the NC pin. The Led indicates if the actuators power is enabled.
AU_ROBOT: STM32 AU signal 3.3V when the AU is not pressed
AU_STM32: STM32 AU signal 3.3V when the STM32 enable the power
VEXT: External power sensing signal 9V-26V when the external power is present
The circuit will enable the power for the actuators when: - The AU of the robot is not pressed - The STM32 enable the power - If the external power is connected, the external AU is not pressed. The logcial formula bellow summarize the circuit:

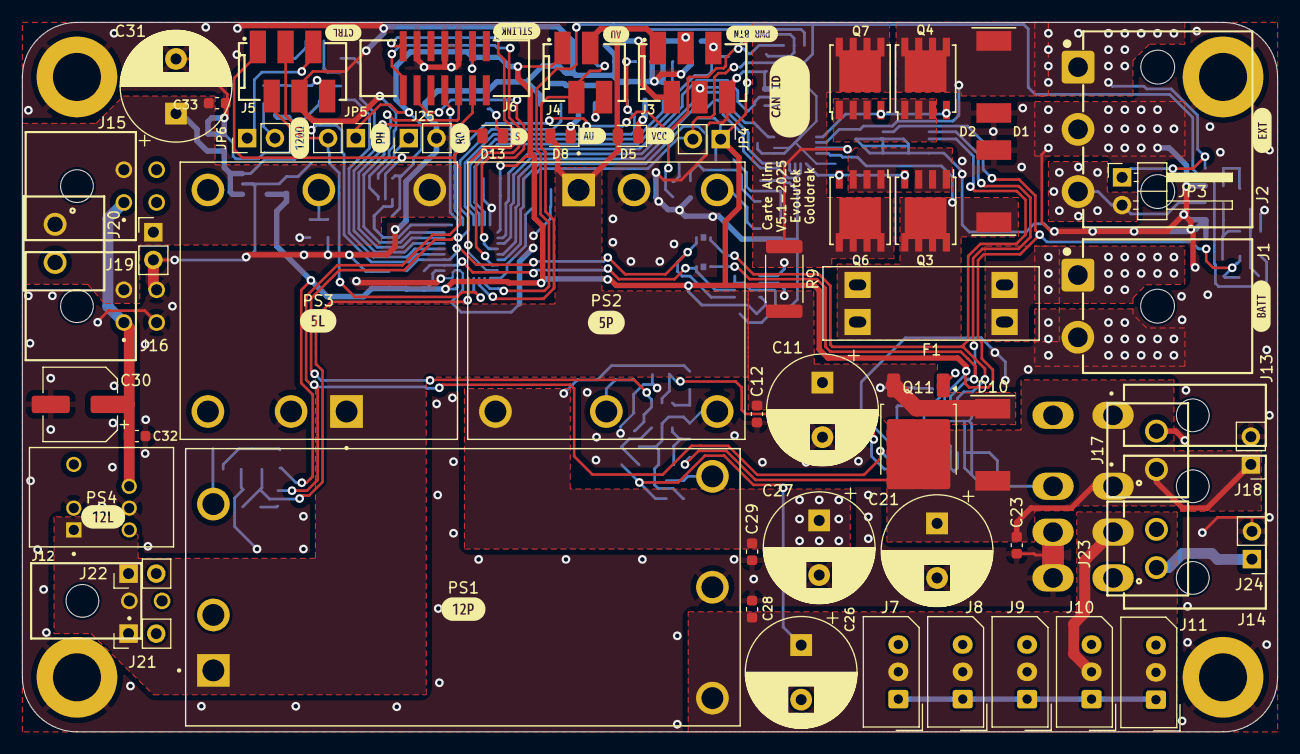
[picture p58: board V5/Carte Alim.kicad_pcb from above]

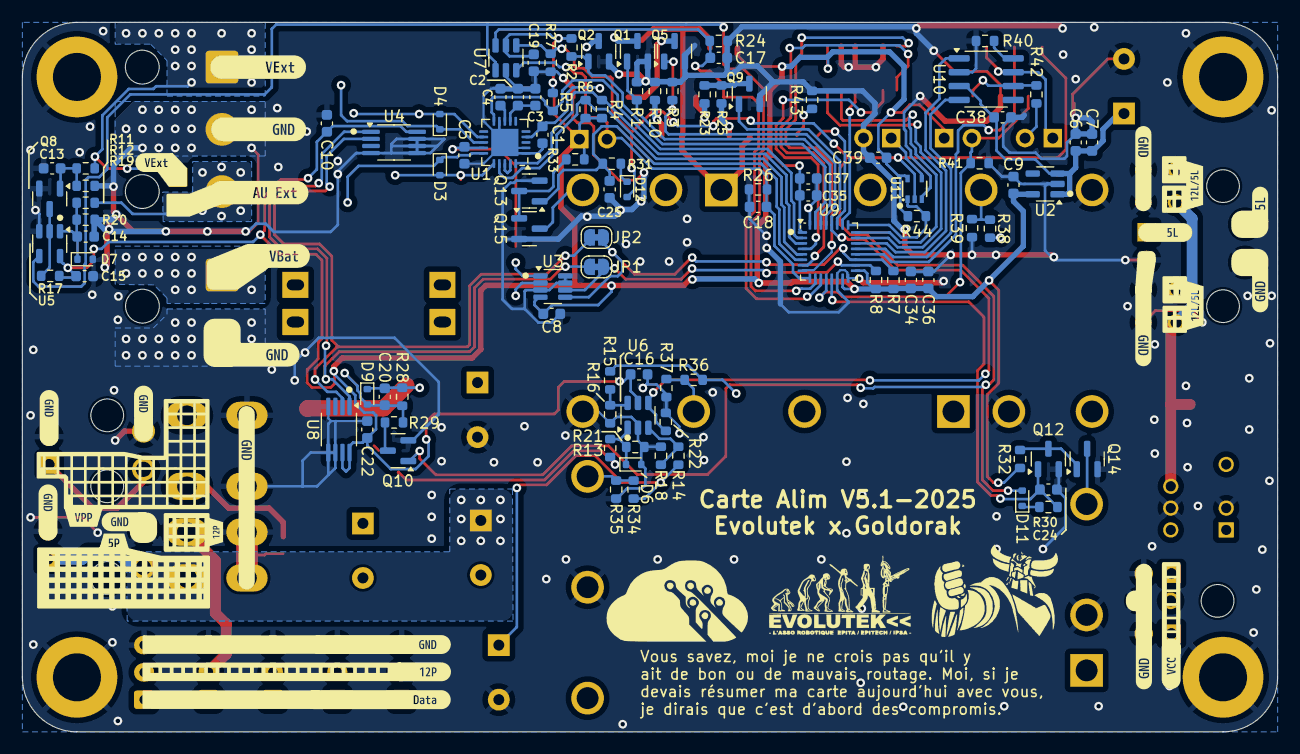
[picture p59: board V5/Carte Alim.kicad_pcb from below]

Board: 2 copper layers, 115.0 x 65.0 mm, 207 parts (132 on the bottom side), 81 nets.

Other parts of the board:
kibuzzard-677B4629: G***; kibuzzard-677B4629
kibuzzard-677B4649: G***; kibuzzard-677B4649
kibuzzard-67872BAA: G***; kibuzzard-67872BAA
kibuzzard-67872D20: G***; kibuzzard-67872D20
kibuzzard-67872D71, kibuzzard-67872D71#2: G***; kibuzzard-67872D71
kibuzzard-67872E75: G***; kibuzzard-67872E75
kibuzzard-660203FB: G***; kibuzzard-660203FB
kibuzzard-678726F2: G***; kibuzzard-678726F2
kibuzzard-678729C6, kibuzzard-678729C6#2: G***; kibuzzard-678729C6
kibuzzard-678735CA: G***; kibuzzard-678735CA
kibuzzard-678737AF: G***; kibuzzard-678737AF
kibuzzard-678737BE: G***; kibuzzard-678737BE
kibuzzard-678737CF: G***; kibuzzard-678737CF
kibuzzard-678738AB: G***; kibuzzard-678738AB
kibuzzard-678739A0: G***; kibuzzard-678739A0
kibuzzard-678739C1: G***; kibuzzard-678739C1
kibuzzard-678739E2: G***; kibuzzard-678739E2
kibuzzard-678739EE: G***; kibuzzard-678739EE
kibuzzard-678739F9: G***; kibuzzard-678739F9
kibuzzard-6787393E: G***; kibuzzard-6787393E
kibuzzard-6787394A: G***; kibuzzard-6787394A
kibuzzard-66020582: G***; kibuzzard-66020582
kibuzzard-66020634: G***; kibuzzard-66020634
kibuzzard-66020666: G***; kibuzzard-66020666
kibuzzard-66020679: G***; kibuzzard-66020679
kibuzzard-66020780: G***; kibuzzard-66020780
kibuzzard-67872335: G***; kibuzzard-67872335
kibuzzard-67872371: G***; kibuzzard-67872371
kibuzzard-67872386: G***; kibuzzard-67872386
kibuzzard-67872790: G***; kibuzzard-67872790
kibuzzard-67872810: G***; kibuzzard-67872810
kibuzzard-67873017: G***; kibuzzard-67873017
kibuzzard-67873080: G***; kibuzzard-67873080
kibuzzard-67873255: G***; kibuzzard-67873255
kibuzzard-67873261: G***; kibuzzard-67873261
kibuzzard-67873515, kibuzzard-67873515#2: G***; kibuzzard-67873515
kibuzzard-67873807: G***; kibuzzard-67873807
kibuzzard-67873850: G***; kibuzzard-67873850
kibuzzard-67873964: G***; kibuzzard-67873964
