evolutek/carte-alim/USB C montage panneau/USB C montage panneau.kicad_pcb

## KiCad design USB C montage panneau/USB C montage panneau.kicad_pcb (2024-08-19)

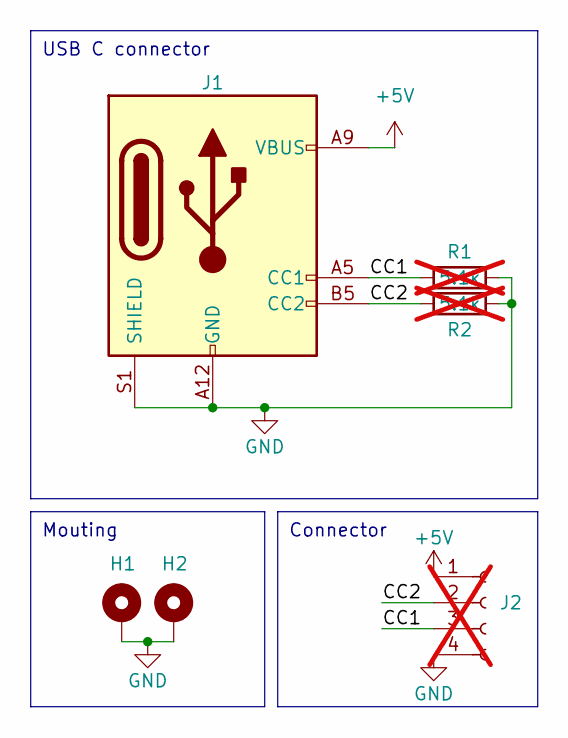
[picture p60: schematic USB C montage panneau.kicad_sch]

Parts:
H1, H2: MountingHole_Pad; WA-SMSI_9774030360
J1: USB_C_Receptacle_PowerOnly_6P; GCT_USB4140-GF-0170-C_REV0.4
J2: Conn_01x04_Socket; PinHeader_1x04_P2.54mm_Vertical; not fitted
R1, R2: 5.1k; R_0603_1608Metric; not fitted

Connections:
+5V: J1.A9 (VBUS), J1.B9 (VBUS), J2.1
/CC1: J1.A5 (CC1), J2.3, R1.1
/CC2: J1.B5 (CC2), J2.2, R2.1
GND: H1.1, H2.1, J1.A12 (GND), J1.B12 (GND), J1.S1 (SHIELD), J2.4, R1.2, R2.2

Notes on the sheet:
Mouting
Connector
USB C connector

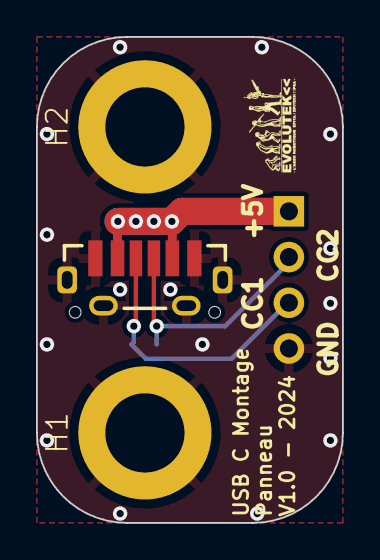
[picture p61: board USB C montage panneau.kicad_pcb from above]

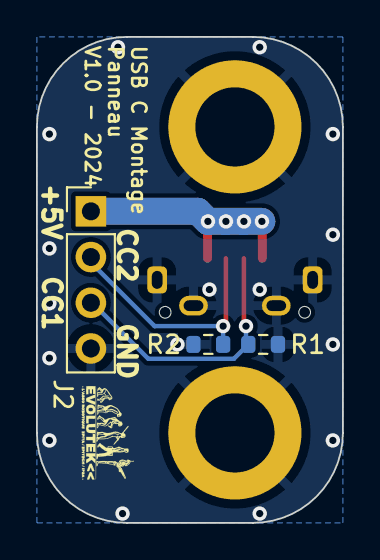
[picture p62: board USB C montage panneau.kicad_pcb from below]

Board: 2 copper layers, 17.0 x 27.0 mm, 6 parts (3 on the bottom side), 4 nets.
