evolutek/carte-alim/Mini carte alim V2/Mini carte alim V2.kicad_pcb

## KiCad design Mini carte alim V2/Mini carte alim V2.kicad_pcb (2024-02-21)

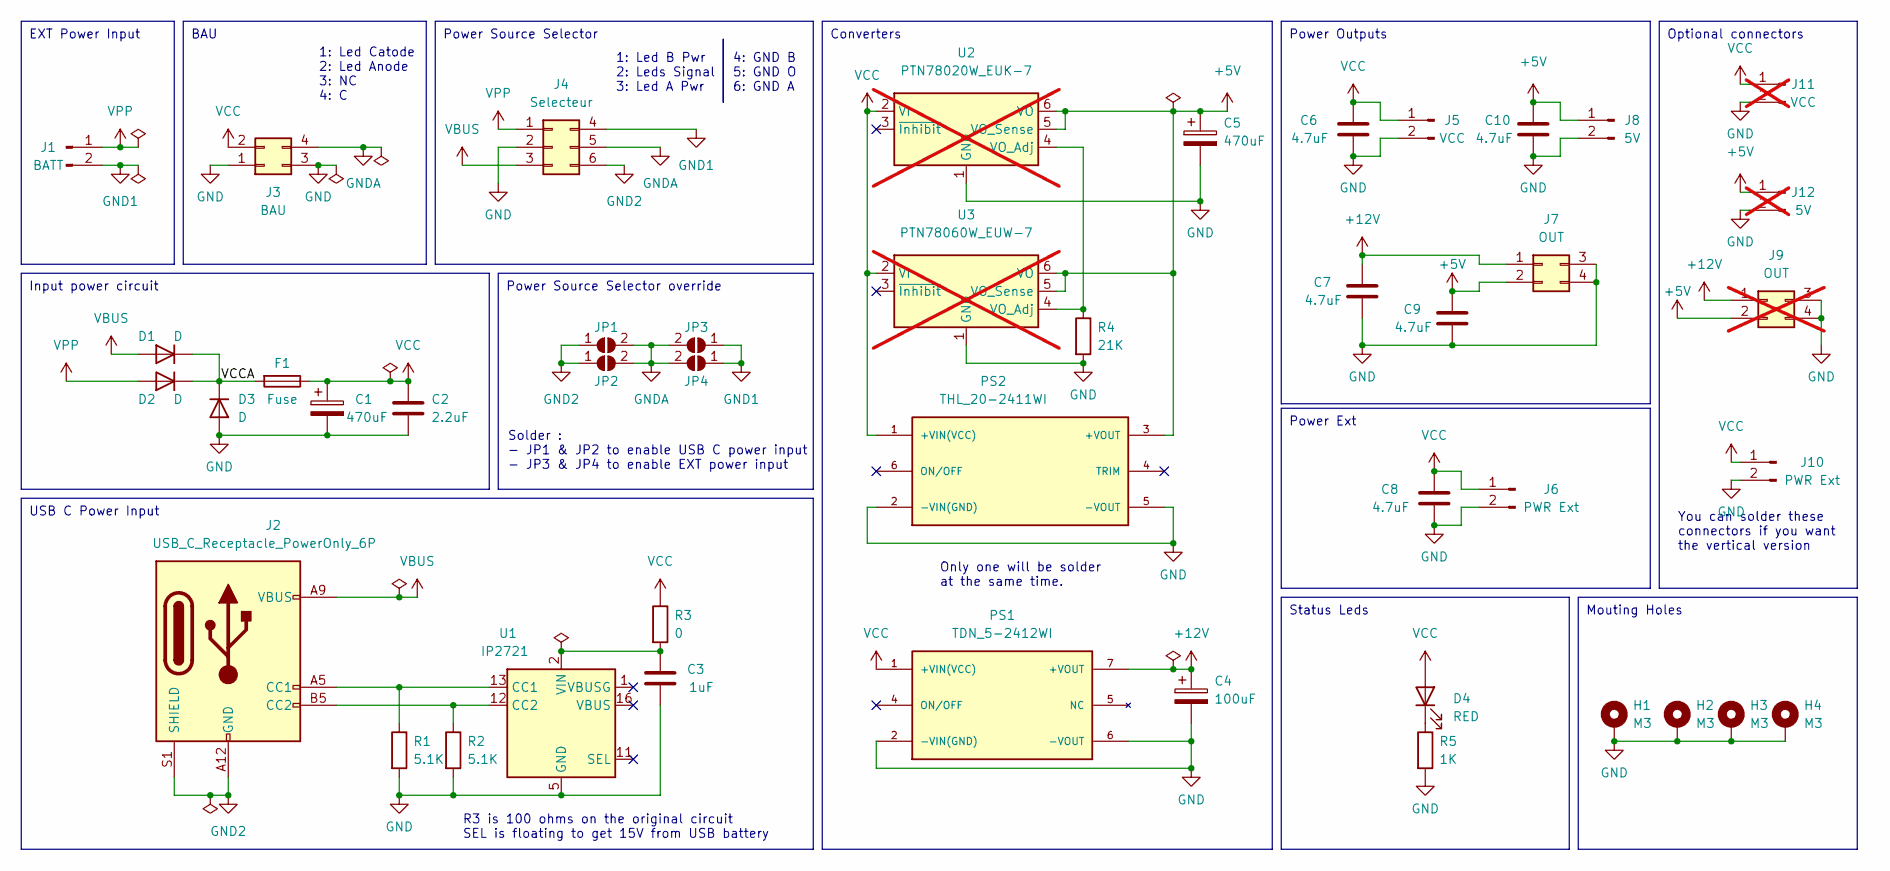
[picture p63: schematic Mini carte alim V2.kicad_sch, Mini carte alim]

Parts:
C1, C5: 470uF; CP_Radial_D10.0mm_P5.00mm
C2: 2.2uF; C_0603_1608Metric
C3: 1uF; C_0603_1608Metric
C4: 100uF; C_Elec_6.3x7.7
C6, C7, C8, C9, C10: 4.7uF; C_0603_1608Metric
D1, D2, D3: D; DO-214AB
D4: RED; LED_0805_2012Metric
F1: Fuse; 0031.7701.11
H1, H2, H3, H4: M3; MountingHole_3.2mm_M3_Pad_Via
J1: BATT; 649002227222
J2: USB_C_Receptacle_PowerOnly_6P; GCT_USB4125-GF-A_REVA2
J3: BAU; 66200421022
J4: Selecteur; 66200621022
J5: VCC; 66200221022
J6, J10: PWR Ext; 66200221022
J7: OUT; 66200421022
J8: 5V; 66200221022
J9: OUT; 66200421122; not fitted
J11: VCC; 66200221122; not fitted
J12: 5V; 66200221122; not fitted
JP1, JP2, JP3, JP4: SolderJumper_2_Open; SolderJumper-2_P1.3mm_Open_Pad1.0x1.5mm
PS1: TDN_5-2412WI; TRACO_CONV_TDN; PARTREV May 18, 2020
PS2: THL_20-2411WI; TRACO_CONV_THL; PARTREV Jan 18, 2021
R1, R2: 5.1K; R_0603_1608Metric
R3: 0; R_0603_1608Metric
R4: 21K; R_0603_1608Metric
R5: 1K; R_0603_1608Metric
U1: IP2721; TSSOP-16_4.4x5mm_P0.65mm
U2: PTN78020W_EUK-7; Texas_EUK_R-PDSS-T7_THT; not fitted
U3: PTN78060W_EUW-7; Texas_EUW_R-PDSS-T7_THT; not fitted

Connections:
+5V: C5.1, C9.1, C10.1, J7.2, J8.1, J9.2, J12.1, PS2.3 (+VOUT), U2.5 (VO_Sense), U2.6 (VO), U3.5 (VO_Sense), U3.6 (VO)
+12V: C4.1, C7.1, J7.1, J9.1, PS1.7 (+VOUT)
/VCCA: D1.1 (K), D2.1 (K), D3.1 (K), F1.2
GND: C1.2, C2.2, C3.2, C4.2, C5.2, C6.2, C7.2, C8.2, C9.2, C10.2, D3.2 (A), H1.1, H2.1, H3.1, H4.1, J3.1, J3.3, J4.2, J5.2, J6.2, J7.3, J7.4, J8.2, J9.3, J9.4, J10.2, J11.2, J12.2, PS1.2 (-VIN(GND)), PS1.6 (-VOUT), PS2.2 (-VIN(GND)), PS2.5 (-VOUT), R1.2, R2.2, R4.2, R5.2, U1.5 (GND), U2.1 (GND), U2.7 (GND), U3.1 (GND), U3.7 (GND)
GND1: J1.2, J4.4, JP3.1 (A), JP4.1 (A)
GND2: J2.A12 (GND), J2.B12 (GND), J2.S1 (SHIELD), J4.6, JP1.1 (A), JP2.1 (A)
GNDA: J3.4, J4.5, JP1.2 (B), JP2.2 (B), JP3.2 (B), JP4.2 (B)
unnamed: D4.1 (K), R5.1
unnamed: J2.A5 (CC1), R1.1, U1.13 (CC1)
unnamed: J2.B5 (CC2), R2.1, U1.12 (CC2)
unnamed: C3.1, R3.2, U1.2 (VIN)
unnamed: R4.1, U2.4 (VO_Adj), U3.4 (VO_Adj)
VBUS: D1.2 (A), J2.A9 (VBUS), J2.B9 (VBUS), J4.3
VCC: C1.1, C2.1, C6.1, C8.1, D4.2 (A), F1.1, J3.2, J5.1, J6.1, J10.1, J11.1, PS1.1 (+VIN(VCC)), PS2.1 (+VIN(VCC)), R3.1, U2.2 (VI), U3.2 (VI)
VPP: D2.2 (A), J1.1, J4.1

Notes on the sheet:
Optional connectors
BAU
EXT Power Input
Status Leds
Power Source Selector override
Power Source Selector
Input power circuit
Mouting Holes
USB C Power Input
Power Outputs
Converters
Power Ext
4: GND B 5: GND O 6: GND A
You can solder these connectors if you want the vertical version
R3 is 100 ohms on the original circuit SEL is floating to get 15V from USB battery
1: Led Catode 2: Led Anode 3: NC 4: C
Only one will be solder at the same time.
1: Led B Pwr 2: Leds Signal 3: Led A Pwr
Solder : - JP1 & JP2 to enable USB C power input - JP3 & JP4 to enable EXT power input

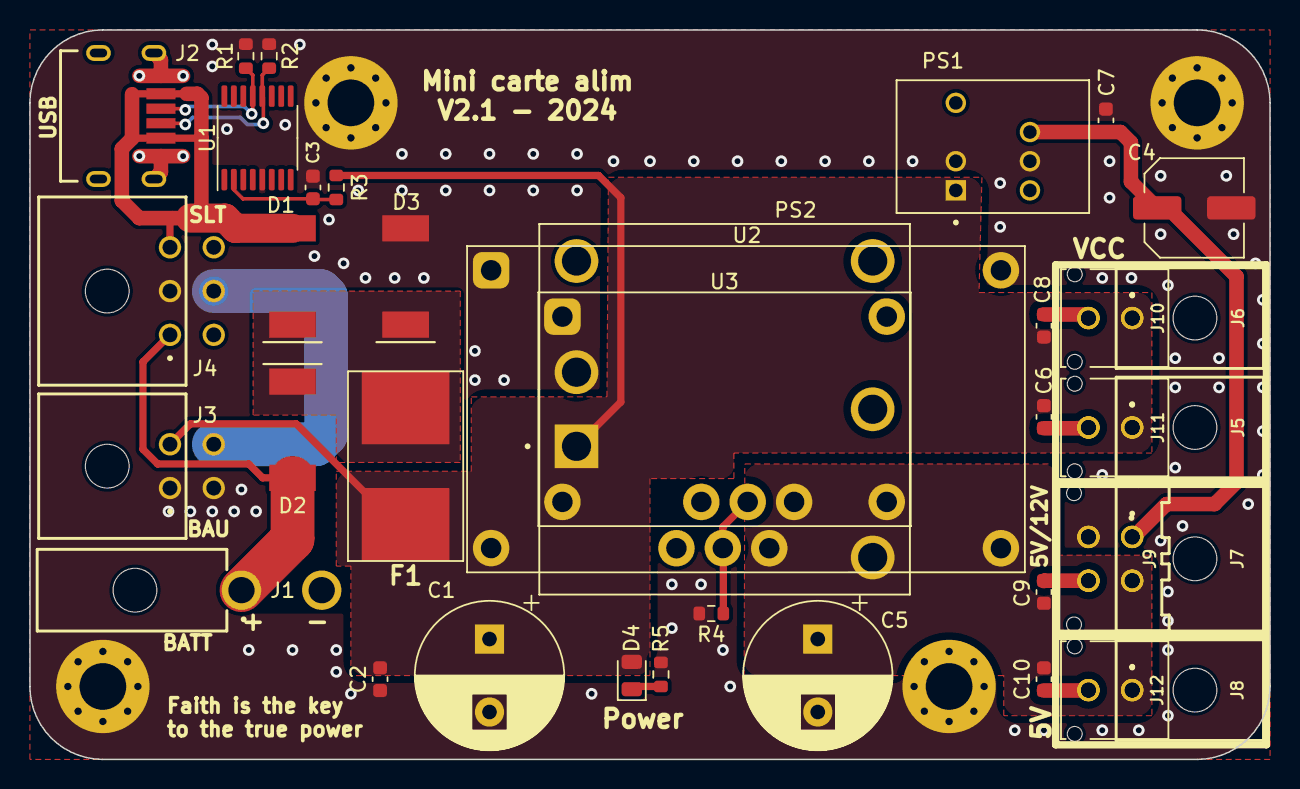
[picture p64: board Mini carte alim V2.kicad_pcb from above]

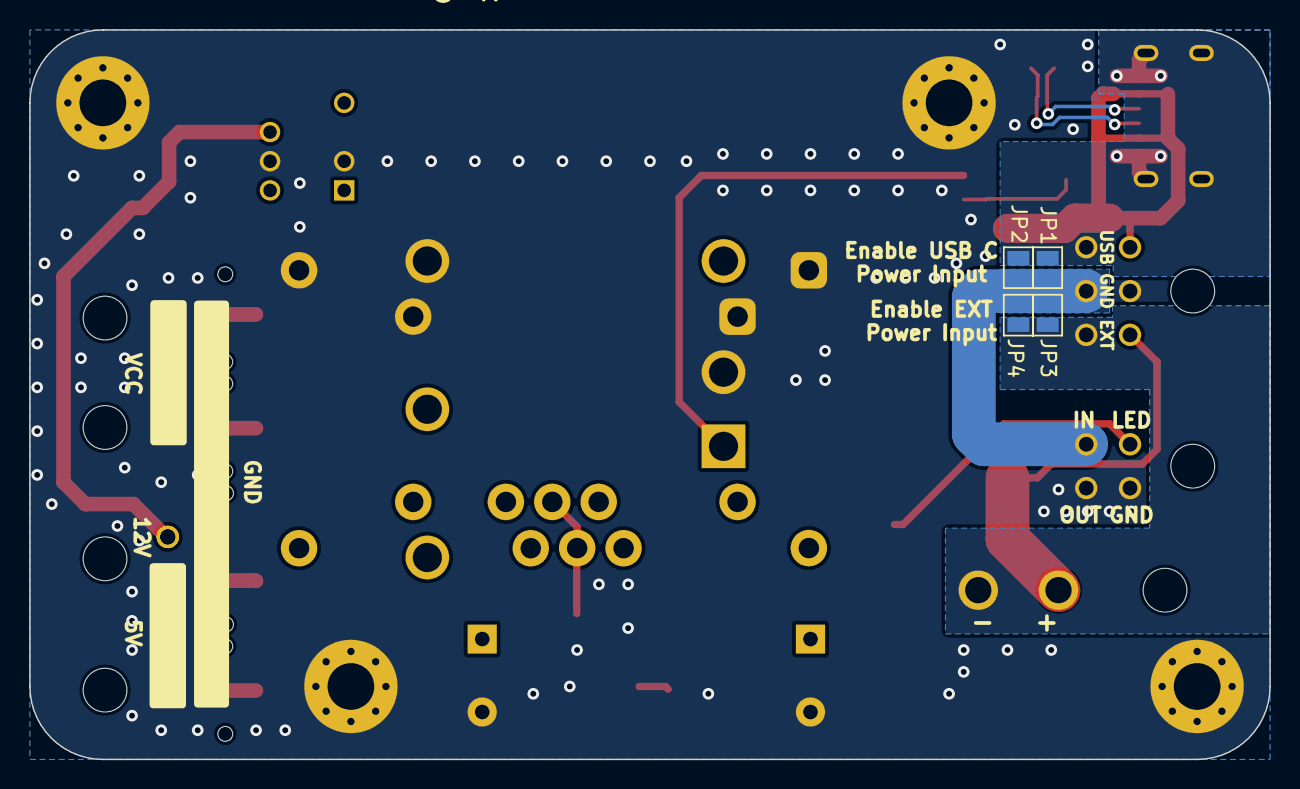
[picture p65: board Mini carte alim V2.kicad_pcb from below]

Board: 2 copper layers, 85.0 x 50.0 mm, 45 parts (4 on the bottom side), 15 nets.
