evolutek/carte-alim/Mini carte alim V1/Mini carte alim V1.kicad_pcb

## KiCad design Mini carte alim V1/Mini carte alim V1.kicad_pcb (2023-10-14, an earlier design)

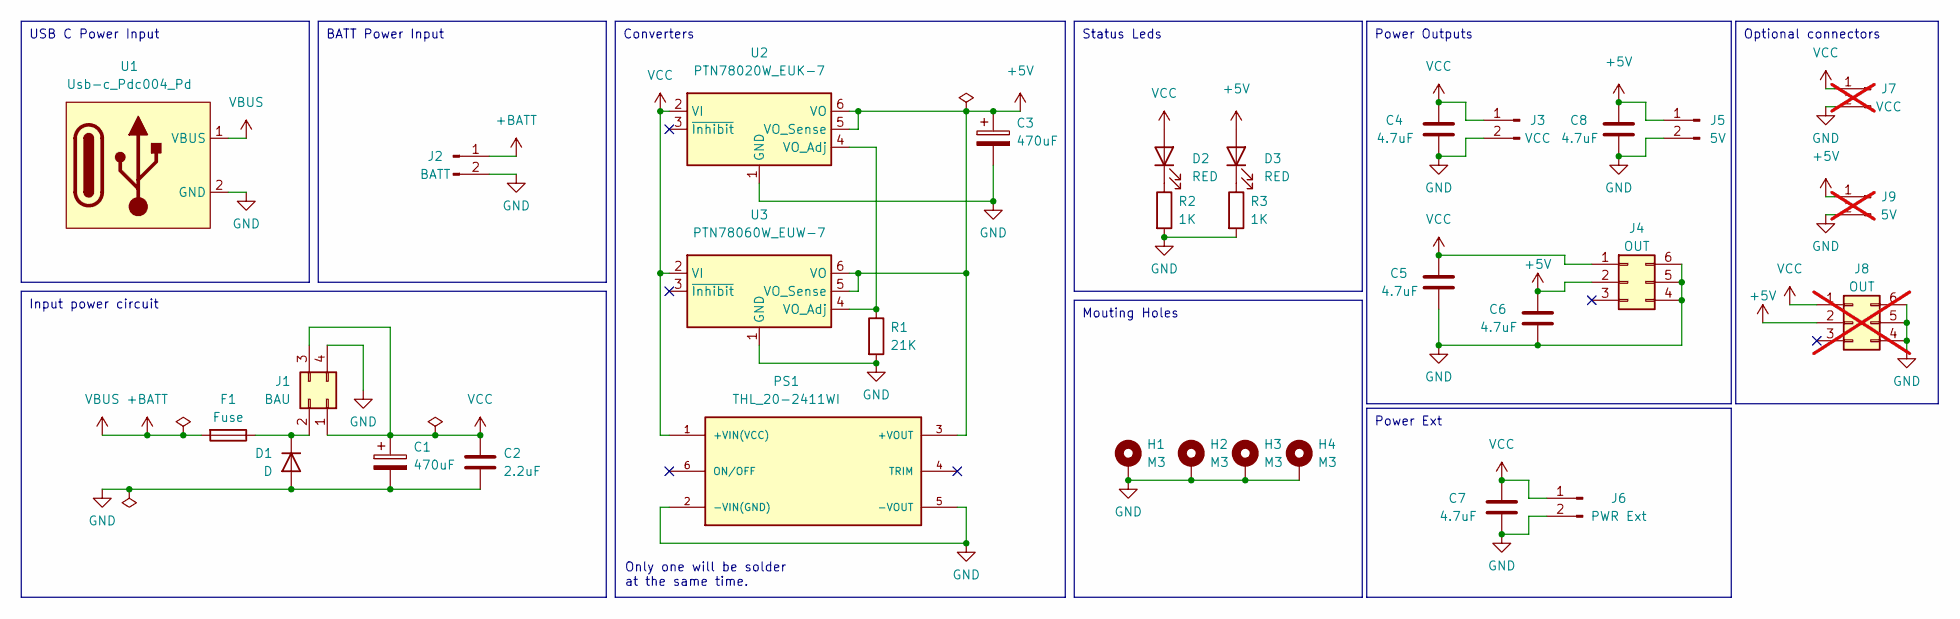
[picture p66: schematic Mini carte alim V1.kicad_sch, Mini carte alim]

Parts:
C1, C3: 470uF; CP_Radial_D10.0mm_P5.00mm
C2: 2.2uF; C_0603_1608Metric
C4, C5, C6, C7, C8: 4.7uF; C_0603_1608Metric
D1: D; DO-214AB
D2, D3: RED; LED_0805_2012Metric
F1: Fuse; 0031.7701.11
H1, H2, H3, H4: M3; MountingHole_3.2mm_M3_Pad_Via
J1: BAU; 649004227222
J2: BATT; 649002227222
J3: VCC; 66200221022
J4: OUT; 66200621022
J5: 5V; 66200221022
J6: PWR Ext; B02B-PASK
J7: VCC; 66200221122; not fitted
J8: OUT; 66200621122; not fitted
J9: 5V; 66200221122; not fitted
PS1: THL_20-2411WI; TRACO_CONV_THL; PARTREV Jan 18, 2021
R1: 21K; R_0603_1608Metric
R2, R3: 1K; R_0603_1608Metric
U1: Usb-c_Pdc004_Pd
U2: PTN78020W_EUK-7; Texas_EUK_R-PDSS-T7_THT
U3: PTN78060W_EUW-7; Texas_EUW_R-PDSS-T7_THT

Connections:
+5V: C3.1, C6.1, C8.1, D3.2 (A), J4.2, J5.1, J8.2, J9.1, PS1.3 (+VOUT), U2.5 (VO_Sense), U2.6 (VO), U3.5 (VO_Sense), U3.6 (VO)
+BATT: F1.2, J2.1, U1.1 (VBUS)
GND: C1.2, C2.2, C3.2, C4.2, C5.2, C6.2, C7.2, C8.2, D1.2 (A), H1.1, H2.1, H3.1, H4.1, J1.4, J2.2, J3.2, J4.4, J4.5, J4.6, J5.2, J6.2, J7.2, J8.4, J8.5, J8.6, J9.2, PS1.2 (-VIN(GND)), PS1.5 (-VOUT), R1.2, R2.2, R3.2, U1.2 (GND), U2.1 (GND), U2.7 (GND), U3.1 (GND), U3.7 (GND)
unnamed: D1.1 (K), F1.1, J1.2
unnamed: D2.1 (K), R2.1
unnamed: D3.1 (K), R3.1
unnamed: R1.1, U2.4 (VO_Adj), U3.4 (VO_Adj)
VCC: C1.1, C2.1, C4.1, C5.1, C7.1, D2.2 (A), J1.1, J1.3, J3.1, J4.1, J6.1, J7.1, J8.1, PS1.1 (+VIN(VCC)), U2.2 (VI), U3.2 (VI)

Notes on the sheet:
Optional connectors
BATT Power Input
Status Leds
USB C Power Input
Input power circuit
Mouting Holes
Power Outputs
Converters
Power Ext
Only one will be solder at the same time.

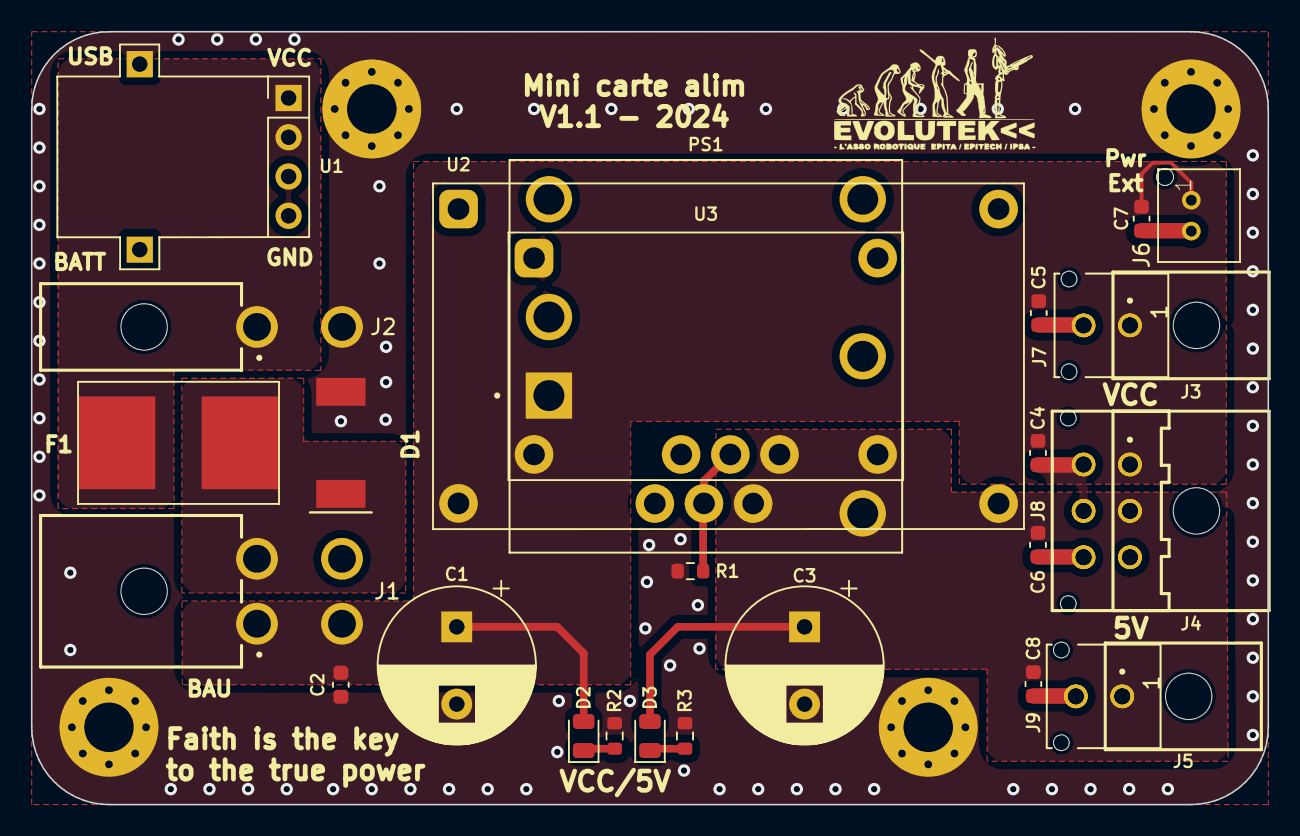
[picture p67: board Mini carte alim V1.kicad_pcb from above]

Board: 2 copper layers, 80.0 x 50.0 mm, 32 parts (0 on the bottom side), 8 nets.
