evolutek/carte-alim/Carte Boitier BAU/Carte Boitier BAU.kicad_pcb

## KiCad design Carte Boitier BAU/Carte Boitier BAU.kicad_pcb (2022-12-02)

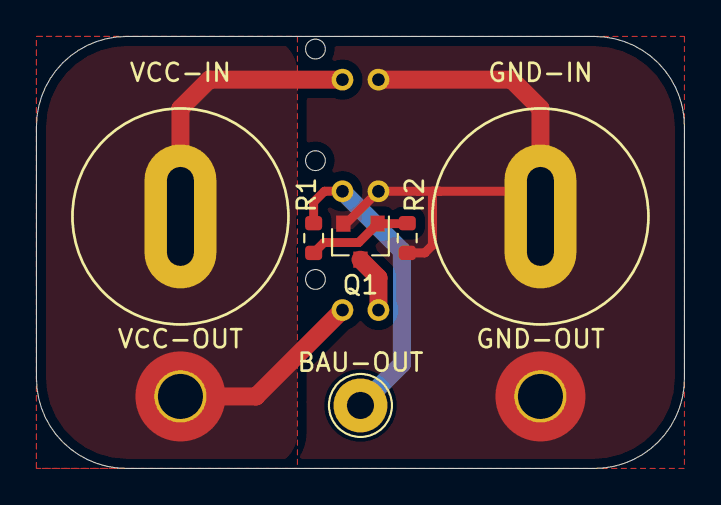
[picture p68: board Carte Boitier BAU.kicad_pcb from above]

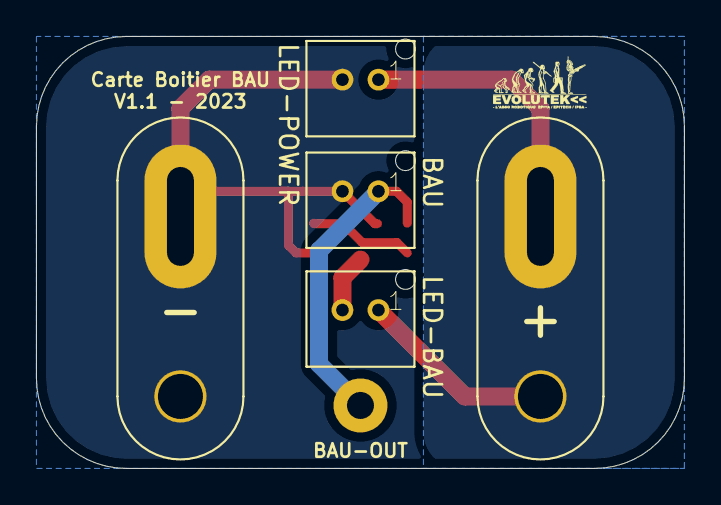
[picture p69: board Carte Boitier BAU.kicad_pcb from below]

Board: 2 copper layers, 36.0 x 24.0 mm, 11 parts (3 on the bottom side), 5 nets.

Parts:
BAU: Conn_01x02_Male; B02B-PASK
BAU-OUT: MountingHole_Pad; TestPoint_THTPad_D3.0mm_Drill1.5mm
GND-IN: Banana Plug Staubli Black; Banana_Plug_Staubli_Black
GND-OUT: MountingHole_Pad; MountingHole_2.5mm_Pad_TopOnly
LED-BAU: Conn_01x02_Male; B02B-PASK
LED-POWER: Conn_01x02_Male; B02B-PASK
Q1: Q_NMOS_GSD; SOT-23
R1, R2: 1K; R_0603_1608Metric
VCC-IN: Banana Plug Staubli Red; Banana_Plug_Staubli_Red
VCC-OUT: MountingHole_Pad; MountingHole_2.5mm_Pad_TopOnly

Connections:
/~BAU: BAU.1, BAU-OUT.1, R1.2
GND: BAU.2, GND-IN.1, GND-OUT.1, LED-POWER.2, Q1.2, R2.1
unnamed: LED-BAU.2, Q1.3
unnamed: Q1.1, R1.1, R2.2
VCC: LED-BAU.1, LED-POWER.1, VCC-IN.1, VCC-OUT.1
