evolutek/carte-alim/V4/Carte Alim.kicad_pcb

## KiCad design V4/Carte Alim.kicad_pcb (2022-11-22, an earlier design)

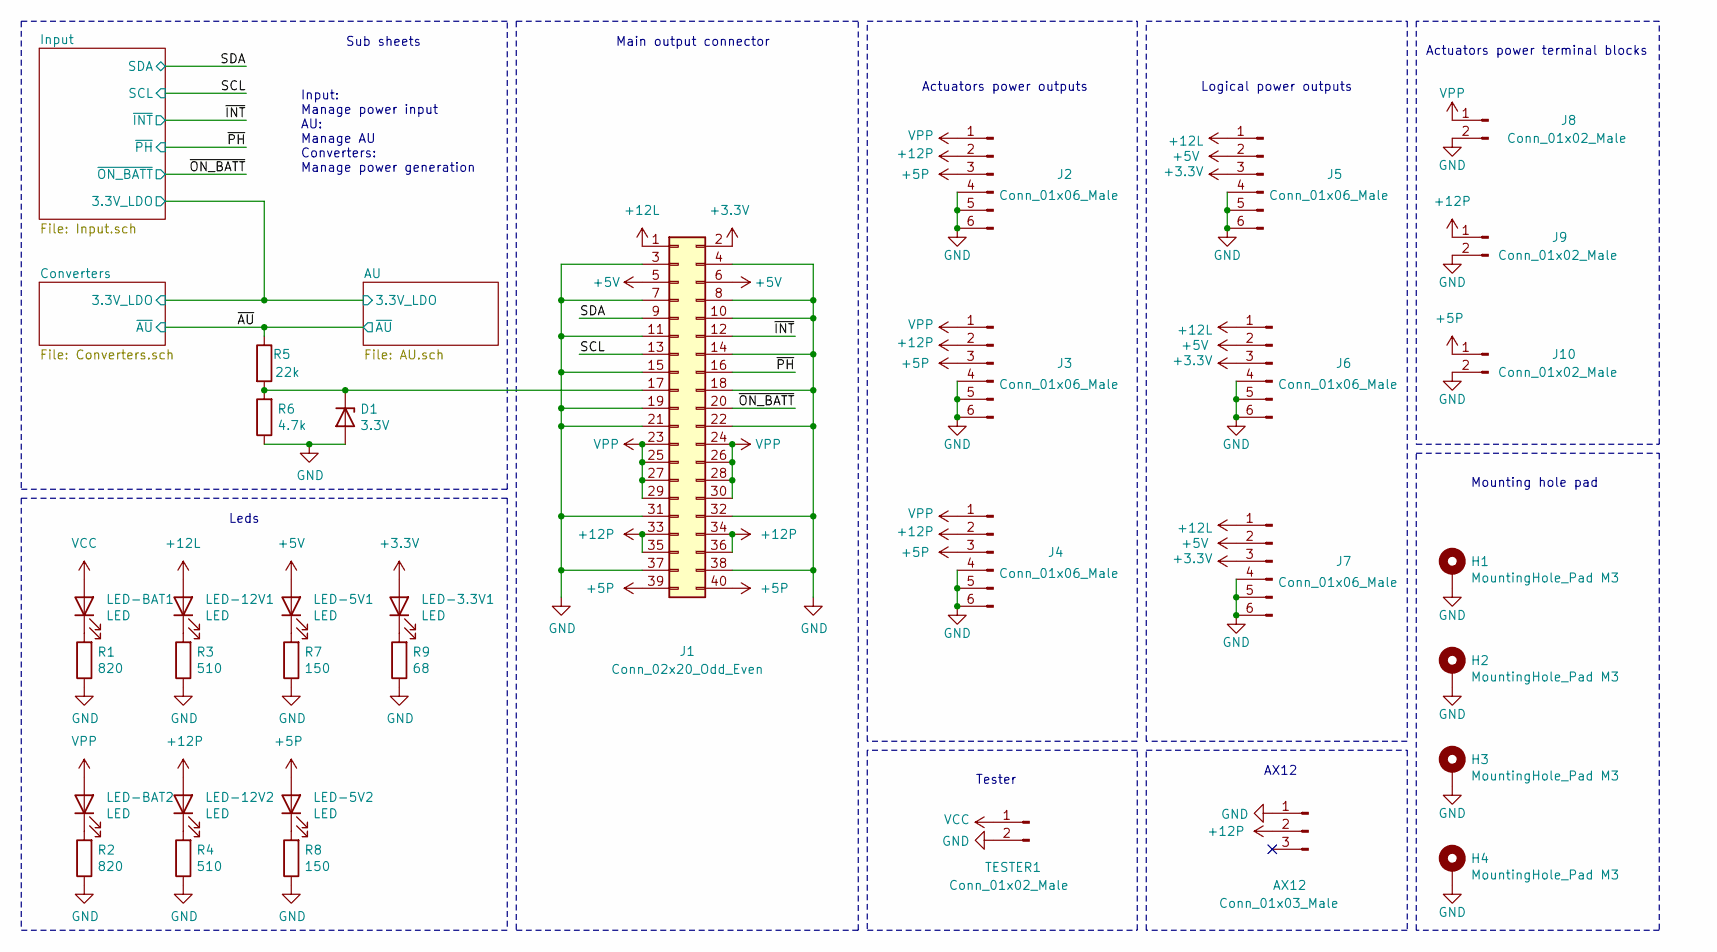
[picture p70: schematic Carte Alim.sch, Carte d'alimentation]

Parts:
AX12: Conn_01x03_Male; 22-05-7035
D1: 3.3V; D_SOD-523
H1, H2, H3, H4: MountingHole_Pad M3; MountingHole_3.2mm_M3_Pad_Via
J1: Conn_02x20_Odd_Even; PinHeader_2x20_P2.54mm_Vertical
J2, J3, J4, J5, J6, J7: Conn_01x06_Male; 66200621022
J8, J9, J10: Conn_01x02_Male; 649002227222
LED-3.3V1, LED-5V1, LED-5V2, LED-12V1, LED-12V2: LED; LED_0805_2012Metric
LED-BAT1, LED-BAT2: LED; LED_0805_2012Metric
R1, R2: 820; R_0603_1608Metric
R3, R4: 510; R_0603_1608Metric
R5: 22k; R_0603_1608Metric
R6: 4.7k; R_0603_1608Metric
R7, R8: 150; R_0603_1608Metric
R9: 68; R_0603_1608Metric
TESTER1: Conn_01x02_Male; 66200221022

Connections:
+3V3: J1.2, J5.3, J6.3, J7.3, LED-3.3V1.2 (A); also elsewhere on the board
+5P: J1.39, J1.40, J2.3, J3.3, J4.3, J10.1, LED-5V2.2 (A); also elsewhere on the board
+5V: J1.5, J1.6, J5.2, J6.2, J7.2, LED-5V1.2 (A); also elsewhere on the board
+12L: J1.1, J5.1, J6.1, J7.1, LED-12V1.2 (A); also elsewhere on the board
+12P: AX12.2, J1.33, J1.34, J1.35, J1.36, J2.2, J3.2, J4.2, J9.1, LED-12V2.2 (A); also elsewhere on the board
/SCL: J1.13; also elsewhere on the board
/SDA: J1.9; also elsewhere on the board
/~AU: R5.1; also elsewhere on the board
/~INT: J1.12; also elsewhere on the board
/~ON_BATT: J1.20; also elsewhere on the board
/~PH: J1.16; also elsewhere on the board
GND: AX12.1, D1.2 (A), H1.1, H2.1, H3.1, H4.1, J1.3, J1.4, J1.7, J1.8, J1.10, J1.11, J1.14, J1.15, J1.18, J1.19, J1.21, J1.22, J1.31, J1.32, J1.37, J1.38, J2.4, J2.5, J2.6, J3.4, J3.5, J3.6, J4.4, J4.5, J4.6, J5.4, J5.5, J5.6, J6.4, J6.5, J6.6, J7.4, J7.5, J7.6, J8.2, J9.2, J10.2, R1.1, R2.1, R3.1, R4.1, R6.1, R7.1, R8.1, R9.1, TESTER1.2; also elsewhere on the board
unnamed: D1.1 (K), J1.17, R5.2, R6.2
unnamed: LED-3.3V1.1 (K), R9.2
unnamed: LED-5V1.1 (K), R7.2
unnamed: LED-5V2.1 (K), R8.2
unnamed: LED-12V1.1 (K), R3.2
unnamed: LED-12V2.1 (K), R4.2
unnamed: LED-BAT1.1 (K), R1.2
unnamed: LED-BAT2.1 (K), R2.2
VCC: LED-BAT1.2 (A), TESTER1.1; also elsewhere on the board
VPP: J1.23, J1.24, J1.25, J1.26, J1.27, J1.28, J1.29, J1.30, J2.1, J3.1, J4.1, J8.1, LED-BAT2.2 (A); also elsewhere on the board

Notes on the sheet:
Leds
Tester
AX12
Sub sheets
Input: Manage power input AU: Manage AU Converters: Manage power generation
Main output connector
Actuators power outputs
Logical power outputs
Actuators power terminal blocks
Mounting hole pad
