evolutek/carte-alim/V4/Carte Alim.kicad_pcb

## KiCad design V4/Carte Alim.kicad_pcb (continued)

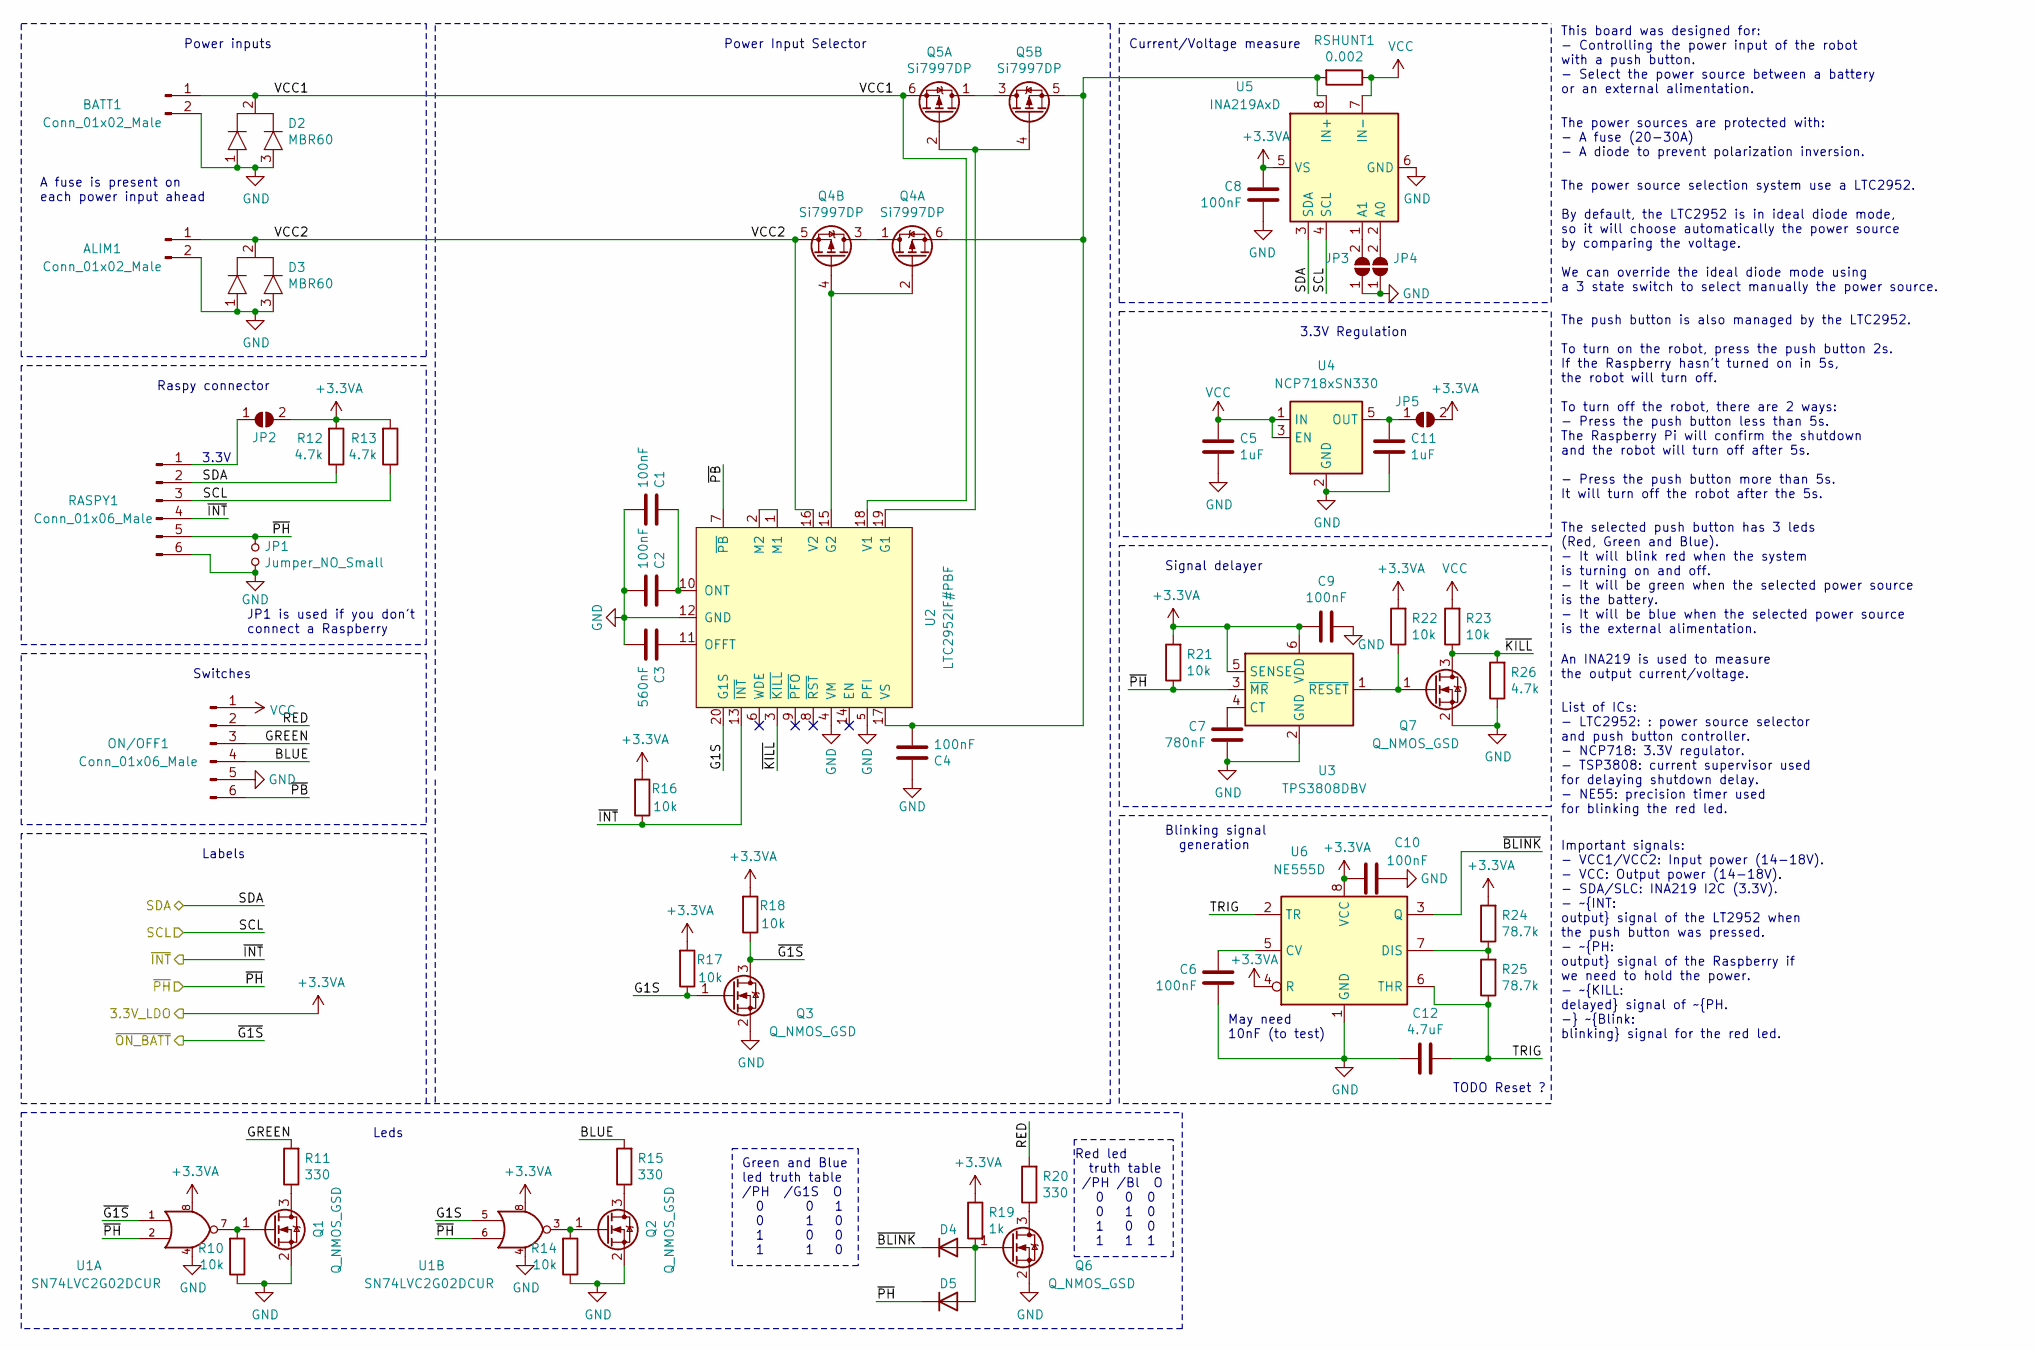
[picture p71: schematic Input.sch, Carte d'alimentation]

Parts:
ALIM1: Conn_01x02_Male; 691406710002B
BATT1: Conn_01x02_Male; 691406710002B
C1, C2, C4, C6, C8, C9, C10: 100nF; C_0603_1608Metric
C3: 560nF; C_0603_1608Metric
C5, C11: 1uF; C_0603_1608Metric
C7: 780nF; C_0603_1608Metric
C12: 4.7uF; C_0603_1608Metric
D2, D3: MBR60; TO-220-3_Horizontal_TabDown
D4, D5: D; D_SOD-523
JP1: Jumper_NO_Small; PinHeader_1x02_P2.54mm_Vertical
JP2, JP3, JP4, JP5: SolderJumper_2_Open; SolderJumper-2_P1.3mm_Open_TrianglePad1.0x1.5mm
ON/OFF1: Conn_01x06_Male; 66200621022
Q1, Q2, Q3, Q6, Q7: Q_NMOS_GSD; SOT-23
Q4, Q5: Si7997DP; PowerPak-SO8_5.15x6.15mm_Pitch1.27mm_Dual
R10, R14, R16, R17, R18, R21, R22, R23: 10k; R_0603_1608Metric
R11, R15, R20: 330; R_0603_1608Metric
R12, R13, R26: 4.7k; R_0603_1608Metric
R19: 1k; R_0603_1608Metric
R24, R25: 78.7k; R_0603_1608Metric
RASPY1: Conn_01x06_Male; 66200621022
RSHUNT1: 0.002; R_2512_6332Metric_Pad1.52x3.35mm_HandSolder
U1: SN74LVC2G02DCUR; VSSOP-8_2.3x2mm_P0.5mm
U2: LTC2952IF#PBF; TSSOP-20_4.4x6.5mm_P0.65mm
U3: TPS3808DBV; SOT-23-6
U4: NCP718xSN330; SOT-23-5
U5: INA219AxD; TSOT-23-8
U6: NE555D; SOIC-8_3.9x4.9mm_P1.27mm

Connections:
+3.3VA: C8.1, C9.1, C10.1, JP2.2 (B), JP5.2 (B), R12.2, R13.2, R16.2, R17.2, R18.2, R19.1, R21.2, R22.2, R24.2, U1.8, U3.5 (SENSE), U3.6 (VDD), U5.5 (VS), U6.4 (R), U6.8 (VCC); also elsewhere on the board
/Input/BLUE: ON/OFF1.4, R15.2; also elsewhere on the board
/Input/G1S: Q3.1 (G), R17.1, U1.5, U2.20 (G1S)
/Input/GREEN: ON/OFF1.3, R11.2; also elsewhere on the board
/Input/RED: ON/OFF1.2, R20.2; also elsewhere on the board
/Input/TRIG: C12.2, R25.1, U6.2 (TR), U6.6 (THR)
/Input/VCC1: BATT1.1, D2.2, Q5.6 (S), U2.18 (V1); also elsewhere on the board
/Input/VCC2: ALIM1.1, D3.2, Q4.5 (S), U2.16 (V2); also elsewhere on the board
/Input/~BLINK: D4.1 (K), U6.3 (Q)
/Input/~KILL: Q7.3 (D), R23.1, R26.2, U2.3 (~KILL)
/Input/~PB: ON/OFF1.6, U2.7 (~PB); also elsewhere on the board
/SCL: R13.1, RASPY1.3, U5.4 (SCL); also elsewhere on the board
/SDA: R12.1, RASPY1.2, U5.3 (SDA); also elsewhere on the board
/~INT: R16.1, RASPY1.4, U2.13 (~INT~); also elsewhere on the board
/~ON_BATT: Q3.3 (D), R18.1, U1.1; also elsewhere on the board
/~PH: D5.1 (K), JP1.1, R21.1, RASPY1.5, U1.2, U1.6, U3.3 (~MR); also elsewhere on the board
GND: ALIM1.2, BATT1.2, C1.1, C2.1, C3.1, C4.2, C5.2, C6.1, C7.1, C8.2, C9.2, C10.2, C11.2, C12.1, D2.1, D2.3, D3.1, D3.3, JP1.2, JP3.1 (A), JP4.1 (A), ON/OFF1.5, Q1.2 (S), Q2.2 (S), Q3.2 (S), Q6.2 (S), Q7.2 (S), R10.1, R14.1, R26.1, RASPY1.6, U1.4, U2.4 (VM), U2.5 (PFI), U2.12 (GND), U3.2 (GND), U4.2 (GND), U5.6 (GND), U6.1 (GND); also elsewhere on the board
unnamed: C1.2, C2.2, U2.10 (ONT)
unnamed: C3.2, U2.11 (OFFT)
unnamed: C4.1, Q4.6 (S), Q5.5 (S), RSHUNT1.2, U2.17 (VS), U5.8 (IN+)
unnamed: C6.2, U6.5 (CV)
unnamed: C7.2, U3.4 (CT)
unnamed: C11.1, JP5.1 (A), U4.5 (OUT)
unnamed: D4.2 (A), D5.2 (A), Q6.1 (G), R19.2
unnamed 40: JP2.1 (A), RASPY1.1; also elsewhere on the board
unnamed: JP3.2 (B), U5.1 (A1)
unnamed: JP4.2 (B), U5.2 (A0)
unnamed: Q1.1 (G), R10.2, U1.7
unnamed: Q1.3 (D), R11.1
unnamed: Q2.1 (G), R14.2, U1.3
unnamed: Q2.3 (D), R15.1
unnamed: Q4.1 (D), Q4.3 (D)
unnamed: Q4.2 (G), Q4.4 (G), U2.15 (G2)
unnamed: Q5.1 (D), Q5.3 (D)
unnamed: Q5.2 (G), Q5.4 (G), U2.19 (G1)
unnamed: Q6.3 (D), R20.1
unnamed: Q7.1 (G), R22.1, U3.1 (~RESET)
unnamed: R24.1, R25.2, U6.7 (DIS)
unnamed: U2.1 (M1), U2.2 (M2)
VCC: C5.1, ON/OFF1.1, R23.2, RSHUNT1.1, U4.1 (IN), U4.3 (EN), U5.7 (IN-); also elsewhere on the board

Notes on the sheet:
May need 10nF (to test)
Power inputs
Switches
Raspy connector
Power Input Selector
Blinking signal generation
Signal delayer
This board was designed for: - Controlling the power input of the robot with a push button. - Select the power source between a battery or an external alimentation.
The push button is also managed by the LTC2952. To turn on the robot, press the push button 2s. If the Raspberry hasn't turned on in 5s, the robot will turn off. To turn off the robot, there are 2 ways: - Press the push button less than 5s. The Raspberry Pi will confirm the shutdown and the robot w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
The power source selection system use a LTC2952. By default, the LTC2952 is in ideal diode mode, so it will choose automatically the power source by comparing the voltage. We can override the ideal diode mode using a 3 state switch to select manually the power source.
The selected push button has 3 leds (Red, Green and Blue). - It will blink red when the system is turning on and off. - It will be green when the selected power source is the battery. - It will be blue when the selected power source is the external alimentation.
TODO Reset ?
An INA219 is used to measure the output current/voltage.
The power sources are protected with: - A fuse (20-30A) - A diode to prevent polarization inversion.
JP1 is used if you don't connect a Raspberry
Important signals: - VCC1/VCC2: Input power (14-18V). - VCC: Output power (14-18V). - SDA/SLC: INA219 I2C (3.3V). - ~INT: output signal of the LT2952 when the push button was pressed. - ~PH: output signal of the Raspberry if we need to hold the power. - ~KILL: delayed signal of ~PH. - ~Blink: blink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
A fuse is present on each power input ahead
Current/Voltage measure
3.3V Regulation
Red led truth table /PH /Bl O 0 0 0 0 1 0 1 0 0 1 1 1
Leds
Green and Blue led truth table /PH /G1S O 0 0 1 0 1 0 1 0 0 1 1 0
List of ICs: - LTC2952: : power source selector and push button controller. - NCP718: 3.3V regulator. - TSP3808: current supervisor used for delaying shutdown delay. - NE55: precision timer used for blinking the red led.
Labels
3.3V

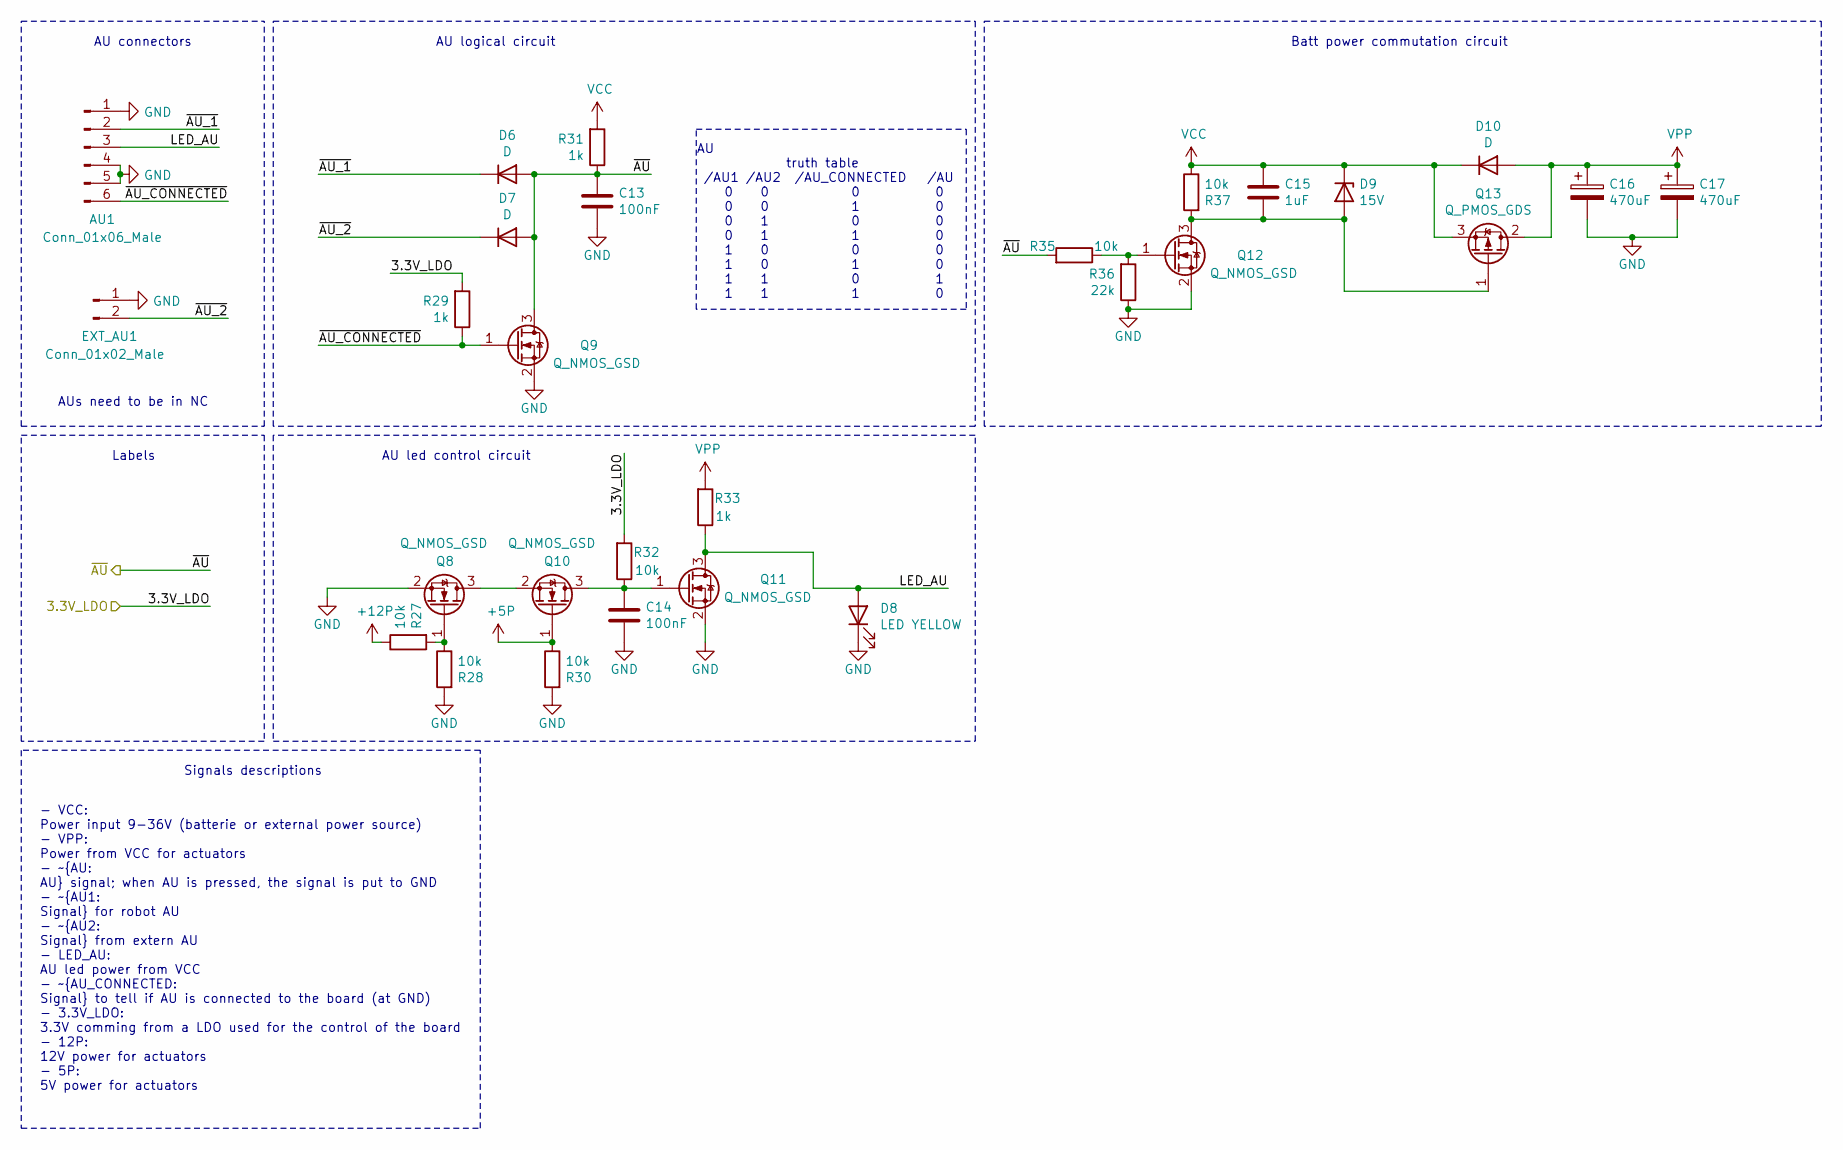
[picture p72: schematic AU.sch, Carte d'alimentation]

Parts:
AU1: Conn_01x06_Male; 66200621022
C13, C14: 100nF; C_0603_1608Metric
C15: 1uF; C_0603_1608Metric
C16, C17: 470uF; CP_Radial_D10.0mm_P5.00mm
D6, D7: D; D_SOD-523
D8: LED YELLOW; LED_0805_2012Metric
D9: 15V; D_SOD-523
D10: D; D_SMC
EXT_AU1: Conn_01x02_Male; 66200221022
Q8, Q9, Q10, Q11, Q12: Q_NMOS_GSD; SOT-23
Q13: Q_PMOS_GDS; TO-252-2
R27, R28, R30, R32, R35, R37: 10k; R_0603_1608Metric
R29, R31, R33: 1k; R_0603_1608Metric
R36: 22k; R_0603_1608Metric

Connections:
+3.3VA: R29.2, R32.2; also elsewhere on the board
+5P: Q10.1 (G), R30.1; also elsewhere on the board
+12P: R27.1; also elsewhere on the board
/AU/LED_AU: AU1.3, D8.2 (A), Q11.3 (D), R33.1; also elsewhere on the board
/AU/~AU_1: AU1.2, D6.1 (K); also elsewhere on the board
/AU/~AU_2: D7.1 (K), EXT_AU1.2; also elsewhere on the board
/AU/~AU_CONNECTED: AU1.6, Q9.1 (G), R29.1; also elsewhere on the board
/~AU: C13.1, D6.2 (A), D7.2 (A), Q9.3 (D), R31.1, R35.2; also elsewhere on the board
GND: AU1.1, AU1.4, AU1.5, C13.2, C14.2, C16.2, C17.2, D8.1 (K), EXT_AU1.1, Q8.2 (S), Q9.2 (S), Q11.2 (S), Q12.2 (S), R28.2, R30.2, R36.1; also elsewhere on the board
unnamed: C14.1, Q10.3 (D), Q11.1 (G), R32.1
unnamed: C15.2, D9.2 (A), Q12.3 (D), Q13.1 (G), R37.2
unnamed: Q8.1 (G), R27.2, R28.1
unnamed: Q8.3 (D), Q10.2 (S)
unnamed: Q12.1 (G), R35.1, R36.2
VCC: C15.1, D9.1 (K), D10.1 (K), Q13.3 (S), R31.2, R37.1; also elsewhere on the board
VPP: C16.1, C17.1, D10.2 (A), Q13.2 (D), R33.2; also elsewhere on the board

Notes on the sheet:
Labels
AU connectors
AU logical circuit
AU led control circuit
Batt power commutation circuit
Signals descriptions
- VCC: Power input 9-36V (batterie or external power source) - VPP: Power from VCC for actuators - ~AU: AU signal; when AU is pressed, the signal is put to GND - ~AU1: Signal for robot AU - ~AU2: Signal from extern AU - LED_AU: AU led power from VCC - ~AU_CONNECTED: Signal to tell if AU is connecte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
AUs need to be in NC
AU truth table /AU1 /AU2 /AU_CONNECTED /AU 0 0 0 0 0 0 1 0 0 1 0 0 0 1 1 0 1 0 0 0 1 0 1 0 1 1 0 1 1 1 1 0

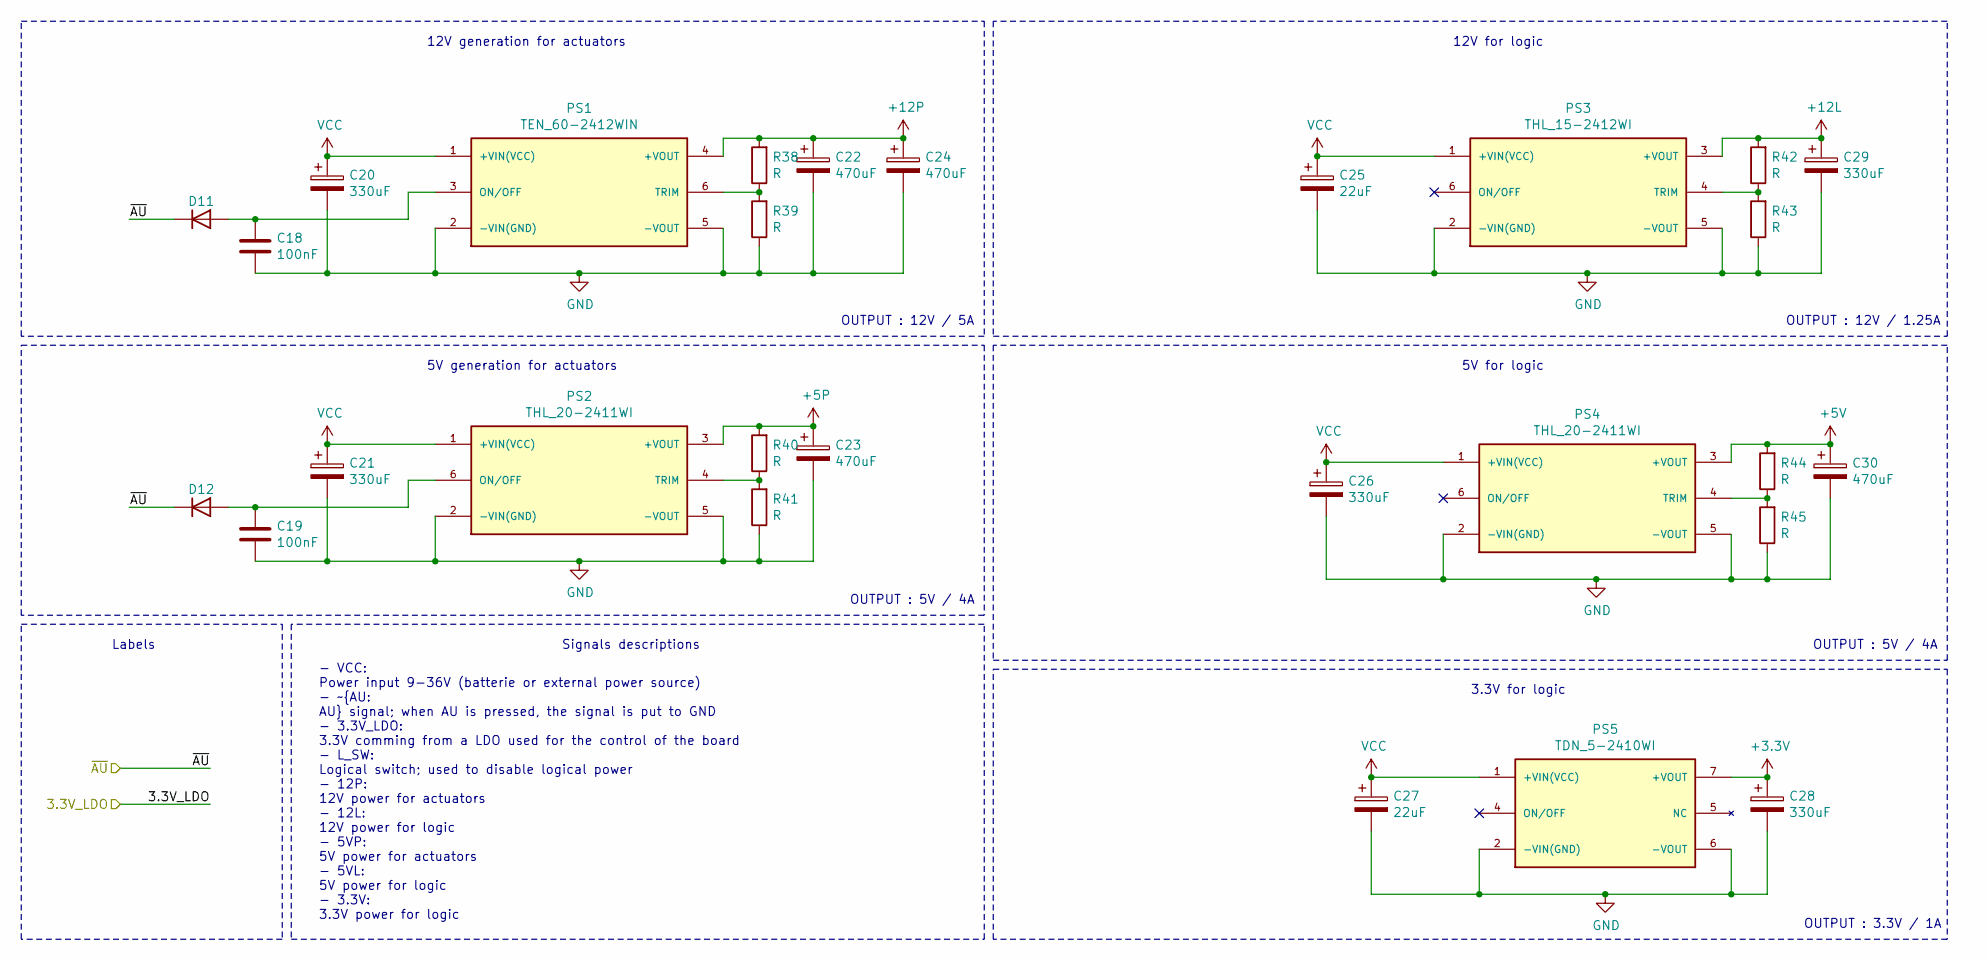
[picture p73: schematic Converters.sch, Carte d'alimentation]

Parts:
C18, C19: 100nF; C_0603_1608Metric
C20, C21, C26, C28, C29: 330uF; CP_Radial_D10.0mm_P5.00mm
C22, C23, C24, C30: 470uF; CP_Radial_D10.0mm_P5.00mm
C25, C27: 22uF; CP_Radial_D10.0mm_P5.00mm
D11, D12: D; D_SOD-523
PS1: TEN_60-2412WIN; TRACO_CONV_TEN; PARTREV January 27, 2021
PS2, PS4: THL_20-2411WI; TRACO_CONV_THL; PARTREV Jan 18, 2021
PS3: THL_15-2412WI; TRACO_CONV_THL; PARTREV Jan 18, 2021
PS5: TDN_5-2410WI; TRACO_CONV_TDN; PARTREV May 18, 2020
R38, R39, R40, R41, R42, R43, R44, R45: R; R_0603_1608Metric

Connections:
+3V3: C28.1, PS5.7 (+VOUT); also elsewhere on the board
+5P: C23.1, PS2.3 (+VOUT), R40.2; also elsewhere on the board
+5V: C30.1, PS4.3 (+VOUT), R44.2; also elsewhere on the board
+12L: C29.1, PS3.3 (+VOUT), R42.2; also elsewhere on the board
+12P: C22.1, C24.1, PS1.4 (+VOUT), R38.2; also elsewhere on the board
/~AU: D11.1 (K), D12.1 (K); also elsewhere on the board
GND: C18.2, C19.2, C20.2, C21.2, C22.2, C23.2, C24.2, C25.2, C26.2, C27.2, C28.2, C29.2, C30.2, PS1.2 (-VIN(GND)), PS1.5 (-VOUT), PS2.2 (-VIN(GND)), PS2.5 (-VOUT), PS3.2 (-VIN(GND)), PS3.5 (-VOUT), PS4.2 (-VIN(GND)), PS4.5 (-VOUT), PS5.2 (-VIN(GND)), PS5.6 (-VOUT), R39.1, R41.1, R43.1, R45.1; also elsewhere on the board
unnamed: C18.1, D11.2 (A), PS1.3 (ON/OFF)
unnamed: C19.1, D12.2 (A), PS2.6 (ON/OFF)
unnamed: PS1.6 (TRIM), R38.1, R39.2
unnamed: PS2.4 (TRIM), R40.1, R41.2
unnamed: PS3.4 (TRIM), R42.1, R43.2
unnamed: PS4.4 (TRIM), R44.1, R45.2
VCC: C20.1, C21.1, C25.1, C26.1, C27.1, PS1.1 (+VIN(VCC)), PS2.1 (+VIN(VCC)), PS3.1 (+VIN(VCC)), PS4.1 (+VIN(VCC)), PS5.1 (+VIN(VCC)); also elsewhere on the board

Notes on the sheet:
Labels
12V for logic
5V for logic
3.3V for logic
OUTPUT : 5V / 4A
OUTPUT : 12V / 1.25A
OUTPUT : 3.3V / 1A
Signals descriptions
- VCC: Power input 9-36V (batterie or external power source) - ~AU: AU signal; when AU is pressed, the signal is put to GND - 3.3V_LDO: 3.3V comming from a LDO used for the control of the board - L_SW: Logical switch; used to disable logical power - 12P: 12V power for actuators - 12L: 12V power for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
OUTPUT : 12V / 5A
5V generation for actuators
12V generation for actuators

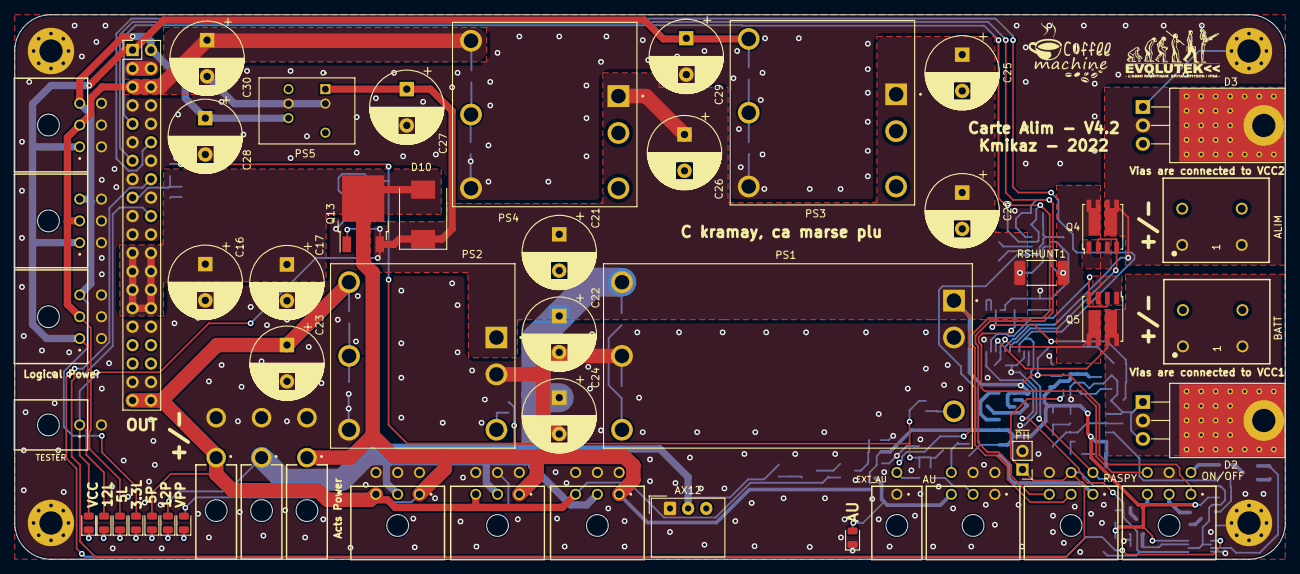
[picture p74: board V4/Carte Alim.kicad_pcb from above]

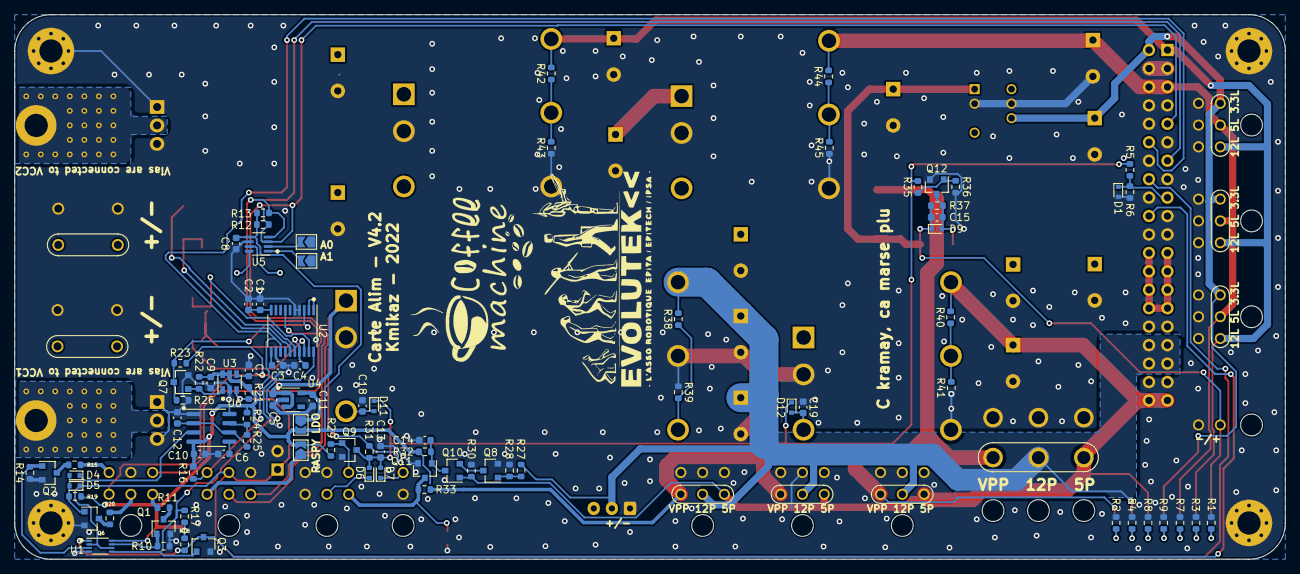
[picture p75: board V4/Carte Alim.kicad_pcb from below]

Board: 2 copper layers, 175.0 x 75.0 mm, 144 parts (89 on the bottom side), 70 nets.

Other parts of the board:
ALIM: Conn_01x02_Male; 691406710002B
AU: Conn_01x06_Male; 66200621022
BATT: Conn_01x02_Male; 691406710002B
EXT_AU: Conn_01x02_Male; 66200221022
ON/OFF: Conn_01x06_Male; 66200621022
RASPY: Conn_01x06_Male; 66200621022
TESTER: Conn_01x02_Male; 66200221022

Their connections:
/AU/LED_AU: AU.3; also elsewhere on the board
/AU/~AU_1: AU.2; also elsewhere on the board
/AU/~AU_2: EXT_AU.2; also elsewhere on the board
/AU/~AU_CONNECTED: AU.6; also elsewhere on the board
/Input/BLUE: ON/OFF.4; also elsewhere on the board
/Input/GREEN: ON/OFF.3; also elsewhere on the board
/Input/RED: ON/OFF.2; also elsewhere on the board
/Input/VCC1: BATT.1; also elsewhere on the board
/Input/VCC2: ALIM.1; also elsewhere on the board
/Input/~PB: ON/OFF.6; also elsewhere on the board
/SCL: RASPY.3; also elsewhere on the board
/SDA: RASPY.2; also elsewhere on the board
/~INT: RASPY.4; also elsewhere on the board
/~PH: RASPY.5; also elsewhere on the board
GND: ALIM.2, AU.1, AU.4, AU.5, BATT.2, EXT_AU.1, ON/OFF.5, RASPY.6, TESTER.2; also elsewhere on the board
unnamed 40: RASPY.1; also elsewhere on the board
VCC: ON/OFF.1, TESTER.1; also elsewhere on the board
