evolutek/carte-alim/PCB V2/Power Commuter Board V2.kicad_pcb

## KiCad design PCB V2/Power Commuter Board V2.kicad_pcb (2021-12-07)

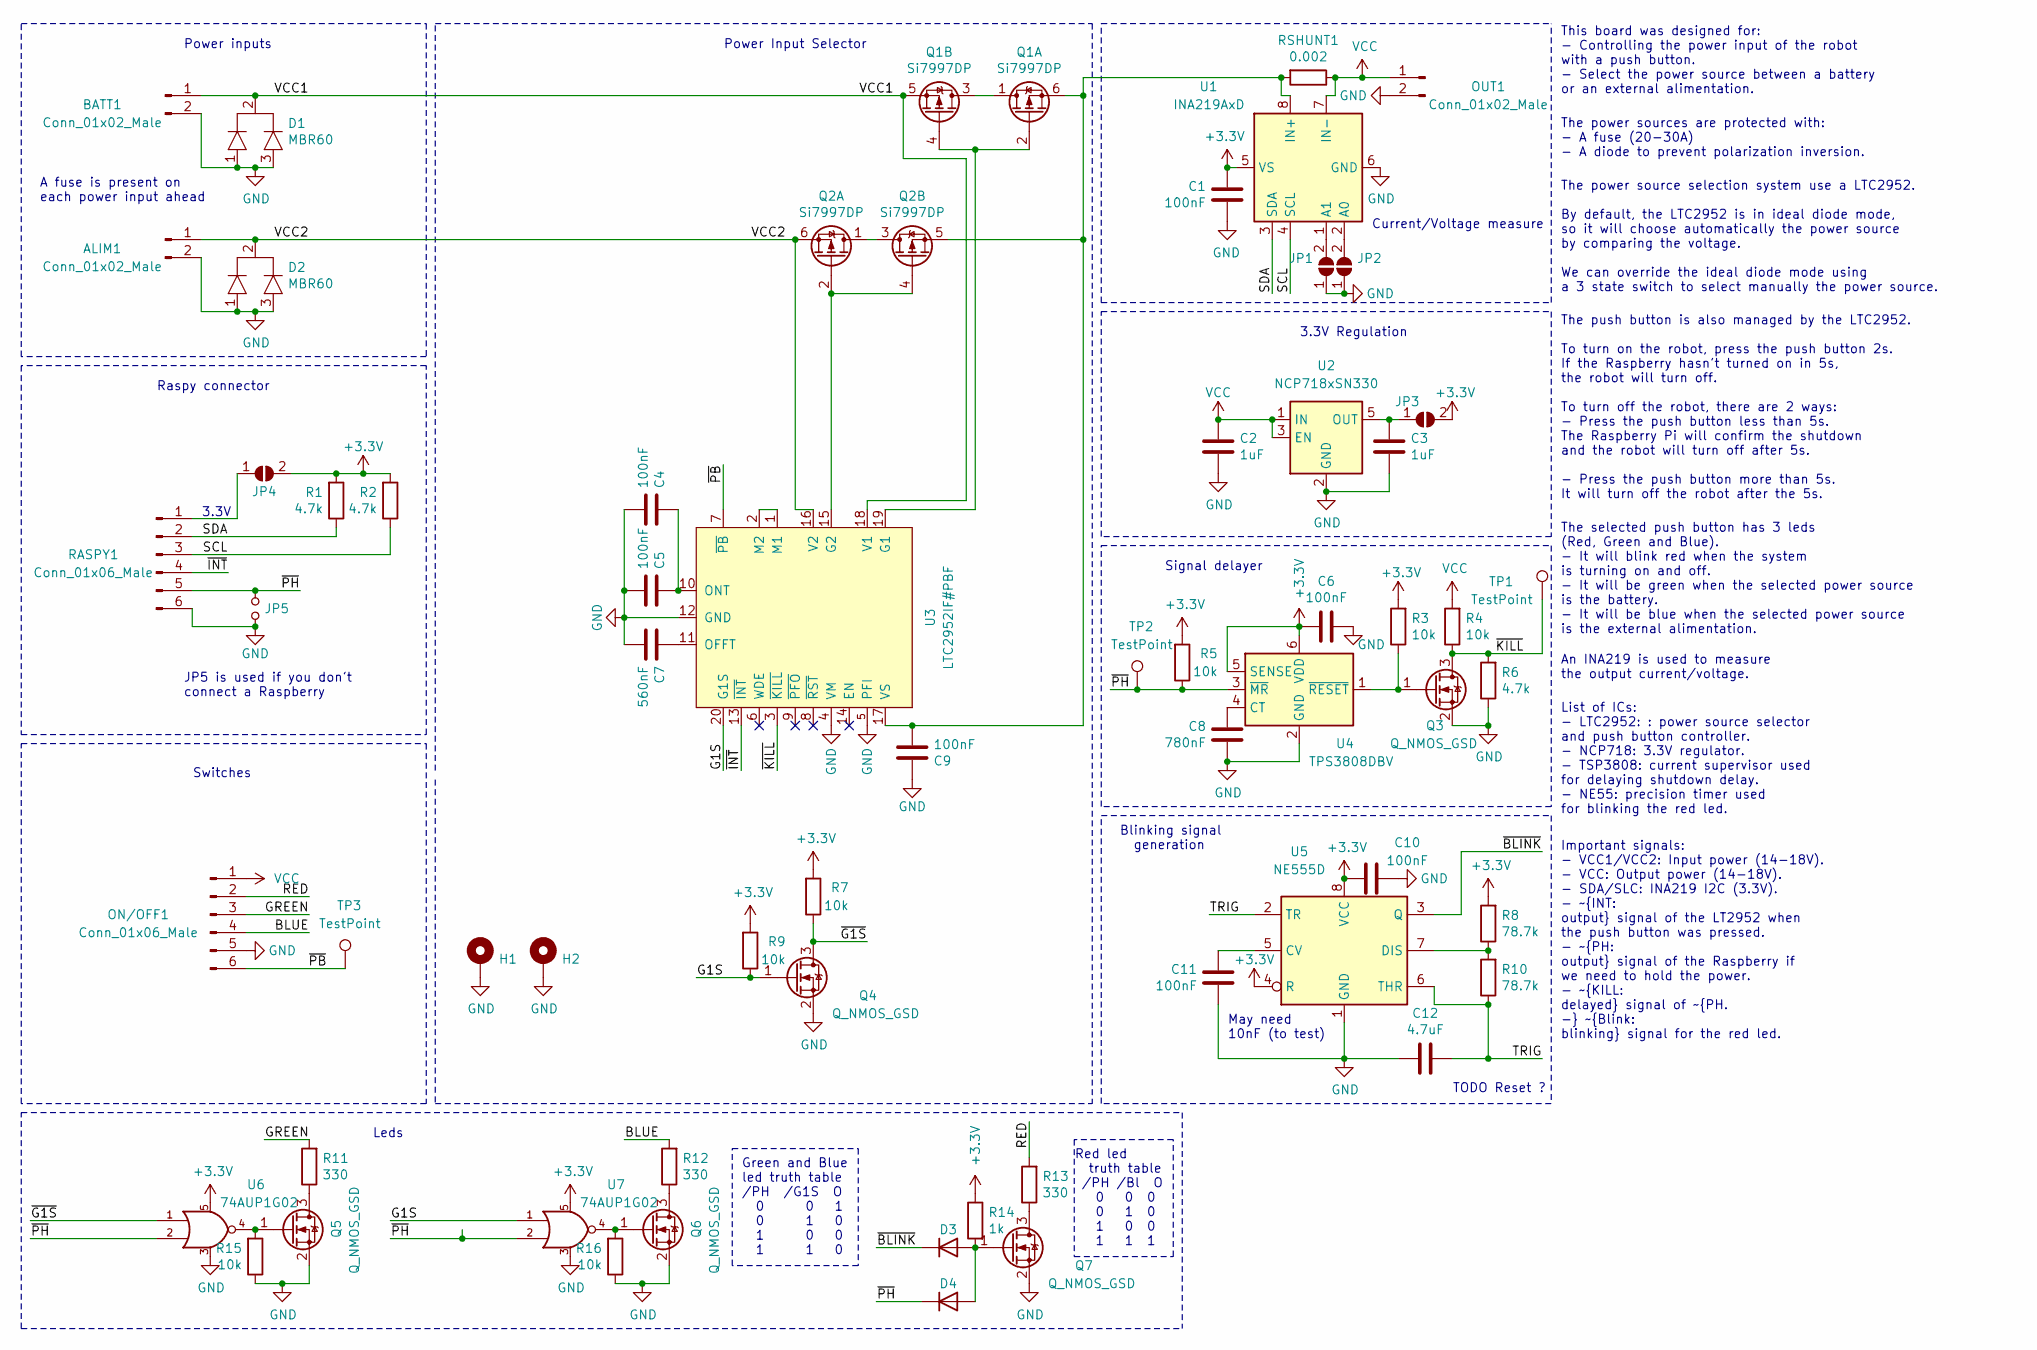
[picture p76: schematic Power Commuter Board V2.sch, Power Commuter Board]

Parts:
ALIM1: Conn_01x02_Male; 691406710002B
BATT1: Conn_01x02_Male; 691406710002B
C1, C4, C5, C6, C9, C10, C11: 100nF; C_0603_1608Metric
C2, C3: 1uF; C_0603_1608Metric
C7: 560nF; C_0603_1608Metric
C8: 780nF; C_0603_1608Metric
C12: 4.7uF; C_0603_1608Metric
D1, D2: MBR60; TO-220-3_Horizontal_TabDown
D3, D4: D; D_SOD-523
H1, H2: MountingHole_Pad; MountingHole_3.2mm_M3_Pad_Via
JP1, JP2, JP3, JP4: SolderJumper_2_Open; SolderJumper-2_P1.3mm_Open_TrianglePad1.0x1.5mm
JP5: Jumper_NO_Small; PinHeader_1x02_P2.54mm_Vertical
ON/OFF1: Conn_01x06_Male; 66200621022
OUT1: Conn_01x02_Male; 691406710002B
Q1, Q2: Si7997DP; PowerPak-SO8_5.15x6.15mm_Pitch1.27mm_Dual
Q3, Q4, Q5, Q6, Q7: Q_NMOS_GSD; SOT-23
R1, R2, R6: 4.7k; R_0603_1608Metric
R3, R4, R5, R7, R9, R15, R16: 10k; R_0603_1608Metric
R8, R10: 78.7k; R_0603_1608Metric
R11, R12, R13: 330; R_0603_1608Metric
R14: 1k; R_0603_1608Metric
RASPY1: Conn_01x06_Male; 66200621022
RSHUNT1: 0.002; R_2512_6332Metric_Pad1.52x3.35mm_HandSolder
TP1, TP2, TP3: TestPoint; TestPoint_Pad_D1.5mm
U1: INA219AxD; TSOT-23-8
U2: NCP718xSN330; SOT-23-5
U3: LTC2952IF#PBF; TSSOP-20_4.4x6.5mm_P0.65mm
U4: TPS3808DBV; SOT-23-6
U5: NE555D; SOIC-8_3.9x4.9mm_P1.27mm
U6, U7: 74AUP1G02; SOT-353_SC-70-5

Connections:
+3V3: C1.1, C6.1, C10.1, JP3.2 (B), JP4.2 (B), R1.2, R2.2, R3.2, R5.2, R7.2, R8.2, R9.2, R14.1, U1.5 (VS), U4.5 (SENSE), U4.6 (VDD), U5.4 (R), U5.8 (VCC), U6.5, U7.5
/BLUE: ON/OFF1.4, R12.2; also elsewhere on the board
/G1S: Q4.1 (G), R9.1, U3.20 (G1S), U7.1
/GREEN: ON/OFF1.3, R11.2; also elsewhere on the board
/RED: ON/OFF1.2, R13.2; also elsewhere on the board
/SCL: R2.1, RASPY1.3, U1.4 (SCL); also elsewhere on the board
/SDA: R1.1, RASPY1.2, U1.3 (SDA); also elsewhere on the board
/TRIG: C12.2, R10.1, U5.2 (TR), U5.6 (THR)
/VCC1: BATT1.1, D1.2, Q1.5 (S), U3.18 (V1); also elsewhere on the board
/VCC2: ALIM1.1, D2.2, Q2.6 (S), U3.16 (V2); also elsewhere on the board
/~BLINK: D3.1 (K), U5.3 (Q)
/~G1S: Q4.3 (D), R7.1, U6.1
/~INT: RASPY1.4, U3.13 (~INT~); also elsewhere on the board
/~KILL: Q3.3 (D), R4.1, R6.2, TP1.1, U3.3 (~KILL)
/~PB: ON/OFF1.6, TP3.1, U3.7 (~PB); also elsewhere on the board
/~PH: D4.1 (K), JP5.1, R5.1, RASPY1.5, TP2.1, U4.3 (~MR), U6.2, U7.2; also elsewhere on the board
GND: ALIM1.2, BATT1.2, C1.2, C2.2, C3.2, C4.1, C5.1, C6.2, C7.1, C8.1, C9.2, C10.2, C11.1, C12.1, D1.1, D1.3, D2.1, D2.3, H1.1, H2.1, JP1.1 (A), JP2.1 (A), JP5.2, ON/OFF1.5, OUT1.2, Q3.2 (S), Q4.2 (S), Q5.2 (S), Q6.2 (S), Q7.2 (S), R6.1, R15.1, R16.1, RASPY1.6, U1.6 (GND), U2.2 (GND), U3.4 (VM), U3.5 (PFI), U3.12 (GND), U4.2 (GND), U5.1 (GND), U6.3, U7.3; also elsewhere on the board
unnamed: C3.1, JP3.1 (A), U2.5 (OUT)
unnamed: C4.2, C5.2, U3.10 (ONT)
unnamed: C7.2, U3.11 (OFFT)
unnamed: C8.2, U4.4 (CT)
unnamed: C9.1, Q1.6 (S), Q2.5 (S), RSHUNT1.2, U1.8 (IN+), U3.17 (VS)
unnamed: C11.2, U5.5 (CV)
unnamed: D3.2 (A), D4.2 (A), Q7.1 (G), R14.2
unnamed: JP1.2 (B), U1.1 (A1)
unnamed: JP2.2 (B), U1.2 (A0)
unnamed 26: JP4.1 (A), RASPY1.1; also elsewhere on the board
unnamed: Q1.1 (D), Q1.3 (D)
unnamed: Q1.2 (G), Q1.4 (G), U3.19 (G1)
unnamed: Q2.1 (D), Q2.3 (D)
unnamed: Q2.2 (G), Q2.4 (G), U3.15 (G2)
unnamed: Q3.1 (G), R3.1, U4.1 (~RESET)
unnamed: Q5.1 (G), R15.2, U6.4
unnamed: Q5.3 (D), R11.1
unnamed: Q6.1 (G), R16.2, U7.4
unnamed: Q6.3 (D), R12.1
unnamed: Q7.3 (D), R13.1
unnamed: R8.1, R10.2, U5.7 (DIS)
unnamed: U3.1 (M1), U3.2 (M2)
VCC: C2.1, ON/OFF1.1, OUT1.1, R4.2, RSHUNT1.1, U1.7 (IN-), U2.1 (IN), U2.3 (EN); also elsewhere on the board

Notes on the sheet:
May need 10nF (to test)
Power inputs
Switches
Raspy connector
Power Input Selector
3.3V
Blinking signal generation
Signal delayer
This board was designed for: - Controlling the power input of the robot with a push button. - Select the power source between a battery or an external alimentation.
The push button is also managed by the LTC2952. To turn on the robot, press the push button 2s. If the Raspberry hasn't turned on in 5s, the robot will turn off. To turn off the robot, there are 2 ways: - Press the push button less than 5s. The Raspberry Pi will confirm the shutdown and the robot w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
The power source selection system use a LTC2952. By default, the LTC2952 is in ideal diode mode, so it will choose automatically the power source by comparing the voltage. We can override the ideal diode mode using a 3 state switch to select manually the power source.
The selected push button has 3 leds (Red, Green and Blue). - It will blink red when the system is turning on and off. - It will be green when the selected power source is the battery. - It will be blue when the selected power source is the external alimentation.
TODO Reset ?
An INA219 is used to measure the output current/voltage.
The power sources are protected with: - A fuse (20-30A) - A diode to prevent polarization inversion.
JP5 is used if you don't connect a Raspberry
Important signals: - VCC1/VCC2: Input power (14-18V). - VCC: Output power (14-18V). - SDA/SLC: INA219 I2C (3.3V). - ~INT: output signal of the LT2952 when the push button was pressed. - ~PH: output signal of the Raspberry if we need to hold the power. - ~KILL: delayed signal of ~PH. - ~Blink: blink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
A fuse is present on each power input ahead
Current/Voltage measure
3.3V Regulation
Red led truth table /PH /Bl O 0 0 0 0 1 0 1 0 0 1 1 1
Leds
Green and Blue led truth table /PH /G1S O 0 0 1 0 1 0 1 0 0 1 1 0
List of ICs: - LTC2952: : power source selector and push button controller. - NCP718: 3.3V regulator. - TSP3808: current supervisor used for delaying shutdown delay. - NE55: precision timer used for blinking the red led.

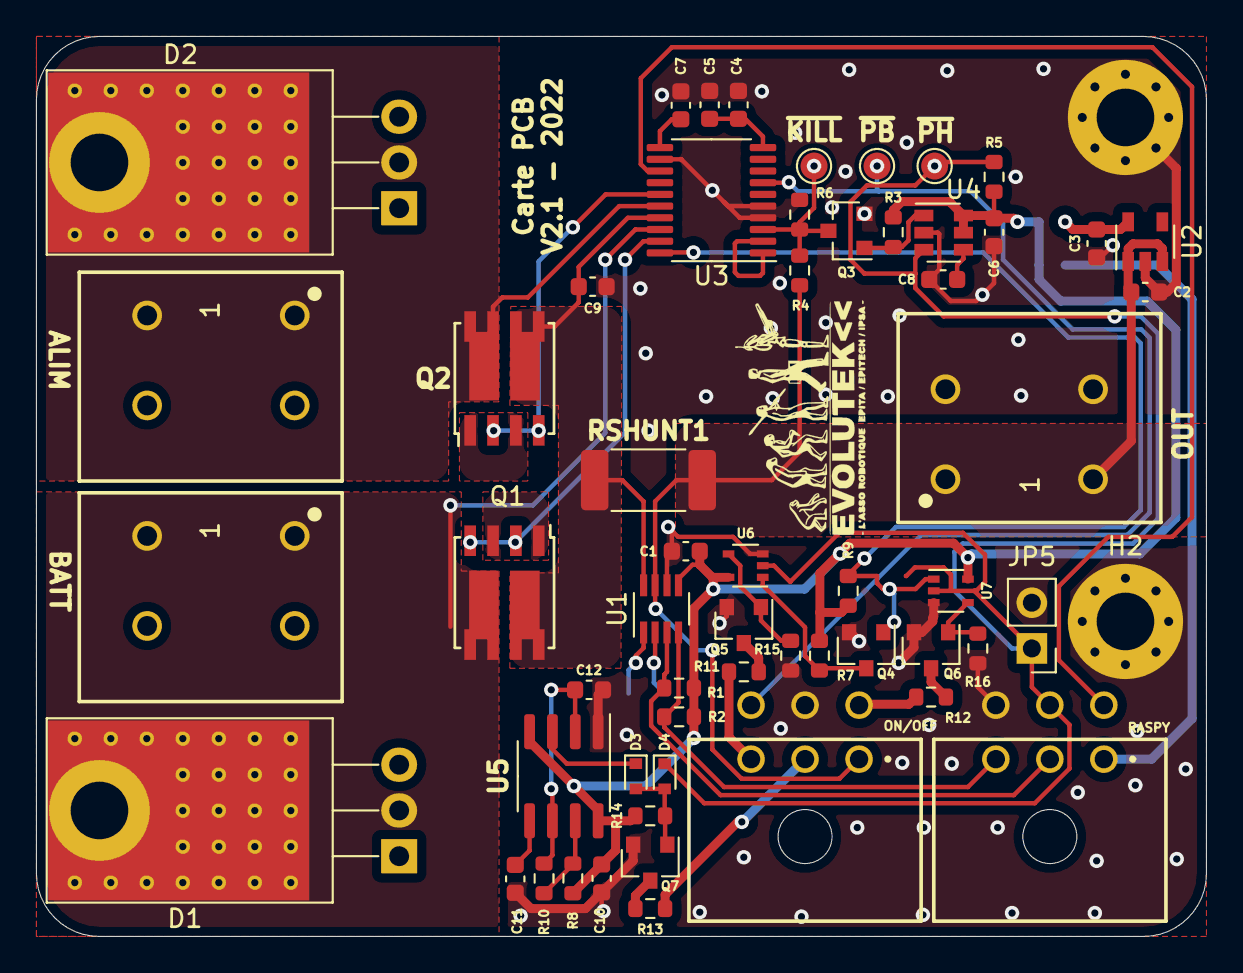
[picture p77: board Power Commuter Board V2.kicad_pcb from above]

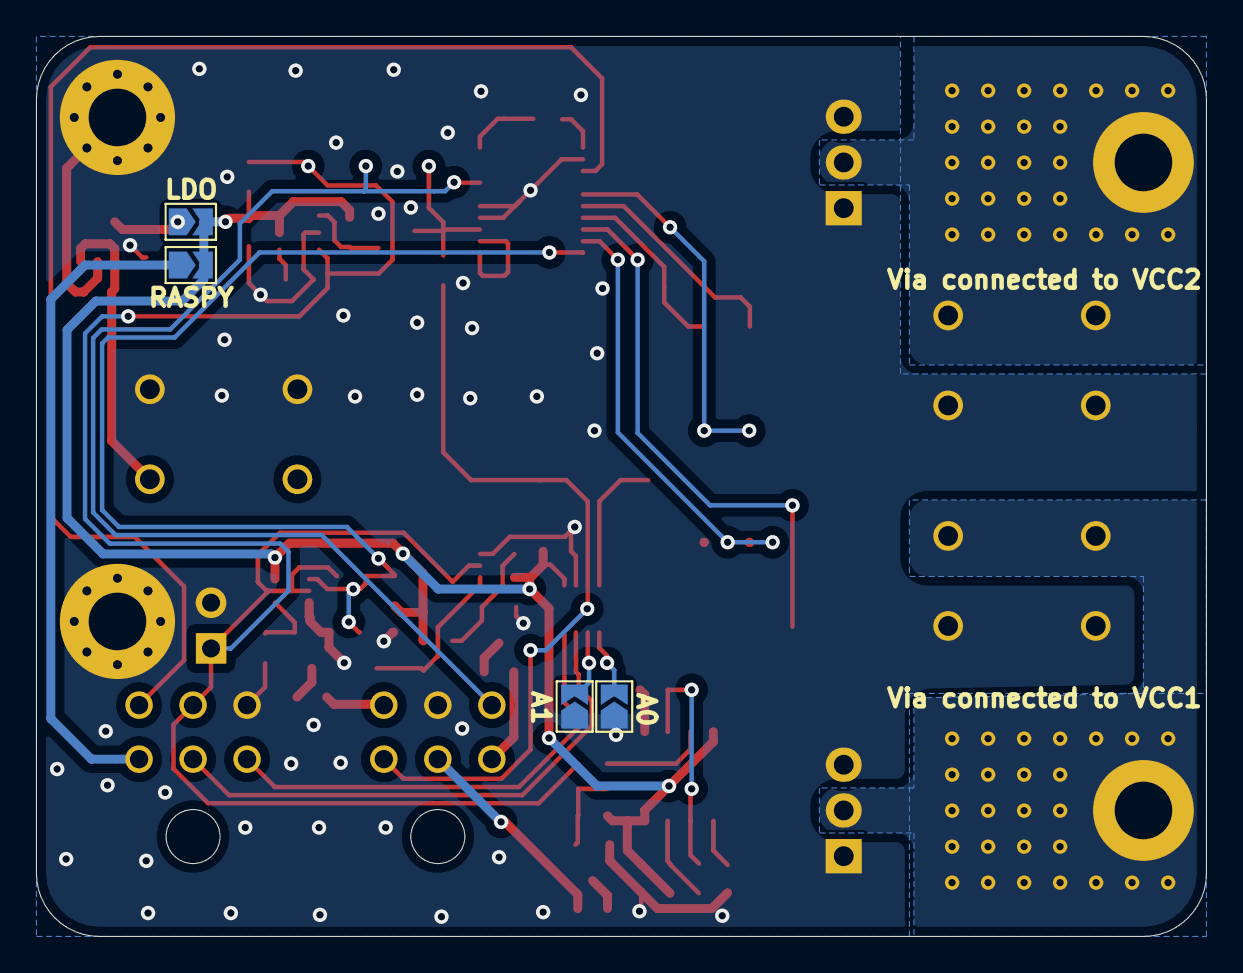
[picture p78: board Power Commuter Board V2.kicad_pcb from below]

Board: 2 copper layers, 65.0 x 50.0 mm, 62 parts (4 on the bottom side), 40 nets.

Other parts of the board:
ALIM: Conn_01x02_Male; 691406710002B
BATT: Conn_01x02_Male; 691406710002B
ON/OFF: Conn_01x06_Male; 66200621022
OUT: Conn_01x02_Male; 691406710002B
RASPY: Conn_01x06_Male; 66200621022

Their connections:
/BLUE: ON/OFF.4; also elsewhere on the board
/GREEN: ON/OFF.3; also elsewhere on the board
/RED: ON/OFF.2; also elsewhere on the board
/SCL: RASPY.3; also elsewhere on the board
/SDA: RASPY.2; also elsewhere on the board
/VCC1: BATT.1; also elsewhere on the board
/VCC2: ALIM.1; also elsewhere on the board
/~INT: RASPY.4; also elsewhere on the board
/~PB: ON/OFF.6; also elsewhere on the board
/~PH: RASPY.5; also elsewhere on the board
GND: ALIM.2, BATT.2, ON/OFF.5, OUT.2, RASPY.6; also elsewhere on the board
unnamed 26: RASPY.1; also elsewhere on the board
VCC: ON/OFF.1, OUT.1; also elsewhere on the board
