evolutek/carte-alim/Carte Rack Batterie Vertical V1/Carte Rack Batterie Vertical V1.kicad_pcb

## KiCad design Carte Rack Batterie Vertical V1/Carte Rack Batterie Vertical V1.kicad_pcb (2021-11-28)

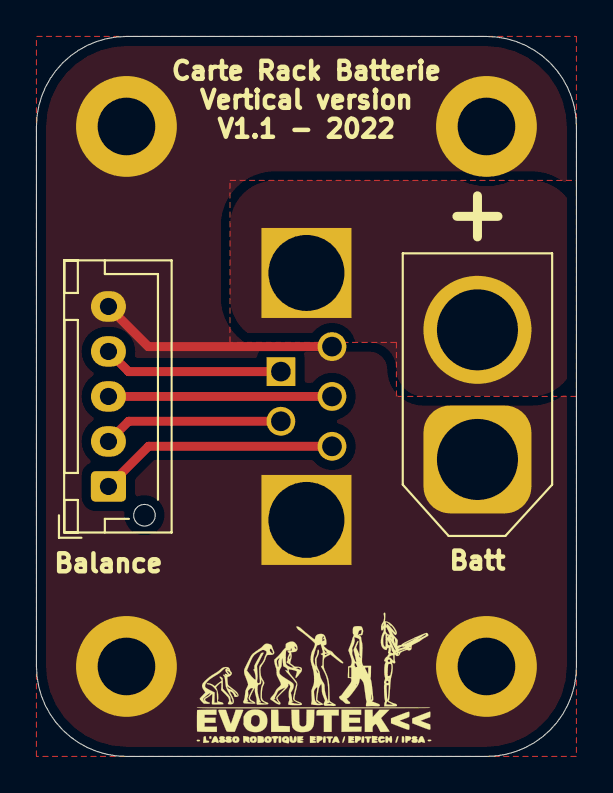
[picture p79: board Carte Rack Batterie Vertical V1.kicad_pcb from above]

Board: 2 copper layers, 30.0 x 40.0 mm, 3 parts (1 on the bottom side), 6 nets.

Parts:
Balance: Conn_01x05_Male; JST_XH_B5B-XH-AM_1x05_P2.50mm_Vertical
Batt: Conn_01x02_Male; AMASS_XT60-M_1x02_P7.20mm_Vertical
RackOut1: 7W2_sub-d_connector; 681M7W2103LYYY

Connections:
/BATT: Batt.2, RackOut1.A1
/C1: Balance.4, RackOut1.1
/C2: Balance.3, RackOut1.4
/C3: Balance.2, RackOut1.2
/C4: Balance.1, RackOut1.5
GND: Balance.5, Batt.1, RackOut1.3, RackOut1.A2
