evolutek/carte-alim/Carte Rack Batterie Horizontal V1/Carte Rack Batterie Horizontal V1.kicad_pcb

## KiCad design Carte Rack Batterie Horizontal V1/Carte Rack Batterie Horizontal V1.kicad_pcb (2021-10-25)

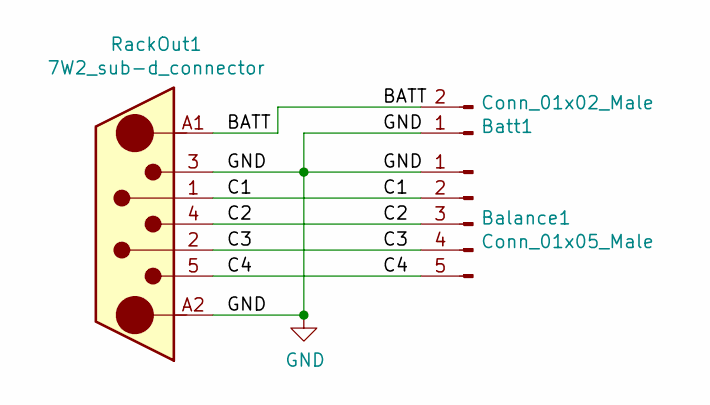
[picture p80: schematic Carte Rack Batterie Horizontal V1.sch, Carte Rack Batterie Horizontal]

Parts:
Balance1: Conn_01x05_Male; JST_XH_B5B-XH-AM_1x05_P2.50mm_Vertical
Batt1: Conn_01x02_Male; AMASS_XT60-M_1x02_P7.20mm_Vertical
RackOut1: 7W2_sub-d_connector; 684M7W2103L461

Connections:
/BATT: Batt1.2, RackOut1.A1
/C1: Balance1.2, RackOut1.1
/C2: Balance1.3, RackOut1.4
/C3: Balance1.4, RackOut1.2
/C4: Balance1.5, RackOut1.5
GND: Balance1.1, Batt1.1, RackOut1.3, RackOut1.A2

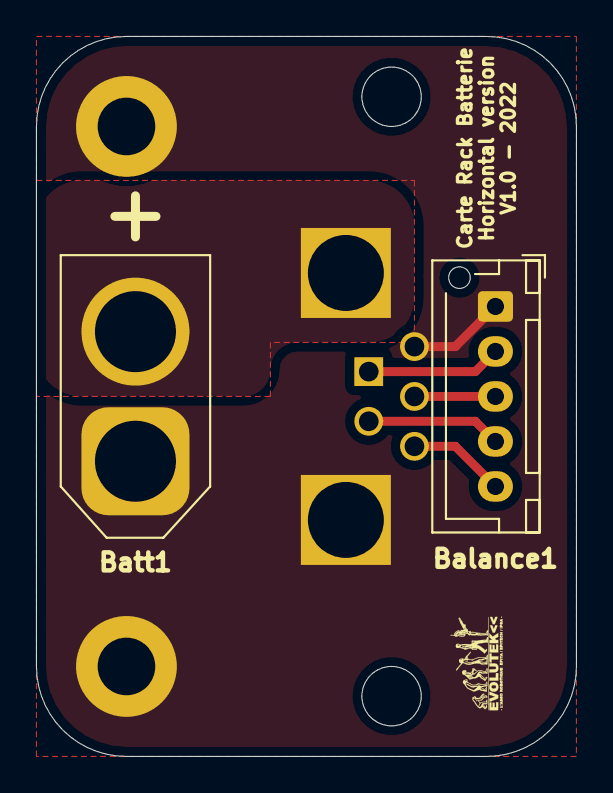
[picture p81: board Carte Rack Batterie Horizontal V1.kicad_pcb from above]

Board: 2 copper layers, 30.0 x 40.0 mm, 3 parts (1 on the bottom side), 6 nets.
