evolutek/carte-alim/PCB V1/Power Commuter Board V1.kicad_pcb

## KiCad design PCB V1/Power Commuter Board V1.kicad_pcb (2021-08-06, an earlier design)

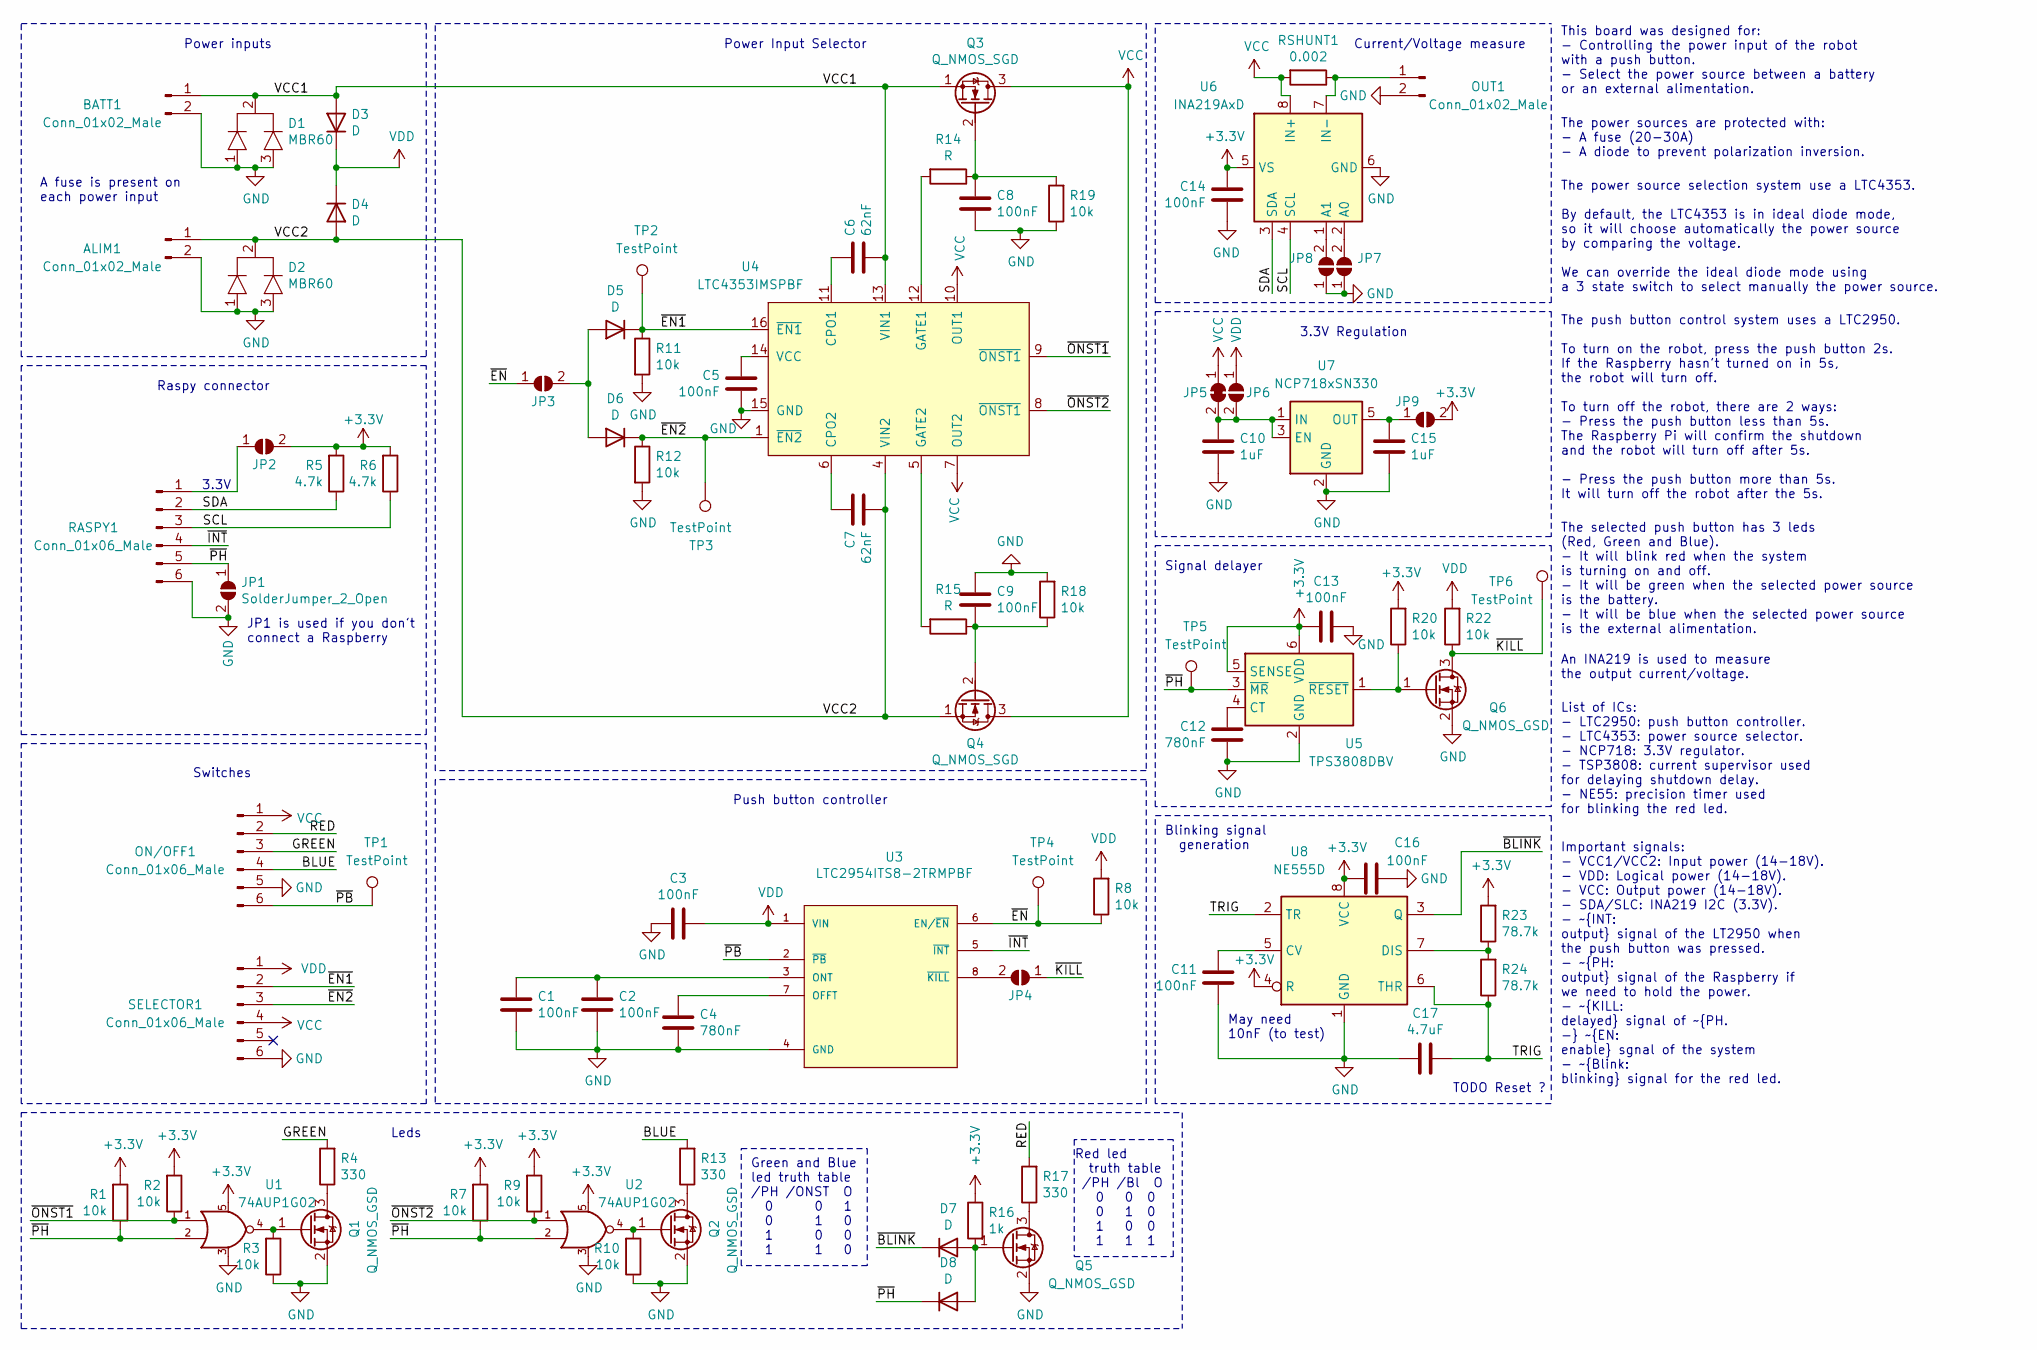
[picture p82: schematic Power Commuter Board V1.sch]

Parts:
ALIM1: Conn_01x02_Male; 691406710002B
BATT1: Conn_01x02_Male; 691406710002B
C1, C2, C3, C5, C8, C9, C11, C13, C14, C16: 100nF; C_0603_1608Metric
C4, C12: 780nF; C_0603_1608Metric
C6, C7: 62nF; C_0603_1608Metric
C10, C15: 1uF; C_0603_1608Metric
C17: 4.7uF; C_0603_1608Metric
D1, D2: MBR60; TO-220-3_Horizontal_TabDown
D3, D4, D5, D6, D7, D8: D; D_SOD-523
JP1, JP2, JP3, JP4, JP6, JP7, JP8, JP9: SolderJumper_2_Open; SolderJumper-2_P1.3mm_Open_TrianglePad1.0x1.5mm
JP5: SolderJumper_2_Bridged; SolderJumper-2_P1.3mm_Open_TrianglePad1.0x1.5mm
ON/OFF1: Conn_01x06_Male; 66200621022
OUT1: Conn_01x02_Male; 691406710002B
Q1, Q2, Q5, Q6: Q_NMOS_GSD; SOT-23
Q3, Q4: Q_NMOS_SGD; PowerPak-SO8_5.15x6.15mm_Pitch1.27mm
R1, R2, R3, R7, R8, R9, R10, R11, R12, R18, R19, R20, R22: 10k; R_0603_1608Metric
R4, R13, R17: 330; R_0603_1608Metric
R5, R6: 4.7k; R_0603_1608Metric
R14, R15: R; R_0603_1608Metric
R16: 1k; R_0603_1608Metric
R23, R24: 78.7k; R_0603_1608Metric
RASPY1: Conn_01x06_Male; 66200621022
RSHUNT1: 0.002; R_2512_6332Metric_Pad1.52x3.35mm_HandSolder
SELECTOR1: Conn_01x06_Male; 66200621022
TP1, TP2, TP3, TP4, TP5, TP6: TestPoint; TestPoint_Pad_D1.5mm
U1, U2: 74AUP1G02; SOT-353_SC-70-5
U3: LTC2954ITS8-2TRMPBF; SOT-23-8; MPN LTC2950ITS8-2#TRMPBF
U4: LTC4353IMSPBF; MSOP-16_3x4.039mm_P0.5mm
U5: TPS3808DBV; SOT-23-6
U6: INA219AxD; TSOT-23-8
U7: NCP718xSN330; SOT-23-5
U8: NE555D; SOIC-8_3.9x4.9mm_P1.27mm

Connections:
+3V3: C13.1, C14.1, C16.1, JP2.2 (B), JP9.2 (B), R1.2, R2.2, R5.2, R6.2, R7.2, R9.2, R16.1, R20.2, R23.2, U1.5, U2.5, U5.5 (SENSE), U5.6 (VDD), U6.5 (VS), U8.4 (R), U8.8 (VCC)
/BLUE: ON/OFF1.4, R13.2
/GREEN: ON/OFF1.3, R4.2
/RED: ON/OFF1.2, R17.2
/SCL: R6.1, RASPY1.3, U6.4 (SCL)
/SDA: R5.1, RASPY1.2, U6.3 (SDA)
/TRIG: C17.2, R24.1, U8.2 (TR), U8.6 (THR)
/VCC1: BATT1.1, C6.2, D1.2, D3.2 (A), Q3.1 (S), U4.13 (VIN1); also elsewhere on the board
/VCC2: ALIM1.1, C7.2, D2.2, D4.2 (A), Q4.1 (S), U4.4 (VIN2); also elsewhere on the board
/~BLINK: D7.1 (K), U8.3 (Q)
/~EN: JP3.1 (A), R8.1, TP4.1, U3.6 (EN/~EN)
/~EN1: D5.1 (K), R11.1, SELECTOR1.2, TP2.1, U4.16 (~EN1)
/~EN2: D6.1 (K), R12.1, SELECTOR1.3, TP3.1, U4.1 (~EN2)
/~INT: RASPY1.4, U3.5 (~INT)
/~KILL: JP4.1 (A), Q6.3 (D), R22.1, TP6.1
/~ONST1: R2.1, U1.1, U4.9 (~ONST1)
/~ONST2: R9.1, U2.1, U4.8 (~ONST1)
/~PB: ON/OFF1.6, TP1.1, U3.2 (~PB)
/~PH: D8.1 (K), JP1.1 (A), R1.1, R7.1, RASPY1.5, TP5.1, U1.2, U2.2, U5.3 (~MR)
GND: ALIM1.2, BATT1.2, C1.1, C2.1, C3.1, C4.1, C5.2, C8.1, C9.2, C10.2, C11.1, C12.1, C13.2, C14.2, C15.2, C16.2, C17.1, D1.1, D1.3, D2.1, D2.3, JP1.2 (B), JP7.1 (A), JP8.1 (A), ON/OFF1.5, OUT1.2, Q1.2 (S), Q2.2 (S), Q5.2 (S), Q6.2 (S), R3.1, R10.1, R11.2, R12.2, R18.2, R19.1, RASPY1.6, SELECTOR1.6, U1.3, U2.3, U3.4 (GND), U4.15 (GND), U5.2 (GND), U6.6 (GND), U7.2 (GND), U8.1 (GND); also elsewhere on the board
unnamed: C1.2, C2.2, U3.3 (ONT)
unnamed: C4.2, U3.7 (OFFT)
unnamed: C5.1, U4.14 (VCC)
unnamed: C6.1, U4.11 (CPO1)
unnamed: C7.1, U4.6 (CPO2)
unnamed: C8.2, Q3.2 (G), R14.1, R19.2
unnamed: C9.1, Q4.2 (G), R15.1, R18.1
unnamed: C10.1, JP5.2 (B), JP6.2 (B), U7.1 (IN), U7.3 (EN)
unnamed: C11.2, U8.5 (CV)
unnamed: C12.2, U5.4 (CT)
unnamed: C15.1, JP9.1 (A), U7.5 (OUT)
unnamed: D5.2 (A), D6.2 (A), JP3.2 (B)
unnamed: D7.2 (A), D8.2 (A), Q5.1 (G), R16.2
unnamed: JP2.1 (A), RASPY1.1
unnamed: JP4.2 (B), U3.8 (~KILL)
unnamed: JP7.2 (B), U6.2 (A0)
unnamed: JP8.2 (B), U6.1 (A1)
unnamed 37: OUT1.1, RSHUNT1.1, U6.7 (IN-); also elsewhere on the board
unnamed: Q1.1 (G), R3.2, U1.4
unnamed: Q1.3 (D), R4.1
unnamed: Q2.1 (G), R10.2, U2.4
unnamed: Q2.3 (D), R13.1
unnamed: Q5.3 (D), R17.1
unnamed: Q6.1 (G), R20.1, U5.1 (~RESET)
unnamed: R14.2, U4.12 (GATE1)
unnamed: R15.2, U4.5 (GATE2)
unnamed: R23.1, R24.2, U8.7 (DIS)
VCC: JP5.1 (A), ON/OFF1.1, Q3.3 (D), Q4.3 (D), RSHUNT1.2, SELECTOR1.4, U4.7 (OUT2), U4.10 (OUT1), U6.8 (IN+)
VDD: C3.2, D3.1 (K), D4.1 (K), JP6.1 (A), R8.2, R22.2, SELECTOR1.1, U3.1 (VIN)

Notes on the sheet:
May need 10nF (to test)
Power inputs
Switches
Raspy connector
Power Input Selector
3.3V
Blinking signal generation
Signal delayer
This board was designed for: - Controlling the power input of the robot with a push button. - Select the power source between a battery or an external alimentation.
The push button control system uses a LTC2950. To turn on the robot, press the push button 2s. If the Raspberry hasn't turned on in 5s, the robot will turn off. To turn off the robot, there are 2 ways: - Press the push button less than 5s. The Raspberry Pi will confirm the shutdown and the robot wi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
The power source selection system use a LTC4353. By default, the LTC4353 is in ideal diode mode, so it will choose automatically the power source by comparing the voltage. We can override the ideal diode mode using a 3 state switch to select manually the power source.
The selected push button has 3 leds (Red, Green and Blue). - It will blink red when the system is turning on and off. - It will be green when the selected power source is the battery. - It will be blue when the selected power source is the external alimentation.
TODO Reset ?
An INA219 is used to measure the output current/voltage.
The power sources are protected with: - A fuse (20-30A) - A diode to prevent polarization inversion.
JP1 is used if you don't connect a Raspberry
Important signals: - VCC1/VCC2: Input power (14-18V). - VDD: Logical power (14-18V). - VCC: Output power (14-18V). - SDA/SLC: INA219 I2C (3.3V). - ~INT: output signal of the LT2950 when the push button was pressed. - ~PH: output signal of the Raspberry if we need to hold the power. - ~KILL: delayed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
List of ICs: - LTC2950: push button controller. - LTC4353: power source selector. - NCP718: 3.3V regulator. - TSP3808: current supervisor used for delaying shutdown delay. - NE55: precision timer used for blinking the red led.
A fuse is present on each power input
Push button controller
Current/Voltage measure
3.3V Regulation
Green and Blue led truth table /PH /ONST O 0 0 1 0 1 0 1 0 0 1 1 0
Red led truth table /PH /Bl O 0 0 0 0 1 0 1 0 0 1 1 1
Leds

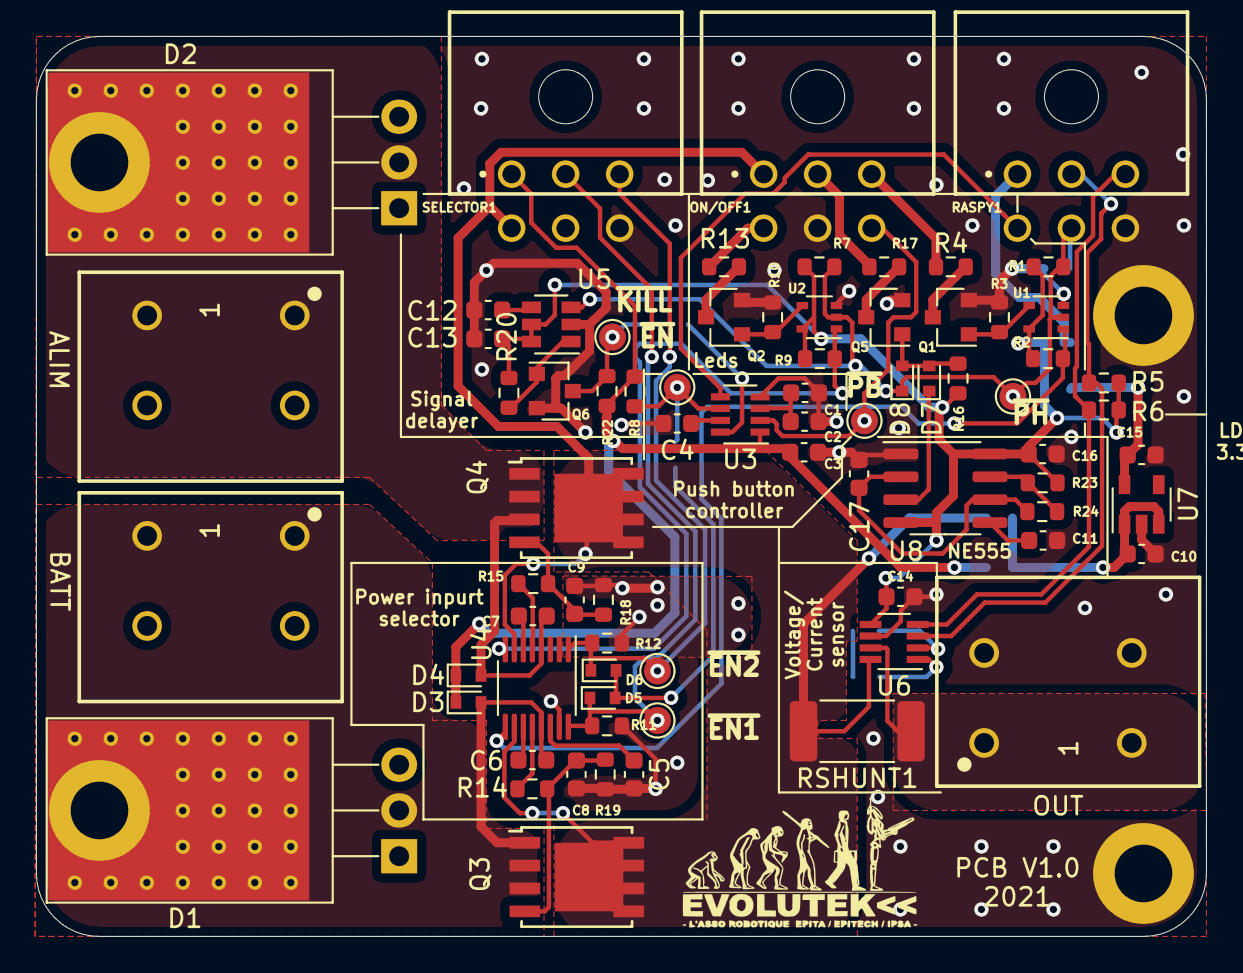
[picture p83: board Power Commuter Board V1.kicad_pcb from above]

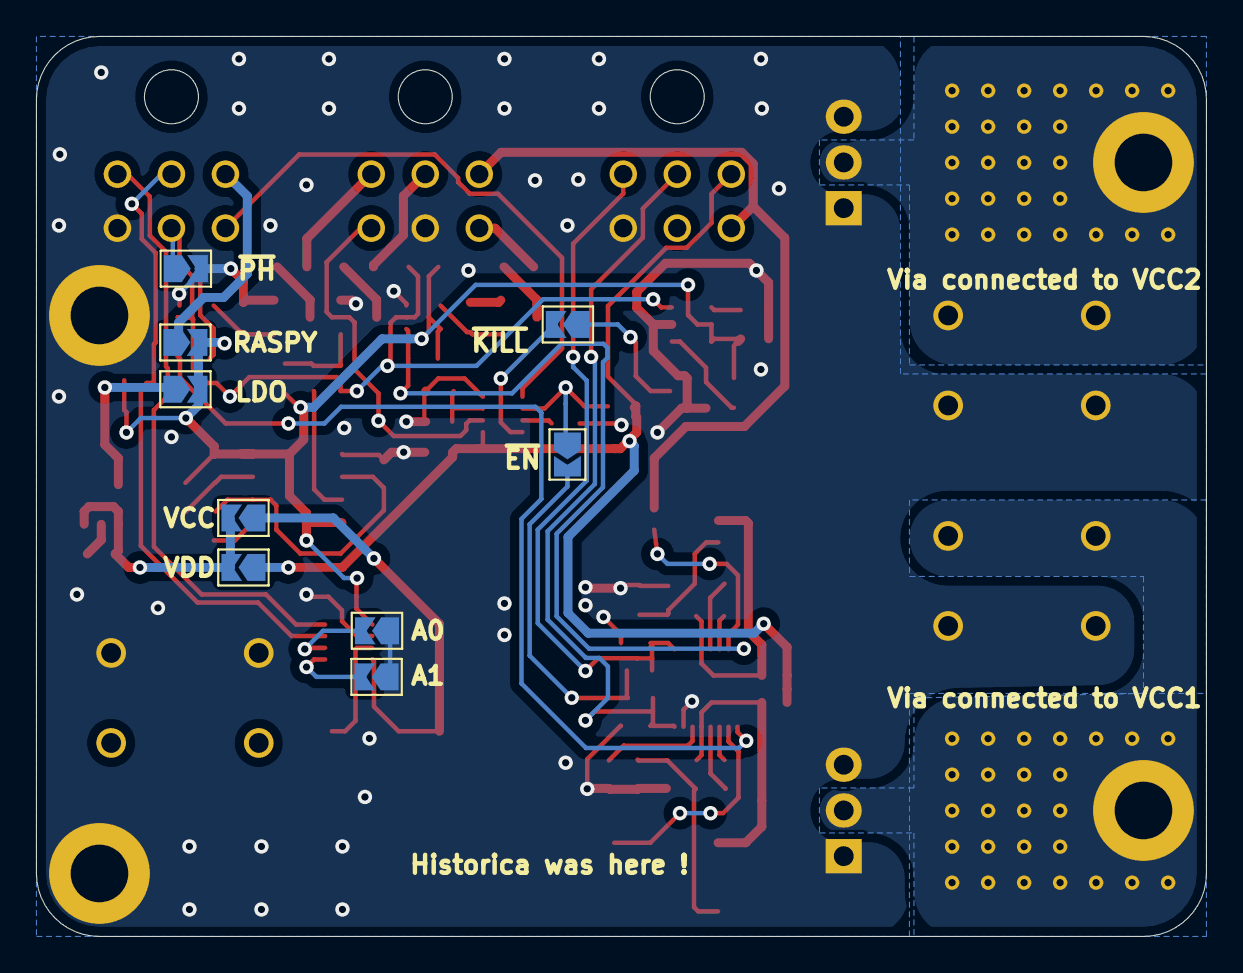
[picture p84: board Power Commuter Board V1.kicad_pcb from below]

Board: 2 copper layers, 65.0 x 50.0 mm, 85 parts (9 on the bottom side), 49 nets.

Other parts of the board:
ALIM: Conn_01x02_Male; 691406710002B
BATT: Conn_01x02_Male; 691406710002B
OUT: Conn_01x02_Male; 691406710002B
e: MountingHole_3.2mm_M3_DIN965_Pad

Their connections:
/VCC1: BATT.1; also elsewhere on the board
/VCC2: ALIM.1; also elsewhere on the board
GND: ALIM.2, BATT.2, OUT.2, e.1; also elsewhere on the board
unnamed 37: OUT.1; also elsewhere on the board
