evolutek/carte-alim/Hub puissance V1/Hub puissance V1.kicad_pcb

## KiCad design Hub puissance V1/Hub puissance V1.kicad_pcb (2021-03-19, an earlier design)

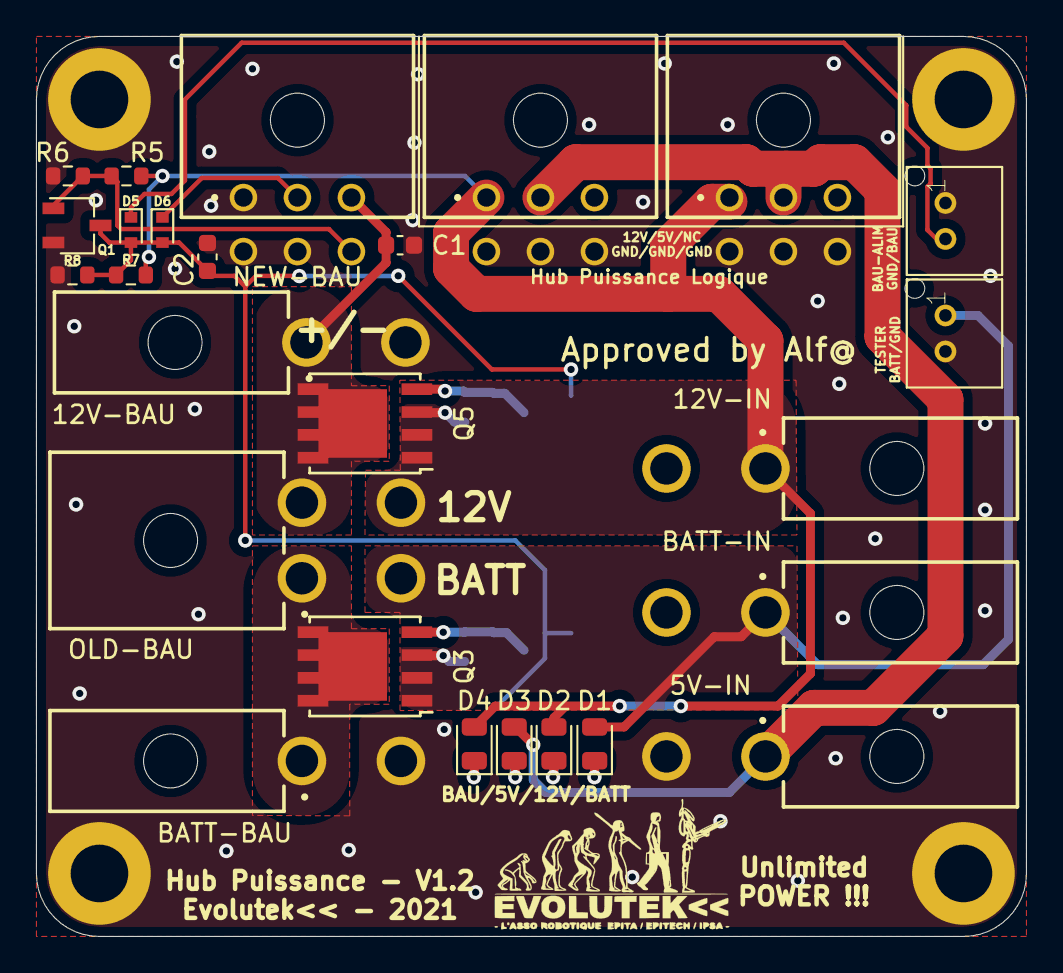
[picture p85: board Hub puissance V1.kicad_pcb from above]

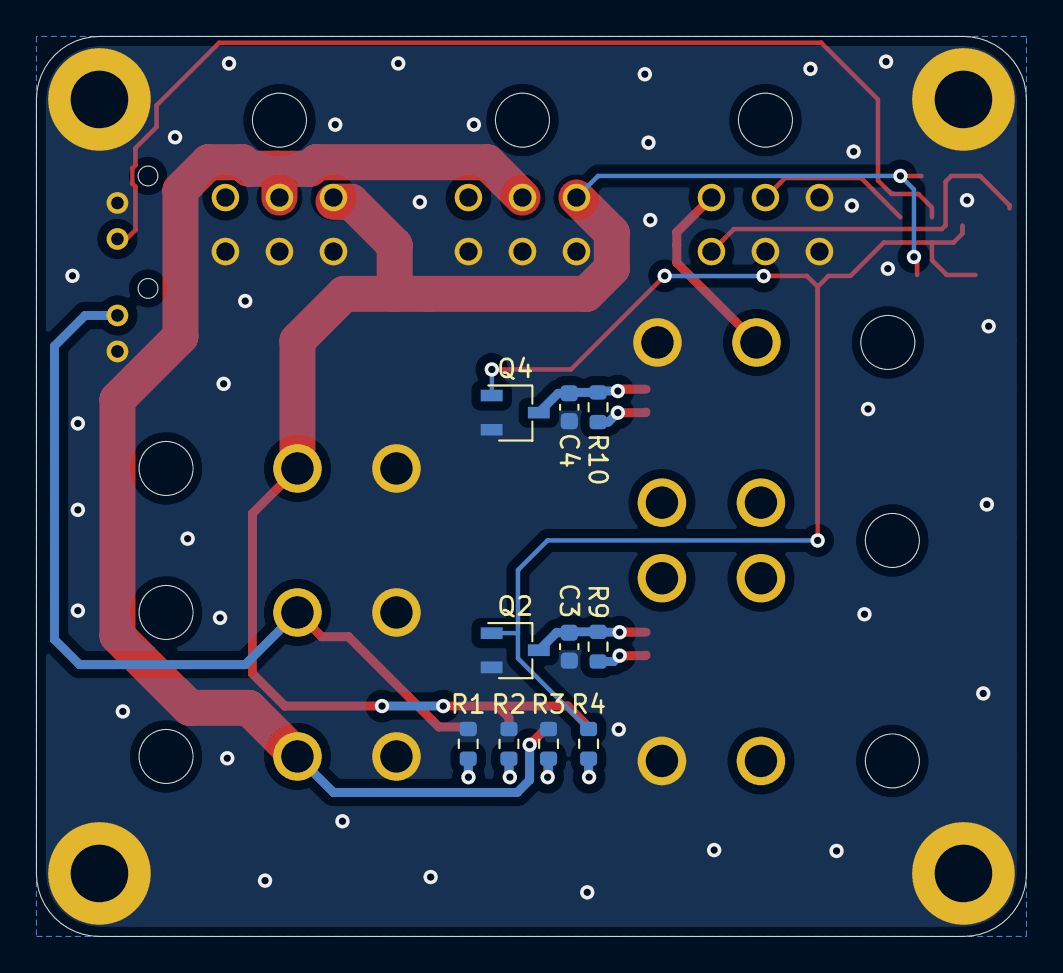
[picture p86: board Hub puissance V1.kicad_pcb from below]

Board: 2 copper layers, 55.0 x 50.0 mm, 36 parts (10 on the bottom side), 16 nets.

Parts:
5V-IN, 12V-BAU, 12V-IN: Conn_01x02_Male; 649002227222
BATT-BAU: Conn_01x02_Male; 649002227222
BATT-IN: Conn_01x02_Male; 649002227222
BAU-ALIM1: Conn_01x02_Male; B02B-PASK
C1, C2: 100nF; C_0603_1608Metric
C3, C4: 4.7uF; C_0603_1608Metric
D1, D2, D3: RED; LED_0805_2012Metric
D4: YELLOW; LED_0805_2012Metric
D5, D6: D; D_SOD-523
NEW-BAU: Conn_01x06_Male; 66200621022
OLD-BAU: Conn_01x04_Male; 649004227222
OUT1, OUT2: Conn_01x06_Male; 66200621022
Q1, Q2, Q4: Q_NMOS_GSD; TSOT-23
Q3, Q5: Q_NMOS_SGD; PowerPak-SO8_5.15x6.15mm_Pitch1.27mm
R1: 820; R_0603_1608Metric
R2, R4: 510; R_0603_1608Metric
R3: 150; R_0603_1608Metric
R5, R6, R7, R8, R9, R10: 10k; R_0603_1608Metric
Tester1: Conn_01x02_Male; B02B-PASK

Connections:
+5V: 5V-IN.1, D3.2, OUT1.2, OUT2.2
+12V: 12V-IN.1, D2.2, D4.2, OLD-BAU.4, OUT1.1, OUT2.1, Q5.1, R5.1, R7.1, R10.2
+BATT: BATT-IN.1, D1.2, OLD-BAU.3, Q3.1, R9.2, Tester1.1
/12V-BAU: 12V-BAU.1, C1.2, NEW-BAU.3, OLD-BAU.2, Q5.3
/BATT-BAU: BATT-BAU.1, OLD-BAU.1, Q3.3
/~BAU: C2.1, D5.2, D6.2, Q1.3, Q2.1, Q4.1, R4.2, R7.2, R8.1
GND: 5V-IN.2, 12V-BAU.2, 12V-IN.2, BATT-BAU.2, BATT-IN.2, BAU-ALIM1.1, C1.1, C2.2, C3.2, C4.2, NEW-BAU.1, NEW-BAU.4, NEW-BAU.5, OUT1.4, OUT1.5, OUT1.6, OUT2.4, OUT2.5, OUT2.6, Q1.2, Q2.2, Q4.2, R1.2, R2.2, R3.2, R6.1, R8.2, Tester1.2
unnamed: BAU-ALIM1.2, D5.1
unnamed: C3.1, Q2.3, Q3.2, R9.1
unnamed: C4.1, Q4.3, Q5.2, R10.1
unnamed: D1.1, R1.1
unnamed: D2.1, R2.1
unnamed: D3.1, R3.1
unnamed: D4.1, R4.1
unnamed: D6.1, NEW-BAU.2
unnamed: NEW-BAU.6, Q1.1, R5.2, R6.2
