evolutek/carte-alim/V5/carte-alim-v5.ioc

Mcu.UserName=STM32G491KEUx
PA0.GPIO_Label=G1S
PA0.Signal=GPIO_Input
PA1.GPIO_Label=RESET_5P
PA1.Signal=GPIO_Output
PA10.GPIO_Label=INT
PA10.Signal=GPIO_Output
PA11.GPIO_Label=CAN_RX
PA11.Signal=FDCAN1_RX
PA12.GPIO_Label=CAN_TX
PA12.Signal=FDCAN1_TX
PA13.GPIO_Label=SWDIO
PA13.Signal=SYS_JTMS-SWDIO
PA14.GPIO_Label=SWCLK
PA14.Signal=SYS_JTCK-SWCLK
PA15.GPIO_Label=RESET_ODRIVE
PA15.Signal=GPIO_Output
PA2.GPIO_Label=VCP_TX
PA2.Signal=USART2_TX
PA3.GPIO_Label=VCP_RX
PA3.Signal=USART2_RX
PA4.GPIO_Label=AU_STM32
PA4.Signal=GPIO_Output
PA5.GPIO_Label=AU_EXT
PA5.Signal=GPXTI5
PA6.GPIO_Label=AU_ROBOT
PA6.Signal=GPXTI6
PA7.GPIO_Label=POWER_HOLD
PA7.Signal=GPXTI7
PA8.Signal=I2C2_SDA
PA9.Signal=I2C2_SCL
PB0.GPIO_Label=RESET_12P
PB0.Signal=GPIO_Output
PB3.GPIO_Label=SWO
PB3.Signal=SYS_JTDO-SWO
PB4.GPIO_Label=STATUS
PB4.Signal=GPIO_Output
PB5.GPIO_Label=POWER_STATUS
PB5.Signal=GPIO_Input
PB6.GPIO_Label=BLUE_CHANNEL
PB6.Signal=S_TIM4_CH1
PB7.GPIO_Label=RED_CHANNEL
PB7.Signal=S_TIM4_CH2
PB8-BOOT0.GPIO_Label=GREEN_CHANNEL
PB8-BOOT0.Signal=S_TIM4_CH3
PF0-OSC_IN.GPIO_Label=INT_LTC
PF0-OSC_IN.Signal=GPXTI0
PF1-OSC_OUT.GPIO_Label=KILL
PF1-OSC_OUT.Signal=GPIO_Output
