evolutek/carte-alim/(commit log)

2020-05-22 Add V3
    [Board.PcbDoc, EvoFootprints.PcbLib, EvoPowerMain.PrjPCB, EvoSchematic.SchLib, Pw_board V3.kicad_pcb, RegPowerFootprint.PcbLib, schemaPower.SchDoc]
2020-06-12 Add V4
    [Carte Alim.kicad_pcb, Carte Alim.sch]
2020-08-15 Add Molex AX12 and correct errors
    [Carte Alim.kicad_pcb, Carte Alim.sch]
2020-11-14 Add Coffee Machine Logo and update silk screens
    [Carte Alim.kicad_pcb, Carte Alim.sch]
2021-01-09 Add Hub Puissance V1.0
    [Hub puissance V1.0.kicad_pcb, Hub puissance V1.0.sch, Hub puissance V1.0.step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]
2021-01-17 Update New BAU connector in Hub Puissance V1.0
    [Hub puissance V1.0.kicad_pcb, Hub puissance V1.0.sch, Hub puissance V1.0.step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]
2021-01-19 Reduce Hub Puissance V1.0 size
    [Hub puissance V1.0.kicad_pcb, Hub puissance V1.0.step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]
2021-01-24 Add BAU signal comming from external ALIM
    [Hub puissance V1.0.kicad_pcb, Hub puissance V1.0.sch]
2021-01-24 Add Selecteur Entree Puissance V1.0
    [Selecteur Entree Puissance V1.0.kicad_pcb, Selecteur Entree Puissance V1.0.sch]
2021-01-28 Update BAU circuit
    [Hub puissance V1.0.kicad_pcb, Hub puissance V1.0.sch]
2021-01-31 pdf, bom
    [Hub puissance V1.0.kicad_pcb]
2021-02-14 Add Hub Puissance V1.1 with correct Mosfets
    [Hub puissance V1.0.kicad_pcb, Hub puissance V1.0.sch]
2021-02-14 First version of theselecteur pcb
    [Selecteur Entree Puissance V1.0.kicad_pcb, Selecteur Entree Puissance V1.0.sch]
2021-02-21 Add PCB V1.0 (previously Selecteur Entree Puissance V1.0)
    [Power Commuter Board V1.0.kicad_pcb, Power Commuter Board V1.0.sch, Selecteur Entree Puissance V1.0.kicad_pcb, Selecteur Entree Puissance V1.0.sch]
2021-02-21 Clean Hub Puissance files
    [Hub puissance V1.0-job.gbrjob]
2021-02-23 Clean Hub Puissance V1 and patch BAU
    [Hub puissance V1.0.kicad_pcb, Hub puissance V1.0.sch, Hub puissance V1.1.kicad_pcb, Hub puissance V1.1.sch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]
2021-02-23 Clean PCB V1.0
    [Power Commuter Board V1.0.kicad_pcb, Power Commuter Board V1.0.sch]
2021-03-19 Release V1.2 of Hub Puissance Board
    [Hub puissance V1.1.kicad_pcb, Hub puissance V1.1.sch, Hub puissance V1.kicad_pcb, Hub puissance V1.sch]
2021-08-06 V1.1 of PCB board
    [Power Commuter Board V1.0.kicad_pcb, Power Commuter Board V1.0.sch, Power Commuter Board V1.kicad_pcb, Power Commuter Board V1.sch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]
2021-08-13 WIP of V4.1 of the alim board
    [AU.sch, Carte Alim.sch, Converters.sch, Input.sch]
2021-08-15 Fix schematics labels, generate net list and board layout
    [AU.sch, Carte Alim.kicad_pcb, Carte Alim.sch, Converters.sch, Input.sch]
2021-08-15 Fix schematics
    [AU.sch, Input.sch]
2021-08-15 WIP PCB
    [Carte Alim.kicad_pcb, Carte Alim.sch]
2021-10-23 Add a new board for a battery rack
    [Carte Rack Batterie V1.kicad_pcb, Carte Rack Batterie V1.sch]
2021-10-24 Correct XT60 pinout
    [Carte Rack Batterie V1.kicad_pcb, Carte Rack Batterie V1.sch]
2021-10-24 WIP v2 version of PCB board
    [Power Commuter Board V2.kicad_pcb, Power Commuter Board V2.sch]
2021-10-24 Corrected schematics
    [Power Commuter Board V2.kicad_pcb, Power Commuter Board V2.sch]
2021-10-24 First version of the PCB
    [Power Commuter Board V2.kicad_pcb, Power Commuter Board V2.sch]
2021-10-24 After Alf@ review
    [Power Commuter Board V2.kicad_pcb]
2021-10-24 Move board into Vertical version
    [Carte Rack Batterie V1.kicad_pcb, Carte Rack Batterie V1.sch, Carte Rack Batterie Vertical V1.kicad_pcb, Carte Rack Batterie Vertical V1.sch, Carte Rack Batterie Vertical V1.step]
2021-10-24 Fix missing 3D model for JST XH 5
    [Carte Rack Batterie Vertical V1.kicad_pcb]
2021-10-25 Add a horizontal version of the carte rack batterie
    [Carte Rack Batterie Horizontal V1.kicad_pcb, Carte Rack Batterie Horizontal V1.sch]
2021-11-28 Fix Carte Rack Batterie Vertical (V1.1)
    [Carte Rack Batterie Vertical V1.kicad_pcb, Carte Rack Batterie Vertical V1.sch]
2021-12-07 Fix PCB V2
    [Power Commuter Board V2.kicad_pcb, Power Commuter Board V2.sch]
2021-12-07 wip carte alim v4
    [AU.sch, Carte Alim.kicad_pcb, Carte Alim.sch, Converters.sch, Input.sch]
2021-12-07 First shot at full routing of the board. To be improved further.
    [Carte Alim.kicad_pcb, Carte Alim.sch, Input.sch]
2021-12-09 Release Carte Alim V4
    [AU.sch, Carte Alim.kicad_pcb, Carte Alim.sch, Converters.sch, Input.sch]
2022-03-16 Release V4.1
    Fix
    [AU.sch, Carte Alim.kicad_pcb, Carte Alim.sch, Converters.sch, Input.sch]
2022-04-29 Fix with V4.2
    [AU.sch, Carte Alim.kicad_pcb, Carte Alim.sch, Converters.sch, Input.sch]
2022-04-30 Fix silkscreen
    [AU.sch, Carte Alim.kicad_pcb, Carte Alim.sch]
2022-11-11 V1.0 of the Carte Boitier BAU
    [Carte Boitier BAU.kicad_pcb, Carte Boitier BAU.sch]
2022-12-02 Release V1.1 of carte boitier BAU
    [Carte Boitier BAU.kicad_pcb, Carte Boitier BAU.sch]
2023-04-28 WIP Mini carte alim V1
    [Mini carte alim V1.kicad_pcb, Mini carte alim V1.kicad_sch]
2023-04-28 V1.0 of Mini carte alim
    [Mini carte alim V1.kicad_pcb, Mini carte alim V1.kicad_sch]
2023-04-29 Move R1 to top
    [Mini carte alim V1.kicad_pcb]
2023-04-30 More compact version
    [Mini carte alim V1.kicad_pcb, Mini carte alim V1.kicad_sch]
2023-04-30 Fix some planes
    [Mini carte alim V1.kicad_pcb]
2023-07-25 V1.1 with a diode to prevent polarity inversion
    [Mini carte alim V1.kicad_pcb, Mini carte alim V1.kicad_sch]
2023-07-29 Add vertical output connectors and minor improvments
    [Mini carte alim V1.kicad_pcb, Mini carte alim V1.kicad_sch]
2023-10-14 Wip Mini Carte Alim V2, need to correct some errors
    [Mini carte alim V2.kicad_pcb, Mini carte alim V2.kicad_sch]
2023-10-15 Mini Carte Alim V2.0
    [Mini carte alim V2.kicad_pcb, Mini carte alim V2.kicad_sch]
2023-11-05 Fix Mini carte alim V2
    [Mini carte alim V2.kicad_pcb, Mini carte alim V2.kicad_sch]
2023-12-16 Mini carte alim V2.1
    [Mini carte alim V2.kicad_pcb, Mini carte alim V2.kicad_sch]
2023-12-19 Update connecting indications
    [Mini carte alim V2.kicad_sch]
2024-01-22 USB C panel mount V1
    [USB C montage panneau.kicad_pcb, USB C montage panneau.kicad_sch]
2024-01-22 Clean board and generate ouput files
    [USB C montage panneau.kicad_pcb, USB C montage panneau.kicad_sch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]
2024-01-22 Clean file
    [USB C montage panneau-job.gbrjob]
2024-02-17 WIP Carte alim V5
    [AU.kicad_sch, Carte Alim.kicad_pcb, Carte Alim.kicad_sch, input.kicad_sch, stm32.kicad_sch]
2024-02-25 WIP Schematics
    [AU.kicad_sch, Carte Alim.kicad_sch, converters.kicad_sch.kicad_sch, input.kicad_sch, stm32.kicad_sch]
2024-03-10 Clean schematics and start PCB
    [AU.kicad_sch, Carte Alim.kicad_pcb, Carte Alim.kicad_sch, converters.kicad_sch.kicad_sch, input.kicad_sch, stm32.kicad_sch]
2024-03-10 Rename Converters sheet
    [Carte Alim.kicad_sch, converters.kicad_sch]
2024-03-10 WIP placement (it's short)
    [Carte Alim.kicad_pcb]
2024-03-12 Mapping STM32 and PCB ongoing
    [AU.kicad_sch, Carte Alim.kicad_pcb, Carte Alim.kicad_sch, converters.kicad_sch, input.kicad_sch, stm32.kicad_sch]
2024-03-12 Mapping Done, routing simple complex
    [AU.kicad_sch, Carte Alim.kicad_pcb, Carte Alim.kicad_sch, converters.kicad_sch, input.kicad_sch, output_connectors.kicad_sch, power_tree.kicad_sch, stm32.kicad_sch]
2024-03-24 PCB done, needs to be checked
    [AU.kicad_sch, Carte Alim.kicad_pcb, Carte Alim.kicad_sch, converters.kicad_sch, input.kicad_sch, output_connectors.kicad_sch, power_tree.kicad_sch, stm32.kicad_sch]
2024-03-26 Add production files for Evolutek
    [AU.kicad_sch, Carte Alim.kicad_pcb, Carte Alim.kicad_sch, converters.kicad_sch, input.kicad_sch, output_connectors.kicad_sch, power_tree.kicad_sch, stm32.kicad_sch]
2024-03-26 Add Goldorak variante of production files
    [Carte Alim-job.gbrjob]
2024-12-21 WIP V5.1
    [AU.kicad_sch, Carte Alim.kicad_pcb, converters.kicad_sch, input.kicad_sch, output_connectors.kicad_sch, stm32.kicad_sch]
2025-01-15 Release V5.1 variante Evolutek
    [AU.kicad_sch, Carte Alim.kicad_pcb, Carte Alim.kicad_sch, converters.kicad_sch, input.kicad_sch, output_connectors.kicad_sch, power_tree.kicad_sch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]
2025-02-26 Release Mini carte AU V1.0
    [min-carte-au.kicad_pcb, min-carte-au.kicad_sch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]
2025-02-27 Minor fixes on V1.0
    [min-carte-au.kicad_pcb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]
2025-03-02 Add carte dock lp-e10
    [carte-dock-lp-e10.kicad_pcb, carte-dock-lp-e10.kicad_sch]
2025-03-11 Carte Dock LP-E10 update
    minimise
    [carte-dock-lp-e10.kicad_pcb, carte-dock-lp-e10.kicad_sch]
2025-03-21 Minor fixes on V5.1
    [Carte Alim.kicad_pcb, Carte Alim.kicad_sch, converters.kicad_sch, stm32.kicad_sch]
2025-03-21 Fix board outline and add fab files
    [carte-dock-lp-e10.kicad_pcb, carte-dock-lp-e10.kicad_sch, carte-dock-lp-e10.step]
2025-03-26 Update R7/R8 value
    [AU.kicad_sch, Carte Alim.kicad_pcb, Carte Alim.kicad_sch, converters.kicad_sch, input.kicad_sch, output_connectors.kicad_sch, power_tree.kicad_sch, stm32.kicad_sch]
2025-04-14 Release V1.1
    [min-carte-au.kicad_pcb, min-carte-au.kicad_sch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]
2025-05-14 Release Micro Carte Alim V1.0
    [Micro Carte Alim V1.kicad_pcb, Micro Carte Alim V1.kicad_sch]
